NathanHowell/minimeater/hw/tools/README.md

# PCB scripts

The board is laid out by hand through Konnect (live KiCad); see `hw/layout/README.md`. The first-pass autorouter and
its one-off rework scripts were retired (in git history before the re-layout).

- `pcbdump.py <board> <out.json>` (KiCad's python): pads, tracks, vias, zone fills, courtyards to JSON.
- `render.py <dump.json> <out.png> [--refs ... | --bbox ...] [--layers ...] [--rats]` (uv, matplotlib): copper
  coloured and labelled by net, for layout reviews.
- `montage.py <dump.json> <out.png>` (uv, matplotlib + pillow): every block and the board at one scale, coloured by
  netclass (render.py `--by-class`), for placement reviews. Every net leaving a block (GND aside) gets a port arrow
  at its exit (open track end, else the pad nearest the edge) labelled `net > destinations` and coloured by
  destination; the fixed parts' pins get the same, pointing into the board (render.py `--ports`, `--only`).
- `blockcheck.sh <x0,y0,x1,y1> <out.png> "<title>"`: DRC items inside a block's box (`drcbox.py`) plus its F.Cu render.
- `parts.py` (`just hw::parts <out.json>`): each reference's footprint and courtyard box from the schematic and libraries.
- `kdrc.py`: kicad-cli DRC from KiCad's python, returns the violations.
- `fab.py` (`just hw::fab`): gerber zip, JLC BOM and CPL into `hw/fab/`, from a zone-refilled copy;
  plus a one-up assembly panel (`minimeater-panel-*`: 5 mm rails left and right, mouse bites, three 1.152 mm NPTH
  tooling holes and three fiducials on the rails) when KiKit is installed in `hw/.kikit` (see the script's docstring).
- `silk.py` (KiCad's python, KiCad closed): the silk pass. References at JLC minimum size placed beside their part
  where they fit, else hidden; back-silk labels for the test points (net names) and J6/J7 (FAN/SERVO).
- `silk_back.py` (KiCad's python, KiCad closed, after silk.py): the back's artwork, the face seen with the case open.
  Probe numbers P0-P3 between the jack pegs, the flame, wordmark and open-source-hardware mark, rev/date, JLC's order-number marker, a QR code to
  the repository (KiCad 10 barcode, knocked out of a silk square so it reads dark-on-white), KK pin names, USB. Kept in
  the group `silk_back`, which a rerun replaces; it refuses to save if anything lands on a pad, hole, via or other silk.
- `stitch.py` (KiCad's python): edge GND stitching via candidates (JSON), plus a scratch copy with them added for a
  refilled DRC; the vias then go in through Konnect.
- `models.py`: 3D models for the mech assembly (`src/minimeater/mech/board3d.py`).
- `kk_ra_step.py`, `kk_ra.py`: the right-angle KK header STEP model and footprint.
- `connector_edge.py`: trims the connector edge so the jacks reach into the port wall (applied).

DRC: `hw/minimeater.kicad_dru` relaxes `hole_clearance` to 0.19 mm for J1 only (the GCT USB4105-GF-A land pattern
puts its GND pads 0.1944 mm from the locating pegs), and KiCad's 1 mm barcode separation to 0.3 mm (the QR code's
quiet zone is its own silk border).
