NathanHowell/minimeater/docs/cfd.md

# Duct CFD and acoustics

What the air does between the fan and the tube: the pressure the duct costs the fan (`.2.12`, `.2.13`), and whether the
flap can whistle (`.2.17`-`.2.19`). The code is `src/minimeater/mech/cfd/`; the geometry comes from the same build123d
parts as the print (`mech/parts.py`), so a change to the duct or the flap is a change to the case.

## Steady RANS: `just mech::cfd::run <case>`

`just mech::cfd::run <case> [--flap DEG] [--cfm Q] [--rpm N]` builds the air volume, meshes it and solves it in
OpenFOAM v2606 (`opencfd/openfoam-run:2606`, arm64, in Apple's `container`; no build), and writes
`build/cfd/<case>/results.json`. Named cases: `open`, `open-swirl`, `open-vortex`, `flap-30`, `flap-45`, `flap-60`.

- **Geometry** (`geometry.py`): the fan's outlet annulus (5 mm of the frame's Ø58 bore around the Ø26.5 hub), the
  27 mm cone with the tail cone and its six stator vanes (`HubCone`, subtracted solid), the Ø32 bore with the flap and its rod at the case's angle, the 5 mm neck from it to the tube's bore at the socket's
  shoulder, and 12 diameters of the Ø30.83 tube (the results below were run on the Ø31.6 tube assumed before
  the calipers, a 0.2 mm step and no neck). Patches: inlet, outlet, duct, tube, flap. The fan's blades and struts
  are not modelled; the inlet can swirl: solid-body rotation at `--rpm`, or a free vortex at `--vortex` (r·c_θ / Q in 1/m, in the rotor's sense; `open-vortex` is 18, the Euler floor at the operating line). Every case samples U on five planes along the duct at its end; `python -m minimeater.mech.cfd.swirl <case>` reports the swirl angle, r·c_θ and the swirl's dynamic head on each.
- **Mesh**: snappyHexMesh, 2 mm background, 0.5 mm at the duct's walls, 0.25 mm on the flap, 1 mm through the bore and
  the first two tube diameters; 3 boundary layers (2 on the flap). About 0.75 M cells.
- **Solver**: simpleFoam (SIMPLEC), k-omega SST with wall functions; the fan's flow fixed into the annulus at 10 %
  turbulence; the outlet at 0 Pa. Up to 2000 iterations, 8 ranks: about 20 minutes on the Mac.
- **Loss** (`run.py`): static pressure on planes across the tube, one per diameter; a line through the last six (the
  developed flow) extrapolated back to the shoulder. Referenced to the tube's velocity head q:
  - `k_static` = (inlet static - line at the shoulder) / q: what the fan's (static) curve must supply for the duct,
    including the acceleration from the annulus into the tube. It replaces `Intake.k_box + k_entry` less the grille.
  - `k_total` = the total-pressure loss: what is dissipated.
  - The tube's own friction is in neither; the fitted line's slope is checked against Blasius.

### Results, 6 CFM (3.8 m/s in the tube)

Re-run 2026-10-18 on the current geometry (the neck, the Ø30.83 tube, the cone and its six vanes; 2000 iterations, 8 ranks,
17-28 minutes a case). The table before it was the Ø31.6 tube with no neck and no vanes: the open duct was 1.26 / 0.16, so the
neck, cone and vanes cost about 1 k_static and 1 k_total; the flap's own part is about what it was. The last two rows are at
4.2 CFM with the fan's exit profile (not 6 CFM straight).

| case | k_static | k_total | duct Δp static | tube f (Blasius 0.034) | note |
|---|---|---|---|---|---|
| open | 2.23 | 1.15 | 23.1 Pa | 0.037 | steady |
| flap 30° | 4.43 | 3.35 | 43.1 Pa | 0.047 | sheds |
| flap 45° | 11.9 | 10.9 | 107.6 Pa | 0.041 | the wake sheds; the tube has not recovered by the outlet |
| flap 60° | 52.3 | 51.2 | 457 Pa | 0.039 | far past the fan's 21 Pa shut-off, so 6 CFM never happens here (the k still holds) |
| open, the fan's exit profile, 4.2 CFM | 1.51 | 1.87 | 8.6 Pa | 0.043 | the operating point's flow, with `fan-4.2cfm-3000rpm/profile.json` as the inlet |
| flap 30°, the same | 3.84 | 4.20 | 18.6 Pa | 0.047 | |
| open, swirl 2000 rpm | 8.3 | 8.7 | 70.9 Pa | — | solid-body rotation at the rotor's speed: an upper bound, not the fan |

The swirl case is a warning, not a number: if the fan's exit swirl were anything like solid-body rotation the cone
(which spins it up as it narrows) and the bore would cost several times the straight-flow loss. The real exit swirl of
the NF-A6x25 at these flows is the input that is missing (bake-off rig, `.2.11`, or a fan model); stator vanes in the
cone are the remedy if it is large (`.2.13`).

### The tail cone's struts against stator vanes (`.2.25`, 2026-10-16)

Coarse (807k cells, base 2 mm, 8 ranks on the Mac, about 25 minutes a case), 6 CFM, the measured tube and the neck. The
swirl is a free vortex at the inlet, r·c_θ / Q = 18 per metre in the rotor's sense (Euler's floor on the model's
operating line; `HubCone.swirl`). The swirl cases were not re-run on 2026-10-18: the straight-strut rows predate the neck and the tail cone (their no-swirl case was 1.30 against 2.23 now for the open duct at 6 CFM), so read them for the differences between rows.

| tail cone held by | inlet swirl | duct Δp static | k_static | swirl in the bore | r·c_θ in the bore | swirl head, tube |
|---|---|---|---|---|---|---|
| 3 straight struts | none | 14.6 Pa | 1.30 | 1° | 0 | 0 |
| 3 straight struts | free vortex 18 | 25.1 Pa | 2.40 | 42° | -334 cm²/s | 1.7 Pa |
| 6 stator vanes | none | 18.5 Pa | 1.69 | 11° | -62 cm²/s | 0.15 Pa |
| 6 stator vanes | free vortex 18 | 13.5 Pa | 1.17 | 9° | -43 cm²/s | 0.13 Pa |

With the fan's swirl the vanes take out 91 % of the angular momentum and save 11.6 Pa, more than the whole loss of the
plain duct without swirl. Their cost when the air arrives straight (+3.9 Pa over the struts) is the risk if the real
swirl is much less than the floor; the fan's own rotor in a rotating frame (`cfd/fan.py`) checks it.

With the fan's own exit as the inlet (`--profile`, from `cfd/fan.py` below, scaled to 6 CFM: about twice the floor's
swirl, turning 66-79° at the vanes' leading edges), the solidity-1.2 vanes drawn for the free vortex lose 16.9 Pa
(26° and 3.5 Pa of swirl head left in the bore). The vanes redrawn for that inflow (`HubCone.vane_beta`, solidity 1.3)
lose 16.1 Pa, with 24° and 2.8 Pa of swirl head in the bore and 0.26 Pa in the tube. Most of the angle left in the
bore is the hub and the tip turned in opposite senses (mean c_θ about 0), not net swirl.

The inlet redrawn as a designed pair of curves (the contraction's wall tangent to both bores and a tail cone closing at
18°, `cfd/inlet.py`, docs/mech.md) loses 16.07 Pa on the same profile inlet, with 22.7° and 2.6 Pa of swirl head in
the bore: the same as the straight cone. The vanes rebuilt as one fitted surface with a millimetre root fillet
(`vane_fillet`) on it: 16.21 Pa, the same within the coarse mesh's noise (0.22 Pa of swirl head in the tube either way).

Mesh check (2026-10-16): the final design (the designed inlet, the fitted vanes, the profile inlet) on a 1.4 mm
background (1.84 M cells, 46 minutes on 8 ranks) loses 15.98 Pa against 16.21 on the 2 mm one (0.84 M): 1.4 %, so
these coarse comparisons resolve about 1-2 % and differences inside that are ties. The swirl left is the same
(2.7 Pa of swirl head in the bore, 0.2 in the tube).

The model has carried k_box 2.0 + k_entry 0.5 = 2.5 for this path; the open duct is 2.23 at 6 CFM straight and 1.51 at 4.2 CFM on the fan's profile, without the grille. The duct
does not need a change for its loss. The 45° figure is inside the range published for butterfly valves (about 10-18). With the flap partly closed the
tube's friction reads high (0.043-0.050): the wake has not died out by the fitted planes, so those k carry some of the
tube's recovery; a longer tube (`tube_d`) is the fix when the numbers matter to better than ~10 %.

### The fan in a rotating frame (`cfd/fan.py`, 2026-10-16)

Noctua's NF-A6x25 model (`mock.fan_step`): frame and rotor, the rotor's cells turning (MRF), a square plenum ahead and
a pipe of the frame's outlet bore behind, sealed to the outlet face as the duct's flange is. Coarse, 8 ranks, about 21
minutes. At 4.2 CFM and 3000 rpm (about 25 % of free flow, the model's operating point) it gives 12.0 Pa static and
21.0 Pa total; the spec curve reads about 16 Pa static there, fair for a coarse rotor mesh. (A first run without the
seal let about 1 CFM loop round the frame's outside and read 6.4 Pa.)

At this flow the rotor is near stall. Inside r ≈ 17 mm the flow recirculates and the air leaves through r 21-29.
r·c_θ / Q runs from -17 to -56 per metre across the annulus, -39 flux-weighted: about twice Euler's floor of 18 that
the vanes were first drawn for. `profile.json` holds the binned c_x and r·c_θ, and `--profile` hands them to the duct
cases as their inlet (`Case.profile`, scaled to the case's flow).

### The intake grille and the gap to the rotor (`cfd/grille.py`, `.2.26`, 2026-10-16)

This is fan.py's case with a room behind the rear face (slip walls, uniform inflow 25 mm out). Then come the rear wall
with its grille, the cavity's section carried from the wall to the fan, and the fan with its sealed pipe. It is run at
the same flow and speed as the free-air case, so the static rise lost against 12.0 Pa is what the wall and the gap cost
the fan. The gap is added to `rear_gap` (4.5 mm); the S-louvre is the concept insert (round field, S blades, hub cover).

| grille | gap added | fan static rise | intake angle | backflow at the rotor face |
|---|---|---|---|---|
| none (fan.py) | | 12.0 Pa | | |
| current straight louvres | 0 | 2.9 Pa | 66° | 26 % |
| current straight louvres | 5 mm | 5.0 Pa | 68° | 35 % |
| current straight louvres | 10 mm | 6.7 Pa | 62° | 24 % |
| current straight louvres | 20 mm | 7.4 Pa | 60° | 21 % |
| current straight louvres | 30 mm | 8.3 Pa | 60° | 22 % |
| S-louvre concept | 5 mm | 1.1 Pa | 68° | 33 % |
| S-louvre concept | 10 mm | 4.0 Pa | 62° | 23 % |

The wall and the 4.5 mm gap cost the fan about three quarters of its static rise, and the gap is what matters: the
first 10 mm give back 3.8 Pa, the next 20 only 1.6 more. The S-louvre concept is worse than the straight louvres at the same gap; its deep field
and hub cover crowd the rotor's inflow. The mesh is coarse (grille level 2) and steady MRF of a fan near stall is the
weakest part of these models, so take the trend, not the numbers.

The gap is now 14.5 mm (`Layout.rear_gap`, `.2.28`). Run with the shells' own shim blocks and the four Ø4 rest pads
standing in the plenum (`gap` 0 at the new rear_gap), the fan keeps 7.3 Pa static (15.6 total), the intake at 60° with
23 % backflow: the pads, out at r 34 in the frame's corners, cost nothing measurable.

The chevron grille (eight gills, 1485 mm², the seam climbing with them) with the 5.1 mm rear wall and the 12.6 mm
plenum it leaves keeps 6.8 Pa (pitch 6.05 gave 7.0, so the pitch's last 0.07 mm is noise). Shaping the plenum
(`--plenum`, all at that grille):

| plenum | fan static rise | total | intake angle | backflow at the rotor face |
|---|---|---|---|---|
| plain | 6.8 Pa | 15.7 Pa | 61° | 25 % |
| ribs: 12 radial, 1.2 thick, r 25-34, wall to 2 mm off the frame | 11.1 Pa | 19.3 Pa | 52° | 22 % |
| the shells' ribs: the same, to 4 mm off the frame, with the fan's four M3 heads | 10.6 Pa | 18.4 Pa | 52° | 23 % |
| dome: a half-ellipsoid r 12.5 over the hub, 1 mm off it | 5.9 Pa | 14.6 Pa | 60° | 24 % |
| ring: r 29.5 separator at the tips, the ribs outside it | 3.9 Pa | 12.4 Pa | 66° | 29 % |
| bell: a 6 mm quarter round down to the fan's bore | 2.8 Pa | 10.2 Pa | 68° | 37 % |

The ribs take the swirl out of the blade tips' recirculation, so the air coming back in meets the rotor without
pre-swirl, and the fan keeps nearly its free-air 12.0. The ring and the bell narrow what the recirculation has to turn
in and lose more than half; the hub carries almost no flow, so the dome only crowds it. As modelled the ribs sit at
15° + 30° steps, one on each diagonal where the fan's M3 heads are. The shells carry them (`shell.tip_ribs`,
`Shell.tip_ribs`) stopping 1 mm short of the heads' 3 mm, so the hood and the pan close past the heads: 4 mm off the
frame, which with the heads in the plenum costs 0.5 Pa of the 11.1. The grille case now always has them (`--plenum`
adds to them); the plain plenum's 6.8 is kept in `grille-current-gap0-4.2cfm-noribs`.

#### Inside the plenum, the exterior unchanged (`.2.34`, 2026-10-18)

Steady MRF this near stall does not settle: the fan's static rise wanders about ±0.5 Pa over the last few hundred
iterations, so the case now reports its mean over the last sixth (`dp_static_mean_pa`) and differences under about
1 Pa are noise. `just mech::cfd::fields CASE [CASE ...]` cuts slices through finished cases (two
sections across the gills, three planes facing the fan) and draws speed, axial velocity, cross flow and total
pressure side by side; it reads the last time step every case keeps.

The baseline's field: the gills' jets keep rising at 43° across the plenum, so the lower rows carry the flow and the
top two barely breathe (0.1-1.3 m/s); the blades take nearly all their inflow inside r 25, with the tips' backflow
ring outside it (from r ~21 at the bottom); the air entering at r 17-25 carries the ring's swirl in the rotor's
direction (-0.4 to -1.8 m/s). Designed from that, against the baseline's 10.4 Pa mean:

| plenum | static rise (mean) | what it did |
|---|---|---|
| the shells' ribs (baseline) | 10.4 Pa | |
| ribs 2 mm off the frame, notched round the heads (`ribs2n`) | 10.5 | |
| ribs to the walls, 1 mm off over the blades and 0.3 beyond the bore (`d2-ribs`) | 10.6 | |
| the same tilted 15° against the rotor (`d3-ribs`) | 9.9 | no counter-swirl reached the blades |
| ribs from r 17 to the walls (`d1-ribs`) | 8.4 | less pre-swirl at r 17-25, 7 % less rotor torque |
| a turning lip under each gill, outer rows aimed in (`d1-lips`) | 9.7 | every row jets level; more inflow at the tips |
| both (`d1`) | 8.6 | |

The rotor's efficiency stays at 0.20-0.22 in every case, so its pressure follows the work it takes in, and that
falls whenever the inflow moves toward the tips or the ribs reach into the blades' intake band. Evening out the
grille's jets does not help: the rotor sees well-mixed plenum air either way. Nothing inside the plenum beats the
shells' ribs by more than the noise; the shell is left as it is.

### The natural draft with the fan stopped (`.2.35`, 2026-10-18)

Most of a cook runs on the egg's own draft with the fan off, so the stopped path sets the silent range. The grille
case with the rotor a still wall (`--stopped`: no rotating frame) and the duct case (`open`), both laminar
(`--laminar`: Re about 200 in the gills and 1300 in the tube at 1 CFM), at 1.0 and 0.5 CFM. The duct cases converge
by about 400 iterations (their 500-iteration `pt_in_spread_pa` then includes the start and reads high); the grille
cases run their 1500 for about 30 minutes, as with the fan turning.

| stretch (total pressure lost) | 1.0 CFM | 0.5 CFM |
|---|---|---|
| room to the gills' exit | 0.105 Pa | 0.038 Pa |
| across the plenum and ribs | 0.03 | 0.008 |
| the stopped rotor and frame | 0.093 | 0.030 |
| the duct: cone, stator vanes, open flap, 12 diameters of tube | 0.67 (1.04 static) | 0.23 (0.33 static) |

The planes' area weights recover 0.8-1.0 of the flow, so the split is to about 10 %. Halving the flow cuts every
stretch by about 3 (Δp ~ Q^1.65): mostly the sharp-edged, quadratic kind of loss, with a viscous part that grows as
the flow falls. The duct, about half of it the tube's still-developing laminar flow, is most of the loss; the
stopped rotor is about a tenth of it.

The rotor's part referenced to the velocity through the fan's open area is k = 3.2 at 1 CFM and 4.2 at 0.5, against
the 1.5 the airflow model estimated (`Fan.stopped_k`, now 3.2 for the NF-A6x25). That moves the model's natural-draft
flows by 1-3 % (docs/modeling). A passive bypass round the stopped fan could win back at most that much, so it is not
worth a moving part.

### Pathlines through the whole airway (`cfd/pathlines.py`, `just mech::cfd::pathlines`, `.cp2.2`, 2026-10-17)

The animation (`docs/mech.md`) follows one air molecule from the room to the tube, so it needs lines through the grille, the fan, the stator cone,
the flap and the tube, with the speed at each vertex. The grille case and the duct case are two meshes, joined at the fan's exit:
`just mech::cfd::pathlines run --flap 0 30` runs the grille case once (4.2 CFM, the fan's operating point, at its rated 3000 rpm), writes its fan-exit
profile (`fan.profile`, the same one the duct cases take), runs a duct case from that profile at each flap angle and traces through each pair.
The result is `build/pathlines/pathlines-flapN.npz` (and a `.vtp` for ParaView): per line the points in mm in the mech frame, the particle's own
time, its absolute speed and the stage (room, rotor, duct) at each vertex.

- **Seeds.** A square lattice (2 mm) across the room's inflow face, 44 mm either side of the axis, so each seed carries the same flux and the
  density of lines is the density of the flow. 648 of about 2000 seeds get through the rotor and the stator to the duct's outlet.
- **The rotor.** The stored velocity is absolute (the MRF solver's `U`: the mean tangential speed behind the rotor, -3 to -6 m/s against
  a blade tip speed of 9 m/s, is a flow that the blades have turned, not their own motion), so a streamline of it dies inside the rotor zone, where the
  blades are moving through the cells. In the zone the line is traced through the relative velocity (U minus omega x r, the field the mesh
  sees) and then turned about x by omega times its time there, which is where the particle is in the room's frame. A test builds a field with
  a known answer (the particle turns with the rotor at constant radius while in the zone, then goes straight) and the tracer
  reproduces it. Hand-over at the zone's wall steps the seed a few cells inward, because the tracer stops a step short of an interface.
- **What it leaves out.** A steady MRF has no blades in the room's frame: the lines show the mean swirl, not blade passing. The rotor stands
  at its meshed pose at t = 0 of each line, and the film turns it by omega times that time, so the blades and the molecule are in step but
  the phase against the blade-passing is arbitrary. The other seeds, about two thirds, stop on the rear wall's plate between the gills
  (stagnation) or are trapped in the tip-gap recirculation near r = 28 mm (5 m/s, round and round until the step limit); they are dropped, so the
  lines are for looking at, not for a mass balance. Every flap angle uses the same 4.2 CFM and the same fan-exit profile: the flap's higher loss (the 30 degree duct case was 16.9 Pa static against 6.9 open on the earlier geometry, 18.6 against 8.6 on the current one, and
  its 2000 iterations had not fully converged) does not feed back to the fan.
- **Results.** Seed to the end of the duct case 148-243 ms (median 190), of which the median 6.3 ms is in the rotor zone: the speed on a line goes
  from under 1 m/s in the plenum to 9 m/s in the rotor and settles near 3 m/s in the bore. The swirl, as the angle a line turns about the
  axis per 10 mm of travel (median, lines further than 8 mm from the axis): -26 degrees in the plenum behind the rotor's inlet, -33 degrees
  in the 27 mm after it, -9 after the stator cone's struts, and -6 to -7 degrees in the tube: the stator removes about three
  quarters of the swirl, and the rest is what the `.2.25` study found (the struts straighten the flow they can reach). With the flap at 30 degrees the lines squeeze past the blade faster (6-7 m/s) and a wake of loops follows it for about 30 mm
  (`pathlines-flap30.npz`).

## Acoustics: `just mech::cfd::acoustics`

`acoustics.py`: below the bore's first cross mode (6.3 kHz) only plane waves travel, so the path is a chain of transfer
matrices: the open end behind the fan, the fan's annulus, the cone, the bore, the flap as a lumped flow resistance and
inertance, the bore, 100 mm of tube, the open end in the firebox, with Kirchhoff wall losses. A fluctuating force on the
flap is a pressure jump across it; the peaks of 1 / |Z_loop| are the modes it can drive, their Q what a feedback loop
must overcome. The flap's loss law (`open_area_fraction`, `flap_k`) is corrected to the CFD at 30°, 45° and 60°.

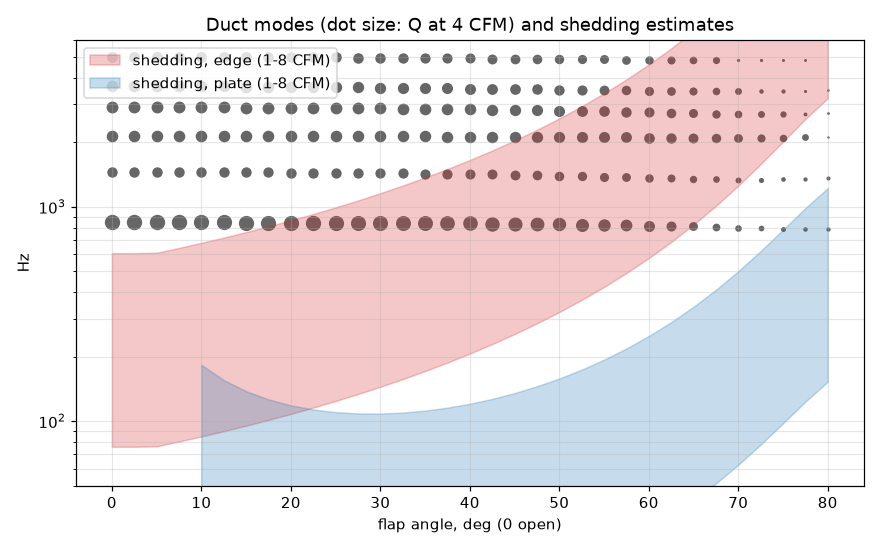
[picture p16: docs/cfd/acoustics.png]
modes and shedding


- Modes at 846, 1455, 2140, 2916, 3656, 5018 Hz with the flap open (Q 25, 12, 14, 15, 14, 13). The first is the
  path's half wave. A closing flap damps them: by 65° the first mode's Q is under 8.
- The 2 mm edge's shedding (St 0.2 on the gap speed) sweeps through the whole ladder as the flap turns and the flow
  changes; the inclined plate's wake (St 0.15 on D sin θ) mostly stays below the first mode. Frequency coincidence alone
  cannot rule a whistle out: there is always a mode near the edge's band somewhere across all angles and flows. The most
  exposed is the first mode (Q ~25) at 15-40° and 4-8 CFM, and at 55-65° at 1-2 CFM: points the firmware does not
  visit (next section).
- Whether the shedding actually feeds a mode is the LES (`.2.18`) and the forced-impedance check below (`.2.19`, `.2.20`):
  it does not, at any point the firmware visits, with or without the fan's swirl.

## Where the firmware runs it: `just mech::cfd::operating`

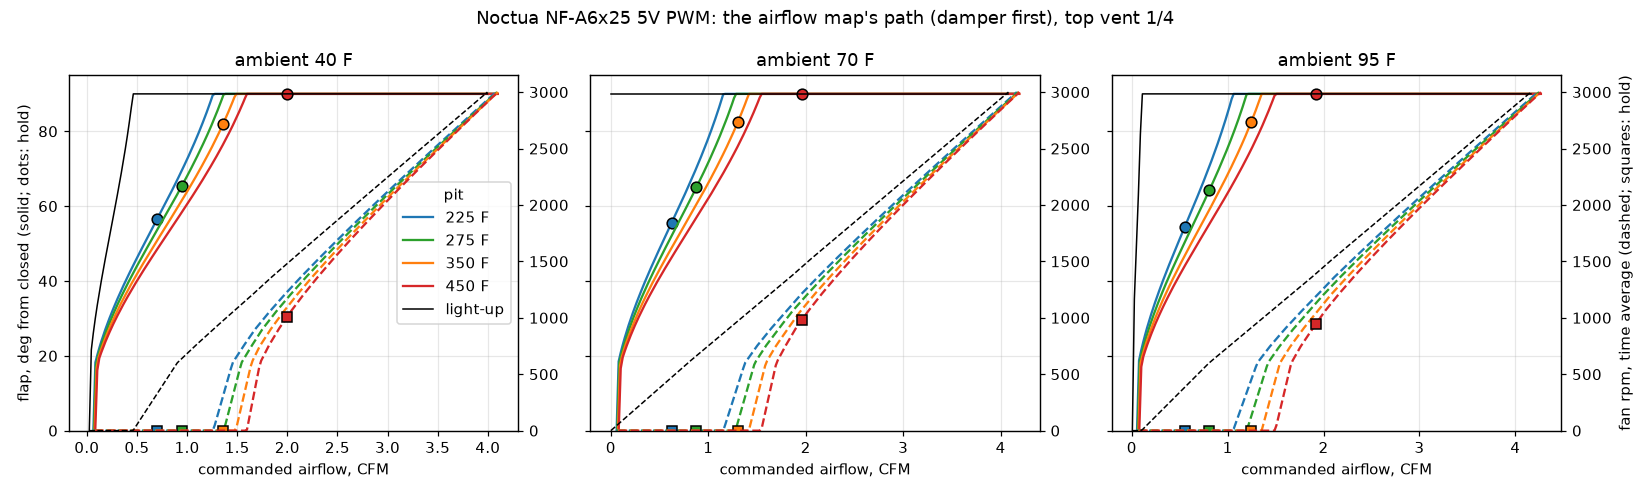
[picture p17: docs/cfd/operating.png]
operating path


`operating.py` walks the firmware's airflow map (`control.AirflowMap`, ported to `minimeater-core::model::airflow`) and
marks the hold point `FeedForward` gives for each pit temperature and ambient (NF-A6x25, top vent 1/4). The map is
damper first: the flap opens with the fan stopped, and the fan only runs once the flap is fully open (below 600 rpm it
cycles between off and 600). So the fan never blows through a partly closed flap, and light-up (the black line: a cold
pit with no draft) is the fan alone with the flap open, up to about 4.1 CFM.

| pit F | ambient F | hold CFM | flap from closed | fan | flap sees (from open, CFM) | shedding near a mode |
|---|---|---|---|---|---|---|
| 225 | 40 | 0.70 | 57 | off | 33 deg 0.70 | none |
| 275 | 40 | 0.95 | 65 | off | 25 deg 0.95 | none |
| 350 | 40 | 1.36 | 82 | off | 8 deg 1.36 | none |
| 450 | 40 | 2.00 | 90 | 1006 rpm | 0 deg 2.00 | none |
| 225 | 70 | 0.62 | 56 | off | 34 deg 0.62 | none |
| 275 | 70 | 0.88 | 65 | off | 25 deg 0.88 | none |
| 350 | 70 | 1.30 | 82 | off | 8 deg 1.30 | none |
| 450 | 70 | 1.96 | 90 | 984 rpm | 0 deg 1.96 | none |
| 225 | 95 | 0.55 | 54 | off | 36 deg 0.55 | none |
| 275 | 95 | 0.81 | 64 | off | 26 deg 0.81 | none |
| 350 | 95 | 1.25 | 83 | off | 7 deg 1.25 | none |
| 450 | 95 | 1.92 | 90 | 948 rpm | 0 deg 1.92 | none |

- Low-and-slow holds on natural draft alone with the flap 25-36° from open at 0.5-1 CFM: gap speeds of 1-2 m/s.
- With the flap open the edge's shedding is about 76 Hz per CFM (300 Hz at the fan's 4.1 CFM), under the first mode
  (846 Hz); reaching it would take about 11 CFM, past what the fan can push through this path.
- Along every path in the chart, light-up included, no shedding estimate comes within 15 % of a mode. The partly
  closed, high-flow points that crossed the modes in the acoustics chart do not occur under this map.
- That rests on the damper-first map: blending the flap and the fan (the fan running through a partly closed flap)
  would put the operating points back where the chart above shows crossings. Keep it, or re-run this check.
- Not covered: the fan's own tones. Its blade-passing frequency (rpm / 60 × the blade count) and harmonics can drive the
  duct's modes directly, flap or no flap; the 846 Hz mode is the one to watch. That is the fan's noise, not the flap's,
  and belongs with the bake-off (`.2.11`).

## LES of the flap: `just mech::cfd::les` (`.2.18`)

`les.py` runs the same air volume and mesher as the steady case under incompressible LES (pimpleFoam, WALE, Spalding wall
functions, backward in time, LUST for the convection) and `les_post.py` turns the time series into spectra. It runs in the
same OpenFOAM container, under whichever runtime the machine has (`runtime.py`: Apple's `container`, podman, docker; the Linux
box uses podman, rootless).

    just mech::cfd::les --flap 33 --cfm 0.7 --res coarse      # one case: build/les/round-33deg-0.7cfm-coarse
    just mech::cfd::les --sweep --res coarse                  # the operating points below, one after another
    just mech::cfd::les --flap 33 --cfm 0.7 --dry             # write the case, print the time step and step count
    just mech::cfd::les --flap 33 --cfm 0.7 --mesh-only       # mesh it, report the cell count
    just mech::cfd::les --flap 33 --cfm 0.7 --resume          # carry on from the last checkpoint after a stop (same arguments)
    just mech::cfd::les-post build/les/*                      # spectra, peaks, les.png, les.json, spectra.npz
    just mech::cfd::les-post --compare build/les/A-coarse build/les/A-medium    # the shedding peak must not move (5 % or 2 bins)

- **Sizing from the flow** (`make`): the step is adjustable to Courant 0.8 (at most 50 us, the forces and probes are resampled
  to 20 kHz); the spin-up is three flow-throughs of 150 mm at half the fastest speed, then at least 0.08 s or 40 shedding
  periods to average over. Both come out of `u_ref`, the bulk speed over the share of the bore the tilted disc leaves open (x2).
  The sweep's cases need 17-32 k steps each: about 0.7-0.96 s of physical time for the 0.5-1.4 CFM holds, 0.13-0.17 s for 6 CFM.
- **Resolution** (`--res`): the background cell is 2.5 / 2.0 / 1.6 mm for coarse / medium / fine, the flap's surface cells
  base/16 (0.16 / 0.125 / 0.1 mm), a 38 mm cylinder round the flap at base/4, 6 diameters of tube. The 30 deg, 6 CFM case:
  0.84 M cells coarse (6 min to mesh), 1.35 M medium (11 min). `smoke` (0.17 M) is for checking the pipeline.
- **Inlet**: the annulus at the fan's flow with 5 % random velocity fluctuations (`turbulentInlet`, `--intensity`; 0 is a
  steady inlet); no blades. Swirl (`.2.20`): `--rpm` is solid-body rotation in the rotor's sense (its flow rate can be forced),
  `--profile` the fan's measured exit from `cfd/fan.py` (steady). The noise is white and new every step, and in an incompressible case it is felt
  at once everywhere as a pressure fluctuation: it swamps the flap's axial force above about 1 kHz, so the broadband level
  (below) takes `--intensity 0`.
- **Output** every step: force and moment on the flap and rod (about the shaft: Mz is the servo's torque ripple), p and U at
  probes (the bore wall at +-y and +-z, five stations round the flap; the axis; two points off each edge's shear layer),
  and, every 50 us, the integral of the Lamb vector omega x u over 2 mm slabs from 10 mm upstream to 40 mm downstream of
  the shaft: Howe's source for `.2.19`, to be projected on a duct mode's particle velocity. Fields: mean and rms over the
  window, vorticity, Q.
- **Flap variants** (`--variant`, `variants.py`): `round` (the design), `square` edge, `serrated` (24 V notches, 1 mm), `rib-square`,
  `rib-long`. They are `Damper` parameter sets handed to `parts.flap(dm)`; the design is untouched. A serrated edge leaks when
  shut (about 0.4 cm^2 against the 0.3 target, 0.15 for the round edge: `variants.leak_cm2`; the notches near the rib are skipped, so fewer than 24 count), so it only earns its place if the whistle risk needs it.

### What the sweep is (`SWEEP`)

The damper-first map never runs the fan through a partly closed flap (above), so the cases are the ones it visits: flap
33 deg at 0.7 CFM, 25 deg at 0.95, 8 deg at 1.36 (the natural-draft holds), the open flap at 2.0 and 4.1 CFM (fan, light-up),
and the two points off the map where the acoustics chart crosses the modes (30 deg and 45 deg at 6 CFM, the steady CFD's anchor)
in case the map ever blends fan and flap. Most are low-Reynolds flows (the bore's Re is 900 at 0.7 CFM, 5000 at 4.1):
laminar or transitional, where WALE adds no viscosity and the LES is closer to a DNS of weak shedding. The wall-pressure
and force levels there decide whether the 6 CFM points even matter.

### Cost (measured on the smoke case, 12 cores shared)

The pipeline ran end to end on the 168 k-cell smoke mesh: 0.26 s a step on 8 ranks, about 1.5 us per cell per step. That puts
a medium case (1.35 M cells, 17-20 k steps) near 11 h on this box, coarse near 6 h, and a fine one a day. The coarse sweep is
about 1.5 days, the medium one 3-4. Not measured at medium yet: time one case's first steps before committing to the sweep.

## The whistle verdict: `whistle.py` (`.2.19`, 2026-10-19)

    just mech::cfd::les --flap 33 --cfm 0.7 --res smoke --no-howe --force-hz 846 --force-amp 0.05   # a forced run
    just mech::cfd::les --flap 0 --cfm 4.1 --res smoke --no-howe --intensity 0                      # an unforced, steady-inlet run
    just mech::cfd::whistle build/les/<case>...                     # one JSON line per case

**Can it whistle?** The flap is about 1/20 of the first mode's wavelength, so it is compact: a duct mode looks to it like an
oscillating flow. A forced run oscillates the inlet by 5 % at a mode's frequency, and the part of the flap's axial force
(as a pressure jump over the bore) in phase with the oscillating flow is the flap's acoustic resistance, Re Z_flap (Testud
and Aurégan's whistling potentiality for orifices). If it is negative the flow feeds the mode, and the mode whistles if
that beats the rest of the loop's resistance (walls and the two open ends: `acoustics.loop` less the flap's own model).
Smoke mesh, the first two modes at every point the damper-first map visits (Pa s/m^3; build/les-screen.jsonl):

| flap from open | CFM | Re Z_flap, mode 1 | Re Z_flap, mode 2 | rest of the loop, mode 1 / 2 |
|---|---|---|---|---|
| 33 deg | 0.70 | +3,180 (846 Hz) | +6,270 (1431 Hz) | 158,300 / 282,400 |
| 25 deg | 0.95 | +2,020 (845 Hz) | +4,060 (1441 Hz) | 158,300 / 275,600 |
| 8 deg | 1.36 | +1,040 (849 Hz) | +1,910 (1454 Hz) | 158,400 / 268,000 |
| open | 2.0 | +950 (850 Hz) | +1,800 (1456 Hz) | 158,400 / 267,000 |
| open | 4.1 | +950 (850 Hz) | +1,140 (1456 Hz) | 158,400 / 267,000 |

- The flap's resistance is positive everywhere: it absorbs the modes. It does not just fail to beat the loop's losses; it
  never feeds them at all. The flow-driven margin is set by the open flap at 4.1 CFM (light-up), the least resistive.
- The coarse mesh (0.84 M cells) at that point: +1,090 at 850 Hz and +1,450 at 1456 Hz (build/les-coarse.jsonl), 15-27 %
  above the smoke mesh. The smoke screen errs on the side of a whistle, and the sign does not move with resolution.
- The reactive part comes out at 17-45 % of the lumped model's inertance (`flap_z`): the model overstates the flap's mass, which
  shifts the modes slightly and decides nothing.
- Not done: the compressible cross-check (rhoPimpleFoam). With the resistance this far from zero it would not change the
  answer.

**How loud is the shedding?** Unforced, the axial force's PSD is the pressure jump's, carried through the duct's chain to
the two open ends: dB(A) at 1 m from the grille end (a point source into the whole sphere) against the fan's 19.3 dB(A),
and the sound power into the firebox (build/les-broadband.jsonl, smoke mesh):

| flap from open | CFM | inlet | room, dB(A) at 1 m | peak | firebox, dB re 1 pW |
|---|---|---|---|---|---|
| open | 4.1 | steady | -16.1 | 1444 Hz (mode 2) | -13.3 |
| 33 deg | 0.7 | steady | -65.6 | 1421 Hz (mode 2) | -35.2 |
| open | 4.1 | 5 % `turbulentInlet` | 24.9 | 2960 Hz | 35.1 |
| 33 deg | 0.7 | 5 % `turbulentInlet` | 1.3 | 2800 Hz | 11.2 |

- With a steady inlet the flap radiates 35 dB under the fan at light-up and nothing audible at the holds. The edge's
  shedding is at 72-110 Hz (the edge probes' u_y, the cross force), far under the first mode, as `operating.py` predicted.
- The `turbulentInlet` rows are the inlet's noise, not the flap: their force spectrum climbs to the 10 kHz Nyquist, and
  every pressure probe, upstream and downstream alike, shows the same spectrum with the same peak (5.1 kHz). That is the
  incompressible pressure answering the inlet's per-step random velocity across the whole domain at once.
- What it leaves out: the fan's swirl and blade wakes as real inflow turbulence (the duct cases take a fixed profile) and the
  fan's own tones driving the modes directly (`.2.11`).

**With the fan's swirl (`.2.20`).** The fan only runs with the flap open, and its swirl puts the edge-on disc at an angle
of attack: the one way the light-up point could start shedding. The stator vanes take most of it out, but not all (about
24° left in the bore on the fan's measured exit, above). Open flap, 4.1 CFM, smoke mesh (build/les-swirl.jsonl):

| inlet | Re Z_flap, 850 Hz | Re Z_flap, 1456 Hz | room, dB(A) at 1 m | peak | firebox, dB re 1 pW |
|---|---|---|---|---|---|
| axial | +950 | +1,140 | -16.1 | 1444 Hz | -13.3 |
| solid body, 750 rpm | +970 | +1,230 | | | |
| solid body, 1500 rpm | +970 | +1,320 | | | |
| solid body, 3000 rpm | +950 | +1,080 | -9.0 | 181 Hz | 16.4 |
| the fan's measured exit (`--profile`) | | | -36.7 | 144 Hz | -12.5 |

- Swirl leaves the flap's resistance where it was (within 15 %, all positive, all under 1 % of the loop's): still no
  whistle. Solid body at the rotor's full speed is far more swirl than the vanes let through, so this brackets it.
- The level goes up with heavy swirl (-9 dB(A), 28 dB under the fan) but the energy is in a 150-180 Hz wake under the
  first mode, where the A-weighting and the duct both take it down. On the fan's measured exit it is -37 dB(A).

**Verdict:** the round edge stays; no machined runner-up flap in the order, and the square, serrated and ribbed variants
are not needed. Checked on the first build by ear (`b4z`).

## Not yet in it

- The duct and the fan in one case (the duct cases take the fan's exit as a fixed inlet profile); the LES has no blade wakes.
- The flap's torque on the servo (the flap patch's force and moment are on the mesh).
