NathanHowell/minimeater/docs/jlc3dp.md

# JLC3DP: materials and the threaded-insert service

Researched 2026-10-12 from JLC3DP's own help pages (links below); nothing here has been ordered. Numbers are the vendor's.

## What we need from the plastic

- The duct's socket slides onto the egg's intake tube and the O-ring seals there. That tube is hot (the `.2.5` thermal check has not been done), so heat deflection matters more than anything else for `duct`. The shells and the flap are cooler; the shells are outdoors in sun and weather.
- The parts were designed for FDM: 2.4 mm walls, 44-degree overhangs and teardrop holes so they print without supports. They print as well on MJF (no supports needed there at all).

## Materials

| Material | Process | HDT (vendor) | Limits | Notes |
|---|---|---|---|---|
| [ASA](https://jlc3dp.com/help/article/ASA-Plastic) | FDM | 97.8 °C | 250 mm cube, ±0.3 mm or 0.4 %, 1.6 mm wall (1.2 min), black or white | UV-stable, what the design assumed; marginal for the socket |
| [PA12-HP](https://jlc3dp.com/help/article/PA12-HP-Nylon) | MJF | 175 °C (ASTM D648, 0.45 MPa) | 370 × 276 × 360 mm, ±0.3 mm within 100 mm and ±0.4 % above, 1 mm wall, natural grey | no supports; load rating at 1.82 MPa not given |
| [PA11-HP](https://jlc3dp.com/help/article/pa11-hp-nylon) | MJF | 185 °C at 0.45 MPa, 54 °C at 1.82 MPa | | the two-load figure shows how much the number depends on stress |
| [JLC Temp Resin](https://jlc3dp.com/help/article/jlc-temp-resin) | SLA | 101 °C, Tg 130 °C | not for outdoor or UV; yellows with heat | brittle; inserts must be pressed or glued, not heat-set |
| [PA12S-HP](https://jlc3dp.com/help/article/pa12s-hp-nylon) | MJF | 175 °C (load not stated) | 370 × 276 × 360 mm, ±0.3 mm / 0.4 %, wall > 1 mm, black or grey | PA12-HP in black |
| PAC-HP | MJF | 80 °C (2023, no load stated) | | full colour; no |
| [1172 Pro](https://jlc3dp.com/help/article/Precimid-1172-Pro) | SLS | 179 °C at 0.45 MPa (ASTM D648) | 250 × 250 × 590 mm, wall ≥ 1 mm, white | the hottest nylon listed |
| [3301PA](https://jlc3dp.com/help/article/3301pa-nylon) | SLS | 147 °C at 0.45 MPa, 55 °C at 1.8 MPa | 350 × 350 × 400 mm, white | |
| [3401GB](https://jlc3dp.com/help/article/3401gb-nylon) | SLS | 150 °C at 0.45 MPa, 60 °C at 1.8 MPa | 340 × 340 × 400 mm, grey-white | glass-bead filled |
| [PEEK](https://jlc3dp.com/help/article/peek-plastic) | FDM | 144 °C at 1.8 MPa (ISO 75-f) | 580 × 480 × 480 mm, wall > 1.6 mm, ±0.3 mm, brown only, from $3 | the best heat figure at a real load; the dearest |
| [PEKK](https://jlc3dp.com/help/article/pekk-plastic) | FDM | 139 °C at 0.45 MPa | as PEEK | |
| [PPA-CF](https://jlc3dp.com/help/article/ppa-cf-plastic) | FDM | 84 °C at 0.45 MPa | as PEEK, black | no better than ASA |
| [PA12-CF](https://jlc3dp.com/help/article/PA12-CF-Plastic) | FDM | 105 °C at 1.8 MPa | 580 × 480 × 480 mm, wall 1.6 (1.2 min), black | |
| [9000HE](https://jlc3dp.com/help/article/9000he-resin) | SLA | 60 °C (ASTM D648, 66 psi) | | no |

Their pages give the load for each figure inconsistently: 0.45 MPa numbers (PA12-HP 175, 1172 Pro 179) are not comparable with 1.8 MPa ones (PEEK 144, PA12-CF 105). The duct carries almost no load, so the 0.45 MPa figures are the relevant ones for it, but two of the pages show how far a nylon falls at 1.8 MPa (3301PA: 147 to 55 °C).

Decided 2026-10-14 (`minimeat-dx8`): **all three printed parts in MJF PA12S-HP, black.**

- **`duct`:** the hot part gets a 175 °C material. Step up to FDM PEEK only if the tube temperature check (`.2.5`) finds the socket hotter than about 140 °C; PEEK costs about three times as much and is brown only.
- **`hood` and `pan`:** the same material instead of ASA. One material and one process; the few 1.0-1.2 mm edges JLC's check flagged (the eave, the seam skirt by the vents, the grille's rim) pass MJF's 1.0 mm minimum and would not pass ASA's 1.2; black for UV, grey nylon's weak point (general knowledge, not from JLC's pages). Nylon takes up some water; the fits and screw bosses allow for it.
- The parts keep their FDM rules (44° overhangs, teardrops, 2.4-2.8 mm walls): harmless on MJF, and they can still be printed on FDM, except the duct: its stator vanes' cambered undersides (six patches near the leading edges, about 51 mm² each) would need supports inside the contraction. The duct is MJF only.
- Tolerance is ±0.3 mm either way. The O-ring groove (1.9 mm deep, squeeze 18 % on paper, the test wants 10-30 %) would swing about ±12 % at that tolerance; widen the margin or order the duct with the groove machined if the first seals leak.

## The threaded-insert service

Sources: [service page](https://jlc3dp.com/help/article/threaded-insert-service), [design guide](https://jlc3dp.com/blog/threaded-inserts-3d-printing).

- Eight brass types only, no custom sizes: M3 (types 1-5, 3-6.4 mm long), M4 (6: `M4*5*4`, 7: `M4*5*8`) and M5 (8: `M5*6*5`). Hole diameters and depths are fixed per type (M4: Ø4.6, 6 or 10 mm deep; M3: Ø3.6-4.0; M5: Ø5.9).
- Rules: 3.0 mm minimum wall around the hole, a flat mounting surface of at least 14 × 14 mm. Orders must come with a 2D drawing (PNG or PDF) marking each insert's type and position. 500 or more inserts add lead time.
- Technologies: the guide rates MJF and SLS nylon "excellent" (heat-set), SLA resin unsuitable for heat (press or glue), FDM PLA workable. **ASA is not mentioned**; the service page does not say which processes it covers, and gives no price, minimum order or standard lead time. These are questions for their support chat.
- No M2 or M2.5. Our small screws (M2 servo, M2.5 board and shell, M2 shells) cannot use the service; they go into the plastic directly (thread-forming screws take well in nylon), or we fit our own inserts.

### What it does to our design

Decided 2026-10-14: **the service is not used.** The one M4 insert went with the thumbscrew: the socket's lobed extension grips the tube instead (`minimeat-e5g`). What follows is the reasoning as it stood.

The only insert is the M4 for the thumbscrew in the duct's boss, and it does not fit the service's rules: the boss is a 9.4 mm block with a Ø5.6 hole (a typical heat-set size), so the wall is 1.9 mm, not 3.0, the hole is 1.0 mm wider than their Ø4.6, and the flat is not 14 × 14. Using the service would mean a bigger block (at least 10.6 mm across the hole, and 14 × 14 flat) and the Ø4.6 hole in the CAD, and the flat does not fit: the boss stands between the hood's front face (x -11) and the socket's mouth (x 0), so it can be at most about 10.5 mm along x unless the socket or the nose moves. So the boss stays as it is (Ø5.6 × 4 mm pocket) and takes a short M4 × 4 brass heat-set insert, pressed in with a soldering iron with the small ones (heat-set holds well in PA12).

### Should the M2 and M2.5 screws become M4 to use the service?

No. The service's M4 rules (a Ø4.6 hole, a 3.0 mm wall around it so a boss of at least 10.6 mm, a 14 × 14 mm flat) do not fit any of those places, and three of them cannot change at all:

- **Servo tabs** (2 × M2): the HS-5065MG's holes are Ø2.0.
- **Board** (M2.5 into three Ø5.5 standoffs): the PCB holes are Ø2.7; an M4 boss would be 10.6 mm across and need a 14 × 14 flat on a 46 × 52 mm board's worth of floor.
- **Shell columns** (2 × M2.5 × 20, 2 × M2 × 16, 6 mm bosses in 2.4 mm walls): the same problem. The hood and pan are also the ASA parts, where the service is not stated.

The M3 types (hole Ø3.6, a 9.6 mm boss, the same flat) are no better. Use the service for the one M4. For the small screws: thread-forming screws straight into the MJF nylon, or heat-set M2/M2.5 inserts we press in ourselves (about 12 per unit; cheap, a soldering iron on nylon) if the case is opened often, which it is: the button is pressed with it open.

### The flap is machined, not printed

The disc's edge and its D-bore need ±0.05 mm; the vendors print to ±0.3 mm. The flap is a CNC part in `minimeater-cnc.zip` with the crank and the coupler, and the printed duct's bore at the flap station is reamed to size after printing (Ø32 H7, +0.025/0, about 40 mm: a standard 32 mm machine reamer in a drill press or a lathe, fed from the fan's end through the cone and stopped before the neck at x = -25, which is narrower; the bore was Ø31.6, which has no stock reamer). Without the ream the gap swings from jammed to a 0.36 cm² leak (`tests/test_mech.py::test_flap_fit_needs_the_bore_reamed`).

## JLC3DP's thin-wall heatmap (checked 2026-10-12)

The upload page colours walls under 1.2 mm yellow and under 0.5 mm red. A first upload of `duct`, `hood` and `pan` lit up in several places. Each one was checked by casting a ray inward from 40,000 sample points on the surface of each part (the distance to the opposite face is the wall there) and clustering the thin ones; edge samples are noisy, so what follows is what the clusters and the geometry agree on.

Fixed:

- **The 0.2 mm web between the USB-C opening and the first jack's** (the one that was too thin): the two openings are now one cut (`shell.port_openings`). I made it by widening the USB-C opening to 13.2 mm; the web was my mistake.
- **Louvre blades, 0.81 mm** (the 3.0 mm slots cut at 44° leave 5.3 × cos 44° - 3.0): slots 3.2 at a 6.2 mm vertical pitch, blades 1.26 mm, open area 1520 mm² (it was 1583; the test wants 1500). The louvre field is 4 mm taller so the last slot leaves no sliver.
- **The seam, 0.8-1.0 mm**: the hood's outer skirt is the wall less the pan's tongue and 0.2 clearance. The shell wall is now 2.8 mm (seven perimeters) with a 1.3 mm tongue and rib, so the skirt is 1.3 mm. The envelope grows to 75.2 × 73.9.
- **The rod's blind pocket** left a 0.6 mm skin under the duct; now 1.2 mm (the rod is 0.6 mm shorter, 42.4 mm).
- **The shelf's rear edge**, a knife edge: a 1.2 mm vertical land now stops the lean.
- **The rear screw columns' sleeve, 0.08 mm** (second upload): the pan's M2 head channel (radius 2.15) was nearly tangent to the cavity wall at y 29.9, so a sheet of that thickness stood between them over 20 mm of height. The pair moved out to |y| 33.3 (`rear_screw_y`): 1.2 mm to the cavity, 1.3 mm to the hull, and the fan's screw heads still clear. That 1.2 was measured to y 29.9; the fan shim block's face is at 30.4 (the fan's 0.4 mm play), so the sleeve was really 0.75 mm over about 20 × 5 mm in the plenum, JLC's "B 0.75" in the third review (2026-10-22). The rear column is now Ø7 (`shell.REAR_BOSS_D`) and bulges 0.45 mm into the plenum past the block, a 1.35 mm sleeve; the fan's M3 heads are 2 mm away (`minimeat-e97`).
- **The front shell screw columns**: the head channel (Ø5.8) nearly equalled the column (Ø6), a 0.1 mm sleeve. The column is 6.7 mm with a Ø4.6 channel, a 1.05 mm sleeve. 6.7 is the most that works: bigger columns make the pan fail to tessellate in OpenCascade.

Left, and why:

- **Knife edges** where a 44° face or a fillet meets a surface (the teardrop tips of the servo bosses, the bay's 45° end wall and floor edge, louvre blade tips at the faces): they come with the supportless geometry. The flagged volume is small and a slicer or MJF handles them. Roughly 100 duct samples and the bay's end-wall clusters in the pan are of this kind.
- **The hood roof's rear edge above the grille**: the louvre field's cutter runs 4 mm into the cavity and leaves the roof's rear underside as a 44° wedge that comes to a point (red, 0.0-0.5 mm, 20 mm wide). Ending the cutter at the wall instead leaves a square 2.8 mm edge, which prints as an overhang over the 60 mm² per-patch limit in `test_prints_without_support`, so it stays.
- **Blade tips and the grille's rim**: each louvre blade is a parallelogram with 46° corners, so its ends are flagged yellow along every edge, and the 1.2 mm rear lip sits exactly on the threshold. Both come with the 44° louvres.
- **A 3 mm² patch where the rear screw channel meets the fan shim block's bottom face** (z -26 to -30, 0.1-0.3 mm): small, and the block is a locating aid, not a structural part.
- **The eave and its drip lip** at about 1.0 mm.
- **Around the ambient vents** (x -87 to -60) the seam skirt is 1.1 mm.

Third review (2026-10-22, JLC marked A 0.46, B 0.75, C 0.10). The first two rounds were checked by hand from a coarse ray sample; this one has a tool, `just mech::thinwall` (`mech/thinwall.py`), run on the exported STLs after `mech-export`. It samples each part's surface every 0.25 mm (about 700,000 points a part, a few seconds), casts a ray inward along the normal (the wall there, as JLC's heatmap measures it), and groups the samples under 1.0 mm. A sample within t / tan a of a sharp convex CAD edge of interior angle a under 90° is a knife edge (a wedge reads d tan a at d from its edge); the rest are listed as unexplained, by area. Run it before every upload: everything it lists should be fixed or below.

Fixed (`minimeat-e97`, `minimeat-xk8`):

- **B 0.75 (pan)**: the rear screw columns, above.
- **C 0.10 (hood)**: the front pilots started 0.1 mm above the seam, and the front zone reaches the seam there, so a 0.1 mm skin closed each pilot's mouth. The pilots now start under the seam.
- **The screw columns' teardrop tips** (pan, 0.5-0.6 mm over a few mm², four places): the head channel is a teardrop pointed up, the column was round on that side. The columns are now teardrops both ways (`shell.boss_column`), so the sleeve follows the tip.
- **The drip lip**, 0.95 mm once the flank's round clipped it, and a 0.35 mm sliver at its front end where the plan closes in: 1.4 mm wide before the clip (1.2 after) and it ends 1.5 mm short of the bay's front end.
- **The servo pilots**: the outer pairs stood 0.45 mm (rear) and 0.85 mm (front) from the body's cutout. Only the middle pilot of each end is left (two M2 screws; `geom.PILOT_HOLES`), and the floors went from 1.0 to 1.2 mm.

Left, all accepted:

- **A 0.46 (duct)**: the six stator vanes' leading edges, 3-8 mm off the flange, about 80 mm² a vane under 1 mm (0.13 at the nose, 0.7 median). A NACA nose on a 1.5-2.2 mm vane has a radius of about 0.2 mm, so the first 2 mm of chord is under 1 mm thick. It is the edge of an airfoil, not a wall. It will print a little blunt, which costs a stator vane nothing; blunting it in the CAD would mean redoing the vane CFD. The trailing edges' roots at the wall read 0.89-0.98 over 1-3 mm² each (the 1.2 mm round, crossed obliquely).
- Specks under 1 mm² on the socket's mouth face, and the sub-1 mm samples on the hood's seam rib (it is 1.3 mm along its whole length in section; the samples are on its edges).
- Knife edges, as before: the 44° wedges of the rear V seam and the louvre blades' ends, the bay floor's run-out, the front cone's edges. About 600 mm² on the hood, 1400 on the pan, 40 on the duct.

None of the rest are walls.
