NathanHowell/minimeater/docs/provisioning.md

# Provisioning the device key (ATECC608B)

ADR 0005 puts the device's private key in an ATECC608B. This is how a blank chip becomes that identity, from the serial REPL
(`docs/icd.md`). The flow is `minimeater-app::drivers::identity`; the commands are `identity`, `identity provision lock`,
`identity csr` and `identity cert`.

**The locks are one way.** A chip locked with a wrong configuration cannot be fixed. Do everything below on a spare chip first
(a socketed or dead-bugged SOIC-8 on a scratch board, or a board you can spare), check the values against the datasheet, and only
then do the real boards.

## What gets set

Everything the chip came with is kept, except four fields:

| | slot 0, the key | slot 8, the certificate (416 bytes) |
|-|-|-|
| `SlotConfig` (bytes 20.. and 36..) | `0x2081`: external signing allowed, secret (never read), `GenKey` allowed | `0x0000`: clear read, clear write |
| `KeyConfig` (bytes 96.. and 112..) | `0x0033`: private key, public key derivable, P-256 | `0x001C`: plain data |

The order is the chip's: write the changed words, read the whole zone back and compare, lock the configuration with the CRC of that
image, make the key in slot 0 (`GenKey`), lock the data zone. The data lock is made without a CRC (`mode 0x81`) because the zone
holds a private key the host cannot read. The certificate slot stays writable after the lock, because the certificate arrives
after the key exists.

## Procedure

1. `identity`: reports the chip's serial, whether the configuration and data zones are locked, how many configuration words differ
   and the CRC the lock would carry. Changes nothing. Run it as often as you like.
2. Check the report against the datasheet (see "Check before the first lock" below). The CRC is printed so it can be compared with
   one computed independently from the image.
3. `identity provision lock`: does the rest, one step per line. If power fails part-way, run it again: a step already done is
   skipped, a configuration written but not locked is not rewritten, and a key that exists is never replaced.
   - The command refuses a chip locked with another configuration, a chip that is not an ATECC608, and a configuration that does
     not read back equal to what was written (nothing is locked in that case).
4. `identity csr` prints a PEM certificate request signed by the chip, subject `CN=<device id>` (`mm-` and the MAC). Sign it with
   the private CA, for example:

   ```sh
   openssl x509 -req -in mm-a1b2c3.csr -CA ca.pem -CAkey ca.key -CAcreateserial -days 3650 -out mm-a1b2c3.pem
   ```

   `openssl req -in mm-a1b2c3.csr -verify -noout` checks the request's signature.
5. Put the certificate in slot 8. The slot holds 416 bytes: a two-byte length and the DER certificate, so **at most 414 bytes**. A
   P-256 certificate with a short subject, the CA's short name and the usual two or three extensions is about 350 to 400, so keep
   the CA's subject and any extensions short (`openssl x509 -in mm-a1b2c3.pem -outform DER | wc -c` says). A REPL line is 160
   characters, so the certificate goes in as base64 words of 64 characters (48 bytes), then a save:

   ```sh
   { echo identity cert start
     openssl x509 -in mm-a1b2c3.pem -outform DER | base64 -w 64 | sed 's/^/identity cert add /'   # macOS: base64 -b 64
     echo identity cert save; } > mm-a1b2c3.cert.txt
   ```

   Paste the file into the terminal, or send it with `cat mm-a1b2c3.cert.txt > /dev/ttyACM0`. `save` checks that the bytes are a
   DER `SEQUENCE` of the length they claim and that they carry *this chip's* public key (a certificate for another board is refused
   with the slot untouched, so is the PEM text), writes the slot, reads it back and compares. `identity cert start` throws away
   what was received; `identity cert` prints the stored certificate as PEM, which `openssl verify -CAfile ca.pem` accepts if the
   chain is good. The host tests run this against OpenSSL: a CA signs the chip's request, the certificate goes in and comes back,
   and `openssl verify` says OK.

   The slot is clear read and write, and a check on the board is not a check of the CA's signature: the broker (or `openssl
   verify`) does that. Anyone with the cable can replace the certificate, but not the key.

## Check before the first lock

The configuration values were written from the datasheet (Microchip DS40002239, the configuration zone and `SlotConfig` /
`KeyConfig` tables) and cryptoauthlib's defaults, not from a chip. On the spare chip, before `provision lock`, check against the
datasheet:

- the bit meanings in `0x2081` and `0x0033` (ReadKey bit 0 = external signatures, IsSecret, WriteConfig bit 13 = `GenKey`, KeyType
  P-256, Private, PubInfo) and `0x001C` for a data slot;
- that `GenKey` is allowed in slot 0 after the data zone is locked (so a spare can be re-keyed) or not, as wanted;
- that a 32-byte clear write to slot 8 is accepted after the data lock, and that the block address (block in bits 11:8, slot in
  bits 6:3) reaches all 13 blocks (`identity cert save`, then `identity cert` showing it back, is the proof);
- that the lock command modes (`0x00` with CRC, `0x81` data without) are the ones the datasheet gives;
- that the I2C wake pulse (a write to address 0 at 100 kHz) really wakes the chip on the ESP32-C6's I2C (`identity` getting an
  answer is the proof; if it never does, the pulse is too short).

The host tests run the whole flow against a model of the chip that follows these rules, and the request it prints is parsed by
RustCrypto's `x509-cert` and verified by OpenSSL; neither says the chip agrees.

## The broker's CA

MQTT uses TLS exactly when a pinned CA is stored. After the certificate is in slot 8 (step 5), send the CA certificate the same way:

```sh
{ echo mqtt ca start
  openssl x509 -in ca.pem -outform DER | base64 -w 64 | sed 's/^/mqtt ca add /'   # macOS: base64 -b 64
  echo mqtt ca save; } > ca.txt
```

The CA certificate may be at most 480 bytes. Set the broker's TLS port with `mqtt set <host> 8883 ...`. `mqtt ca clear` goes back to plaintext
and `config` shows which. The broker's certificate must be signed directly by this CA and name the host the device connects to
(a DNS name in `subjectAltName`, or the common name); the device checks both. TLS is TLS 1.3 only (`docs/adr/0006-tls-stack.md`).

## The private CA and the broker

For five boards a few `openssl` lines are the CA. Once:

```sh
openssl ecparam -name prime256v1 -genkey -noout -out ca.key
openssl req -x509 -new -key ca.key -subj "/CN=minimeater ca" -days 3650 -out ca.pem
```

Keep the names short: the CA certificate has to fit the 480 bytes `mqtt ca` takes, and each device certificate the 414 bytes of slot 8.
Each board: sign the request `identity csr` printed (step 4 above), load the certificate (step 5) and the CA (previous section).

The broker needs its own certificate from the same CA, with the name the device connects to as a DNS `subjectAltName` (an IP address
does not match; use a name), and a listener that asks for the device's:

```
listener 8883
cafile ca.pem
certfile broker.pem
keyfile broker.key
require_certificate true
use_identity_as_username true
tls_version tlsv1.3
acl_file acl
```

With `use_identity_as_username` the certificate's common name (`mm-` and the MAC) is the user name, so an ACL can confine a device to its
own topics: `pattern readwrite minimeater/%u/#`. `just fw::interop::mosquitto-tls` runs exactly this against the firmware's session.

## Replacing a device's key

`identity rekey` says what it would do; `identity rekey replace` does it: the certificate in slot 8 is erased (first, so the device never
presents a certificate for a key it no longer holds), then the chip makes a new key pair in slot 0. The old key is gone for good. Then
do steps 4 and 5 again (`identity csr`, sign, `identity cert`). Use it when a device changes hands or its key may have been exposed; the
CA should also stop trusting the old certificate (a short certificate life, or a revocation list on the broker). It only works on a chip
provisioned here, and refuses any other without touching it. The key slot allows this after the lock by design (`SlotConfig` 0x2081),
so firmware on the board can re-key it, as it could equally sign with the key: the word is a guard against typing, not against code.
While there is no certificate, TLS to the broker fails and retries, and plaintext MQTT (no pinned CA) is unaffected.
