NathanHowell/minimeater/docs/sim/dissipation.md

# Power tree dissipation

Generated by `just model::sim` (`src/minimeater/sim/dissipation.py`). Closed form: what each part on the 5 V path burns at ADR 0004's operating points, and the junction temperature that gives with the board at its 85 C ceiling (ICD). Datasheet figures are `[spec]`; `[fig]` is read off a datasheet graph (about 1 point); `[est]` is ours. The first board's PTC (F1) is gone: U12 replaced it (minimeat-8s2). Topology, from the board: J1 - D1 - U12 - VBUS_F; VBUS_F feeds U4 (3V3: MCU, ADS122C04 DVDD, TMP117, ATECC608B), U5 through FB1 (3V3A: ADS122C04 AVDD and the probe bias) and the two load switches U6 (servo) and U7 (fan).

## Operating points

| | cook | worst normal | 1.5 A budget |
|---|---|---|---|
| 3V3 rail load (ADR 0004) | 82 mA | 352 mA | 352 mA |
| U5 load (ADS122C04 AVDD + ref, four probe biases) | 0.85 mA | 0.85 mA | 0.85 mA |
| Fan, 5 V | 30 mA | 190 mA | 190 mA |
| Servo, 5 V | 0 mA | 220 mA | 600 mA |
| U4 efficiency (curve less 2 points) | 92.9% | 93.0% | 93.0% |
| Input current at VBUS_RAW | 90 mA | 663 mA | 1043 mA |
| Power from the USB source (5.0 V) | 0.45 W | 3.32 W | 5.22 W |

U4's efficiency is Figure 9 of SLVSDG1C (3.3 V out, 5 V in) `[fig]`: 94 % at 10 mA, 95 % from 100 mA to 1 A, 92 % at 2 A. Two points come off for what the curve does not carry: its inductor, its layout and 25 C against our L1 (78 mohm max `[est]`, distributor listings) and 85 C. The datasheet gives no switching or gate-drive loss, so the curve is the only source for that part of U4's loss. The 1.5 A budget case draws about 1.04 A at the input, inside the 1.5 A the source must advertise (ADR 0004, amendment).

## Power in each part

| Part | cook (mW) | worst normal (mW) | 1.5 A budget (mW) | Basis |
|---|---|---|---|---|
| D1 SMF5V0A TVS | 2.0 | 2.0 | 2.0 | leakage 0.4 mA max at 5 V `[est]` |
| U12 TPS259531 eFuse | 1.6 | 21.9 | 52.3 | I^2 x 47 mohm (85 C max) + 250 uA IQ `[spec]` |
| U4 TLV62569 buck (with L1) | 20.8 | 87.9 | 87.9 | efficiency curve `[fig]`; conduction share below |
| U5 TLV75533P LDO | 1.6 | 1.6 | 1.6 | (5 V - 3.32 V) x load + 33 uA ground current `[spec]` |
| U6 TPS2553, servo | 0.0 | 7.2 | 49.3 | I^2 x 135 mohm (max over temperature) + 140 uA `[spec]` |
| U7 TPS2553, fan | 0.8 | 5.6 | 5.6 | same |
| **Board total** | **27** | **126** | **199** | |
| as a share of the USB power | 5.9% | 3.8% | 3.8% | |

U4's loss splits into the part the datasheet's resistances give (both FETs over a cycle at 105 C, L1's DCR, 35 uA IQ) and the rest: cook 1 of 21 mW, worst normal 24 of 88 mW, 1.5 A budget 24 of 88 mW. The rest is switching and gate drive, taken from the curve.

A linear regulator in U4's place would burn (5 V - 3.32 V) x 0.352 A = 0.59 W at the TX burst (ADR 0004's 0.6 W), a 137 C rise in a SOT-23: the buck stays.

## Junction temperatures

Board at 85 C, junction-to-ambient from the datasheets (JEDEC, so high: the board's planes do better), each part at its worst row above. Limit 125 C for U4, U5, U6, U7 and U12; D1 is held to the same figure for simplicity (a TVS is rated higher).

| Part | Worst power | Theta JA | Rise | Tj | Margin to 125 C |
|---|---|---|---|---|---|
| D1 SMF5V0A TVS | 2.0 mW | 200 C/W | 0.4 C | 85 C | 40 C |
| U12 TPS259531 eFuse | 52.3 mW | 66 C/W | 3.4 C | 88 C | 37 C |
| U4 TLV62569 buck (with L1) | 87.9 mW | 188 C/W | 16.5 C | 102 C | 23 C |
| U5 TLV75533P LDO | 1.6 mW | 231 C/W | 0.4 C | 85 C | 40 C |
| U6 TPS2553, servo | 49.3 mW | 183 C/W | 9.0 C | 94 C | 31 C |
| U7 TPS2553, fan | 5.6 mW | 183 C/W | 1.0 C | 86 C | 39 C |

U4 is the hot part, with 23 C of margin on a theta that is the datasheet's worst; everything else stays within 10 C of the board. The whole board puts out under 0.2 W, which warms a 46 x 54 mm board by a few kelvin at most `[est]`: the case's thermal problem is the duct and the servo (ADR 0004), not self-heating.

## Fault cases

| Case | Current | Drop across the part | Power | Steady-state Tj (never reached) | Ends by |
|---|---|---|---|---|---|
| U6, servo stalled at 1.2 A (hard) | 0.60 A | 2.5 V | 1.5 W | 359 C | U6's thermal shutdown (135 C in current limit, `[spec]`) cycles it; FAULT asserts after 5-10 ms and the firmware latches `load` after three one-second samples |
| U6, servo stalled at 0.96 A (light) | 0.60 A | 1.9 V | 1.1 W | 290 C | as above |
| U6, VSERVO shorted to ground | 0.60 A | 5.0 V | 3.0 W | 633 C | as above |
| U7, VFAN shorted to ground | 0.52 A | 5.0 V | 2.6 W | 559 C | same, U7 |
| U12, VBUS_F shorted to ground | 2.04 A | 5.0 V | 10.2 W | 754 C | 157 C shutdown in a few ms at 85 C (Figure 26 `[fig]`), then auto-retry every 93 ms (the auto-retry variant `[spec]`); the source's own limit also applies |

In current limit a TPS2553 is a constant-current source (no foldback), so a stalled servo (4-5 ohm across a 0.6 A limit) leaves 1.1-1.5 W in a SOT-23 whose theta would take it to 300 C: the thermal shutdown ends it, by design (ADR 0004). What the datasheet does not give is how many seconds that takes to reach 135 C on this board, nor how warm the board gets in the three seconds before the firmware latches the fault; that goes into the bring-up list (`.3.9`).

## Switch-on and surge

- **U12 soft start:** it carries C dV/dt = 505 mA into 120 uF of VBUS_F at 4.2 V/ms for 1.2 ms while its drop falls from 5 V to nothing: 1.5 mJ, 1.3 W average for that millisecond, then 0.05 W. The datasheet's thermal-shutdown time at 85 C is over a second at 1.3 W (Figure 26 `[fig]`), against a pulse of 1.2 ms.
- **D1 in a hot plug** (the 18 corners of `power.md`, 0.25-2 uH and 0.05-0.2 ohm of cable, nominal and derated caps): at most 0.8 A and 3 uJ against the SMF5.0A's 200 W / 21.7 A pulse rating `[est]`, so D1 sees nothing like its rating at plug-in.

## Other limits met

- **L1:** peak current at the TX burst is 0.35 A + half the ripple, 0.17 A at nominal L, so 0.52 A against Isat 1.8 A `[est]`. U4's high-side limit (3 A) is above that Isat, so a hard short on 3V3 drives L1 into saturation until the limit or U12 (2.04 A in) steps in; nothing the board does in normal running comes near it.
- **Power banks:** the cook case draws 90 mA at VBUS_RAW, 0.45 W. ADR 0004 put it at about 120 mA and worried about banks that cut off under 50-100 mA; that is at the top of the band where banks may cut off, so the question stands. The keep-alive footprint ADR 0004 allows for stays open for bring-up (`.3.9`), when a real bank can be tried.
