NathanHowell/minimeater/docs/sim/power.md

# 5 V input in ngspice

Generated by `just model::sim` (`src/minimeater/sim/power.py`). USB source 5.25 V behind the cable's L and R, D1 SMF5V0A (6.8 V breakdown, 0.11 ohm) and C41 100 nF on VBUS_RAW, then U12 TPS259531 eFuse (behavioural: 34 mohm, 2.04 A limit from R35 1k, 4.2 V/ms soft start from C42 10 nF, 5.7 V output clamp, 0.4 ms turn-on delay [est]) into VBUS_F: C1 100 uF, C2 and C4 10 uF, 3 x 100 nF with 3 mohm ESR. `derated` is the MLCC DC-bias loss at 5 V [est]: 45 / 55 / 55 / 90 %. Absolute maximum at VBUS_F: 6 V on the TLV62569 (SLVSDG1C) and the TLV75533P (VIN), 7 V on the TPS2553 (IN, OUT); 20 V at the eFuse's input (SLVSE57C). The first board's PTC (F1) is the `ptc` column, for comparison.

## Hot plug

| Caps | Cable L | Cable R | Peak at VBUS_F | (PTC) | Peak at the eFuse input | Source current peak | (PTC) | Charge in the first 100 us | (PTC) |
|---|---|---|---|---|---|---|---|---|---|
| nominal | 0.25 uH | 0.05 ohm | 5.25 V | 5.25 V | 5.33 V | 1.0 A | 39 A | 0.5 uC | 631 uC |
| nominal | 0.25 uH | 0.1 ohm | 5.25 V | 5.25 V | 5.40 V | 1.0 A | 29 A | 0.5 uC | 629 uC |
| nominal | 0.25 uH | 0.2 ohm | 5.25 V | 5.25 V | 5.50 V | 1.0 A | 19 A | 0.5 uC | 609 uC |
| nominal | 1 uH | 0.05 ohm | 5.27 V | 5.88 V | 7.06 V | 1.0 A | 30 A | 0.7 uC | 627 uC |
| nominal | 1 uH | 0.1 ohm | 5.25 V | 5.30 V | 7.06 V | 1.0 A | 24 A | 0.7 uC | 631 uC |
| nominal | 1 uH | 0.2 ohm | 5.25 V | 5.25 V | 7.05 V | 1.0 A | 17 A | 0.7 uC | 615 uC |
| nominal | 2 uH | 0.05 ohm | 5.28 V | 6.61 V | 7.06 V | 0.9 A | 25 A | 0.9 uC | 593 uC |
| nominal | 2 uH | 0.1 ohm | 5.27 V | 5.78 V | 7.06 V | 0.9 A | 20 A | 0.9 uC | 633 uC |
| nominal | 2 uH | 0.2 ohm | 5.25 V | 5.25 V | 7.05 V | 0.9 A | 15 A | 0.9 uC | 625 uC |
| derated | 0.25 uH | 0.05 ohm | 5.25 V | 5.38 V | 5.52 V | 0.9 A | 34 A | 0.5 uC | 294 uC |
| derated | 0.25 uH | 0.1 ohm | 5.25 V | 5.25 V | 5.53 V | 0.9 A | 26 A | 0.5 uC | 294 uC |
| derated | 0.25 uH | 0.2 ohm | 5.25 V | 5.25 V | 5.56 V | 0.9 A | 18 A | 0.5 uC | 294 uC |
| derated | 1 uH | 0.05 ohm | 5.27 V | 6.68 V | 7.04 V | 0.9 A | 24 A | 0.6 uC | 293 uC |
| derated | 1 uH | 0.1 ohm | 5.26 V | 5.85 V | 7.04 V | 0.9 A | 20 A | 0.6 uC | 295 uC |
| derated | 1 uH | 0.2 ohm | 5.25 V | 5.25 V | 7.03 V | 0.9 A | 15 A | 0.6 uC | 294 uC |
| derated | 2 uH | 0.05 ohm | 5.28 V | 7.18 V | 7.05 V | 0.9 A | 19 A | 0.8 uC | 331 uC |
| derated | 2 uH | 0.1 ohm | 5.27 V | 6.57 V | 7.05 V | 0.9 A | 17 A | 0.8 uC | 297 uC |
| derated | 2 uH | 0.2 ohm | 5.26 V | 5.56 V | 7.05 V | 0.8 A | 13 A | 0.8 uC | 294 uC |

With the PTC, the board's 100 uF sat straight on the cable: a long, thick cable rang VBUS_F to 6.6-7.2 V, over the 6 V parts, and every plug-in drew 15-40 A and 0.3-0.6 mC in tens of microseconds, against USB's 50 uC inrush guideline (minimeat-kqt, minimeat-brt). The eFuse fixes both. At attach the cable sees only the 100 nF input caps (a couple of uC); it rings the input to about 7 V, where D1 clamps it, far under the eFuse's 20 V. VBUS_F then rises at the soft-start rate, about half an amp into the board's capacitance for a millisecond, and never above 5.3 V. More input capacitance (1-2 uF) only puts more energy into the TVS, so the input keeps just the datasheet's 0.1 uF (C41, at the IN pins).

UVLO: R33 100k over R34 43.2k puts EN at 3.98 V rising, 3.65 V falling (1.2/1.1 V thresholds), and keeps the EN pin under its 7 V rating while the input rings. FLT is not used: when the eFuse trips, the board is off.

## Load-switch turn-on (worst case: no slew limit)

Switch into the output capacitance at its current limit; 5 V rail behind 0.5 ohm with 130 uF and 0.3 A of other load.

| Output | C out | Limit | Rail minimum | Time in limit | Source peak |
|---|---|---|---|---|---|
| servo (U6, R5 43.2k) | 110 uF | 0.60 A | 4.55 V | 0.82 ms | 0.90 A |
| servo, derated | 52 uF | 0.60 A | 4.55 V | 0.39 ms | 0.90 A |
| fan (U7, R6 49.9k) | 10 uF | 0.52 A | 4.66 V | 0.09 ms | 0.69 A |

The rail stays above 4.5 V. The source current is 0.9 A for about a millisecond, over a Default-class (500 mA) port's limit: firmware should enable the servo only on a 1.5 A or 3 A source, or while the fan and radio are quiet (ICD: loads are limited by source class).

## 3V3 buck (TLV62569, checked against the datasheet, not simulated)

- L1 2.2 uH with 3 x 10 uF at the output is the datasheet's standard LC (Table 4, 10 uF at 2.2 uH, also proven at 22 and 2 x 22 uF); with the DC-bias loss at 3.3 V (about 55 %) and the -50 % tolerance the effective output capacitance is still above the 10 uF row.
- R3 453k / R4 100k with C7 6.8 pF: 3.32 V, and the 6.8 pF feed-forward is the datasheet's value for R2 = 100k (R2 maximum 200k).
- Switching 1.5 MHz, high-side current limit 3 A, soft start 800 us, UVLO 2.3-2.45 V falling: the servo turn-on above leaves the rail at 4.5 V, far from UVLO.
- There is no vendor model of the buck for ngspice: `rails.md` runs the 5 V and 3V3 transients with a behavioural one (constant-power input, the datasheet's own load-step capture at the output); measure the 3V3 ripple and a Wi-Fi burst at bring-up.
