NathanHowell/minimeater/docs/sim/probe-budget.md

# Probe channel error budget

Generated by `just model::sim` (`src/minimeater/sim/budget.py`). One channel as on the schematic (47k bias at the tip, 1k to the ADC pin, 100 nF), every board-side error source at its datasheet limit, the board at 85 C. The DC solution is closed form, checked against ngspice to 1e-8 in the ratio. The probe's own tolerance, lead resistance and a damp probe's leakage are not the board's and are left out (ADR 0002, `docs/modeling/probes.md`).

## Sources and limits

| Source | Limit | From |
|---|---|---|
| Bias R23 tolerance | +-0.10% | TNPW0603 0.1 % |
| Bias R23 drift | +-0.15% | 25 ppm/K, 25 to 85 C |
| ESD leakage at the tip | 0 to 10 nA, to GND | TPD4E05U06 max over temperature (typ 10 pA, ~0.25 nA at 125 C in its Fig 5-5) |
| ADC absolute input current | +-5.6 nA | ADS122C04, PGA bypassed: +-5 nA typ, 10 pA/C (no max is published) |
| R19 tolerance | +-1% | only with the input current |
| ADC gain error | +-0.062% | 0.05 % max (gain 1-32) + 2 ppm/C max |
| ADC offset, after subtraction | +-10 uV | the firmware subtracts the shorted-input reading every pass [est] |
| ADC INL | +-99 uV | 15 ppm of the +-VREF range, max |
| Noise | +-5.8 uV | 3 sigma, interquartile mean of 8 conversions |
| Self-heating | reads high | the probe's dissipation over 1.5 mW/K (still air; far less in meat) |

REFP is the same node as the bias resistors' top, so the rail's value, FB2/R18 and the reference input current (+-10 nA) cancel.

## Error against temperature (F)

`worst` is every corner of the ranges above plus self-heating; `MC 99.7 %` is the 99.7th percentile of 4000 Monte Carlo draws (resistors, gain, offset and input current normal with the limit at 3 sigma; ESD leakage and INL uniform).

| Probe | | 32 F | 130 F | 150 F | 165 F | 205 F | 225 F | 250 F | 300 F | 400 F | 500 F | 600 F |
|---|---|---|---|---|---|---|---|---|---|---|---|---|
| ThermoWorks Pro-Series | worst | 0.36 | 0.26 | 0.25 | 0.25 | 0.25 | 0.26 | 0.28 | 0.34 | 0.65 | 1.46 | 3.34 |
| | MC 99.7 % | 0.22 | 0.16 | 0.15 | 0.15 | 0.14 | 0.14 | 0.15 | 0.18 | 0.38 | 0.99 | 2.51 |
| Maverick ET-732 | worst | 2.25 | 0.39 | 0.34 | 0.32 | 0.30 | 0.30 | 0.30 | 0.29 | 0.36 | 0.54 | 0.96 |
| | MC 99.7 % | 1.62 | 0.24 | 0.21 | 0.20 | 0.19 | 0.18 | 0.18 | 0.17 | 0.19 | 0.29 | 0.59 |
| Generic 100k B3950 | worst | 0.36 | 0.26 | 0.26 | 0.26 | 0.27 | 0.28 | 0.30 | 0.36 | 0.62 | 1.21 | 2.44 |
| | MC 99.7 % | 0.22 | 0.16 | 0.16 | 0.15 | 0.15 | 0.15 | 0.16 | 0.19 | 0.35 | 0.79 | 1.72 |

## Acceptance

- Pit, 150-300 F, every family: worst 0.36 F (limit 1 F).
- Food, 130-205 F, every family: worst 0.39 F (limit 0.5 F).

## Each source alone (F, at its worse end)

| Probe | T | bias_tol | bias_tc | esd_leak | adc_in | series_tol | gain | offset | inl | noise | self_heating |
|---|---|---|---|---|---|---|---|---|---|---|---|
| ThermoWorks Pro-Series | 32 F | 0.035 | 0.053 | 0.039 | 0.022 | 0.000 | 0.169 | 0.001 | 0.009 | 0.001 | 0.031 |
| ThermoWorks Pro-Series | 165 F | 0.052 | 0.079 | 0.010 | 0.006 | 0.000 | 0.042 | 0.001 | 0.009 | 0.001 | 0.050 |
| ThermoWorks Pro-Series | 225 F | 0.062 | 0.092 | 0.010 | 0.007 | 0.000 | 0.042 | 0.002 | 0.021 | 0.001 | 0.024 |
| ThermoWorks Pro-Series | 500 F | 0.114 | 0.172 | 0.016 | 0.059 | 0.000 | 0.071 | 0.088 | 0.877 | 0.052 | 0.001 |
| Maverick ET-732 | 32 F | 0.032 | 0.048 | 0.361 | 0.208 | 0.000 | 1.614 | 0.008 | 0.077 | 0.005 | 0.003 |
| Maverick ET-732 | 165 F | 0.047 | 0.071 | 0.024 | 0.014 | 0.000 | 0.105 | 0.001 | 0.007 | 0.000 | 0.056 |
| Maverick ET-732 | 225 F | 0.056 | 0.083 | 0.014 | 0.008 | 0.000 | 0.062 | 0.001 | 0.007 | 0.000 | 0.069 |
| Maverick ET-732 | 500 F | 0.103 | 0.154 | 0.015 | 0.017 | 0.000 | 0.065 | 0.016 | 0.155 | 0.009 | 0.006 |
| Generic 100k B3950 | 32 F | 0.034 | 0.051 | 0.039 | 0.023 | 0.000 | 0.172 | 0.001 | 0.009 | 0.001 | 0.030 |
| Generic 100k B3950 | 165 F | 0.055 | 0.082 | 0.010 | 0.006 | 0.000 | 0.045 | 0.001 | 0.009 | 0.001 | 0.052 |
| Generic 100k B3950 | 225 F | 0.066 | 0.099 | 0.011 | 0.007 | 0.000 | 0.046 | 0.002 | 0.020 | 0.001 | 0.027 |
| Generic 100k B3950 | 500 F | 0.130 | 0.194 | 0.019 | 0.046 | 0.000 | 0.081 | 0.064 | 0.637 | 0.038 | 0.002 |

## Sampling kickback (transient)

The ADC's input as a switched capacitor at the 256 kHz modulator rate, emptied to AVSS every cycle (the worst case), on the generic 100k probe at 225 F; the reading is the mean of v(ain) over a 50 ms conversion. The datasheet gives no sampling capacitance; the first row is the capacitance whose average current is the spec's 5 nA at full scale, the second ten times that.

| C sample | Average current | Per-cycle dip | Reading error | DC current of the same average |
|---|---|---|---|---|
| 5.9 fF | 0.54 nA | 21.1 nV | +0.0007 F | +0.0007 F |
| 59.2 fF | 5.41 nA | 211.4 nV | +0.0067 F | +0.0068 F |

The 100 nF node takes each kick without a visible step (the per-cycle charge is fC against 100 nF), and the reading moves exactly as a DC current of the same average would: the kickback is the datasheet's input current, already in the budget. Each jack has its own 100 nF, so the mux switching between jacks needs no settling either; plug-in settling is in `probe-frontend.md`.

## Reading it

- In the pit and food ranges the bias resistor dominates (tolerance and drift), then the ADC's gain error. None of it is worth a part change: a 0.05 % or 10 ppm/K resistor would take a tenth of a degree off a budget that already passes with margin.
- Above 400 F the 100k probes are a few hundred ohms and the ratio is small, so the ADC's INL takes over: up to about 3 F at 600 F worst case. That is outside the control range (ADR 0002).
- The 1M Maverick at 32 F is 2 F worst case, mostly gain error at a ratio near 1; it is a food-probe ice-bath check, where the power-up ambient self-check and the per-probe offset trim (ADR 0002) apply.
- The input-current terms (ESD and ADC) together are under 0.05 F in the bands; ADR 0002's 30 nA budget was conservative. The TPD4E05U06's 10 nA is its max over temperature, so the 'verify at 60 C' item is closed.
