NathanHowell/minimeater/docs/sim/probe-frontend.md

# Probe front-end in ngspice

Generated by `just model::sim` (`src/minimeater/sim/frontend.py`). One channel as on the schematic: jack tip, R19 1k, the ADC node (C29 100 nF, 30 nA leakage), 47k bias to VREF_PROBE (3V3A through FB2, R18, C27, C28). The firmware converts the ratio assuming a bare 47k bias, as in `minimeater.model.probes`.

## Reading error, settled (degF, reading minus truth, 30 nA input current)

`as_drawn` is the schematic before the fix (bias on the ADC side of the 1k, so the 1k adds to the probe); `bias_at_tip` is ADR 0002's order and the schematic now.

| Probe | Topology | 32 F | 150 F | 225 F | 325 F | 500 F |
|---|---|---|---|---|---|---|
| ThermoWorks Pro-Series | as_drawn | +0.01 | -2.52 | -11.11 | -45.71 | -175.40 |
| ThermoWorks Pro-Series | bias_at_tip | +0.12 | +0.03 | +0.04 | +0.06 | +0.31 |
| Maverick ET-732 | as_drawn | +1.06 | -0.18 | -1.42 | -8.66 | -67.72 |
| Maverick ET-732 | bias_at_tip | +1.10 | +0.09 | +0.04 | +0.04 | +0.09 |
| Generic 100k B3950 | as_drawn | +0.02 | -2.45 | -10.45 | -41.45 | -160.63 |
| Generic 100k B3950 | bias_at_tip | +0.12 | +0.03 | +0.04 | +0.06 | +0.25 |

## Settling after a probe is plugged in (bias_at_tip)

Time for the reading to stay within 0.01 F of its final value, node starting at VREF (empty jack). The RC is the 47k bias against 100 nF.

| Probe | 32 F | 225 F | 500 F |
|---|---|---|---|
| ThermoWorks Pro-Series | 34 ms | 6 ms | 2 ms |
| Maverick ET-732 | 37 ms | 20 ms | 3 ms |
| Generic 100k B3950 | 34 ms | 7 ms | 2 ms |

One 20 SPS conversion is 50 ms, so the first reading after a plug-in can still be settling. Firmware should drop the first conversion after a probe appears (to check against `drivers::ads122c04`).

## Ripple on 3V3A

Gain from 3V3A to REFP (the filtered VREF_PROBE) and to the ADC pin, 100 k probe (about 25 C), FB2 modelled as 0.2 ohm + 0.8 uH || 700 ohm [est].

| Frequency | to REFP | to ADC pin |
|---|---|---|
| 60 Hz | -0.0 dB | -10.6 dB |
| 1,000 Hz | -1.5 dB | -31.2 dB |
| 10,000 Hz | -16.3 dB | -66.0 dB |
| 100,000 Hz | -36.2 dB | -105.9 dB |
| 256,000 Hz | -44.4 dB | -122.3 dB |
| 1,500,000 Hz | -61.7 dB | -154.8 dB |

A 20 mVpp 1.5 MHz buck ripple (assumed) is 17 uV at REFP. The ADS122C04's average input current of 5 nA (datasheet) at its 256 kHz modulator rate is a charge of 20 fC per cycle, 0.2 uV on the 100 nF node.
