NathanHowell/minimeater/docs/adr/0001-mcu.md

# ADR 0001: MCU selection

- Status: accepted (2026-10-11)
- Bead: `minimeat-seq.1.3`
- Constraint: the PCB is assembled by JLCPCB, so every part must be in JLC stock. Volume is about 5 boards.

## Context

The controller needs:
- WiFi for MQTT + Home Assistant discovery and OTLP metrics.
- A single USB-C port that does power, flashing, logs and debug, with no separate programming connector.
- Rust embassy firmware.
- About 20 GPIOs: the probe ADC on SPI, the ambient sensor on I2C, fan PWM and tach, servo PWM and enable, USB-C CC sensing, an LED and a button.
- Matter as a stretch goal.

The control law is a small MPC: about 6 decision variables every 10 s. That is negligible compute for any candidate.

## Decision

**Espressif ESP32-C6-WROOM-1-N8** (JLC C5366877, about 2.5k in stock, $4.22). Specs: 8 MB flash, PCB antenna, RISC-V at 160 MHz, 512 KB SRAM, WiFi 6 (2.4 GHz), BLE 5 and 802.15.4.

| | ESP32-C6-WROOM-1-N8 | ESP32-S3-WROOM-1 | ESP32-C3 | STM32 + WiFi module |
|---|---|---|---|---|
| Native USB Serial/JTAG (flash + log + debug over the one USB-C) | yes | yes (plus USB-OTG) | yes | needs DFU/SWD, or the radio module has a separate path |
| Rust toolchain | stable `riscv32imac`, first-class esp-hal/embassy | Xtensa: needs the `espup` fork toolchain | stable RISC-V | excellent embassy support, but the WiFi stack is the problem |
| Thread / 802.15.4 (Matter-over-Thread option) | yes | no | no | no |
| RAM / flash headroom | 512 KB / 8 MB | 512 KB + PSRAM / up to 16 MB | 400 KB / 4 MB | varies |
| JLC stock | 2.5k (N8) | 34k | not checked | not checked |

- **Native USB:** the USB-Serial-JTAG block on GPIO12/13 lets `espflash` and `probe-rs` flash and auto-reset into download mode over the box's only port. This was the hard requirement.
- **Toolchain:** the C6 is RISC-V, so the project builds on stable Rust with no Xtensa fork. That simplifies CI and the host/target split in the simulation environment (`.4.16`).
- **Matter:** 802.15.4 keeps Matter-over-Thread available. Matter over WiFi works on either part.
- **Why N8 and not N4:** OTA needs two app slots. rs-matter adds hundreds of KB, so 8 MB is what leaves room for two Matter-capable images. The N4 also has less stock at JLC (370).
- **The ESP32-S3 was rejected.** It wins only on PSRAM, GPIO count and ADC channels, none of which we need now that the probes use an external ADC (ADR 0002). Its cost is the Xtensa toolchain.
- **Antenna:** use the PCB-antenna variant, placed at a board edge with the keep-out clear of copper. The box is plastic, but the egg's steel bands and the stainless intake tube are close. Place the antenna away from the tube, on the side facing away from the egg. The WROOM-1U external-antenna variant is not stocked at JLC, so there is no fallback there.

## Pin budget (WROOM-1 exposes about 21 usable GPIO)

Amended 2026-10-11: the probe ADC moved to I2C (ADR 0002, amended), so the SPI bus, its chip selects and the thermocouple chip are gone. Amended 2026-10-18 (minimeat-098): the ADC's DRDY pin is not wired (the driver polls the DRDY bit over I2C) and its GPIO, with three spares, goes to the four jacks' rings. Why each pin exists:

| Function | Pins | Why it is needed |
|---|---|---|
| USB D-/D+ | GPIO12, GPIO13 | fixed. Flashing, logs and debug over the one USB-C port, with no separate programming connector |
| I2C SDA/SCL | 2 | one bus for the ADS122C04 probe ADC and the TMP117 ambient sensor |
| Probe rings 1-4 | GPIO7, 6, 5, 4 | each jack's ring is one open-drain line for a smart probe (ADR 0002, amendment 2026-10-18): 4.7k pull-up to 3V3, 1k series, ESD on the tips' TPD4E05U06 arrays (two jacks per array). A plain probe's plug grounds the ring: at boot that is harmless (GPIO4/5 only choose SDIO clock edges, GPIO6/7 are not straps). The firmware does not drive them yet (`minimeat-0k5`). They replaced the ADC's DRDY (polled over I2C instead: the ADC's conversion ends about every 50 ms, read every 5 ms) |
| Fan PWM (LEDC 25 kHz) | 1 | fan speed, the controller's output |
| Fan tach | 1 | detects a stalled or blocked fan (airflow lost with the fire still going), and measures the fan curve in the bake-off; needs pull-up and clamp because the fan runs at 5 V |
| Fan power enable | 1 | fully stops the fan: 0 % PWM does not guarantee 0 rpm, and natural draft needs a stopped fan (ADR 0004) |
| Servo PWM | 1 | flap position, the controller's other output |
| Servo power enable | 1 | cuts hold current and jitter between moves, and trips on a stalled flap (ADR 0004) |
| USB-C CC1/CC2 sense | 2 | read the source's advertised current (Default / 1.5 A / 3 A) so WiFi bursts and the servo cannot brown out a weak port. Two pins because the source's pull-up appears on whichever CC pin the cable orientation picks, and an e-marked cable puts VCONN on the other; both must be ADC1 pins (GPIO0-6) |
| Load-switch fault flags | 1 | the two switches' open-drain fault outputs wired together: a stalled servo or a shorted fan is reported instead of guessed. Not assigned yet |
| Servo current sense | 1 | amended 2026-10-15 (ADR 0004): the INA181 across the 0.1 ohm servo shunt, 2 V/A, so homing sees the stall as current and not only on the delayed fault line. An ADC1 pin: GPIO2, the one beside the servo corner on the module; ADC DRDY moved to GPIO6 to free it (it was a spare; see the probe rings above for where it went) |
| Status LED | 1 | the only local indication (not on GPIO8 or GPIO9, strapping) |
| User button | GPIO9 | doubles as BOOT; safe because it is only read after boot. Reset to defaults and WiFi provisioning |
| UART0 TX/RX | 2 | test pads only: a console for bring-up if USB is dead on the first boards. The first candidates to give up |
| **Total** | **20-21** | **GPIO8 and GPIO15 left, both straps** |

Strapping pins GPIO8, GPIO9 and GPIO15 keep their boot defaults: GPIO8 high, GPIO9 button pull-up. The schematic (`.3.3`) assigns pins.

## Consequences

- **Thermal:** the module is rated to 85C, the same limit as the probe ADC. The ICD's thermal requirement covers both.
- **Firmware target:** `riscv32imac-unknown-none-elf` with esp-hal, esp-wifi and embassy-executor. The host digital twin runs the same `minimeater-core` on std.
