NathanHowell/minimeater/hw/fab/minimeater-bom.csv

Comment | Designator | Footprint | LCSC Part #
10uF | C1 C8 C11 C15 C17 C18 C33 C39 | C_0805_2012Metric | C15850
100nF | C2 C7 C9 C10 C12 C13 C14 C16 C20 C21 C22 C24 C25 C27 C28 C30 C34 C35 C37 C38 C40 C41 C42 | C_0402_1005Metric | C1525
10nF | C3 | C_0402_1005Metric | C15195
6.8pF | C4 | C_0402_1005Metric | C318598
100uF 10V | C5 C32 | C_1210_3225Metric | C23742
1uF | C6 C19 C23 C36 | C_0402_1005Metric | C52923
1nF | C26 C29 C31 | C_0402_1005Metric | C1523
SMF5V0A | D1 | D_SMF | C151296
LTST-S220KGKT | D2 | LTST-S220KGKT | C160469
600R@100MHz 1.3A | FB1 FB2 | L_0603_1608Metric | C85833
USB4105-GF-A-120 | J1 | USB_C_Receptacle_GCT_USB4105-xx-A_16P_TopMnt_Horizontal | C5184243
PJ-242 | J2 J3 J4 J5 | PJ-242 | C431536
2.2uH | L1 | LQH3NPN2R2MMEL | C668451
5.1k 1% | R1 R2 | R_0402_1005Metric | C105872
100k 1% | R3 R6 R18 R42 | R_0402_1005Metric | C60491
43.2k 1% | R4 R38 | R_0402_1005Metric | C137980
453k 1% | R5 | R_0402_1005Metric | C27009
1k 1% | R7 R13 R14 R15 R16 R22 R29 R31 R33 R36 R41 | R_0402_1005Metric | C11702
10R 5% | R8 | R_0402_1005Metric | C25077
47k 0.1% 25ppm | R9 R10 R11 R12 | R_0603_1608Metric | C2089026
49.9k 1% | R17 | R_0402_1005Metric | C137969
10k 1% | R19 R20 R23 R27 R35 R40 | R_0402_1005Metric | C60490
100R 1% | R21 | R_0402_1005Metric | C25076
4.7k 1% | R25 R26 R30 R32 R34 R37 | R_0402_1005Metric | C25900
330R 1% | R28 | R_0402_1005Metric | C25104
0R1 1% | R39 | R_0402_1005Metric | C2088598
680R 1% | R43 | R_0402_1005Metric | C137948
SKRPACE010 | SW1 | SKRPACE010 | C139797
TPD4E05U06DQAR | U1 U2 U3 | TPD4E05U06DQA | C138714
TPS259531DSGR | U4 | Texas_DSG0008A_WSON-8-1EP_2x2mm_P0.5mm_EP0.9x1.6mm | C2155674
TLV62569DBV | U5 | SOT-23-5 | C141836
TLV75533PDBV | U6 | SOT-23-5 | C404027
TPS2553DBV | U7 U12 | SOT-23-6 | C55266
ADS122C04IPWR | U8 | TSSOP-16_4.4x5mm_P0.65mm | C2872338
ATECC608B-SSHDA-T | U9 | SOIC-8_3.9x4.9mm_P1.27mm | C1518769
ESP32-C6-WROOM-1-N8 | U10 | ESP32-C6-WROOM-1 | C5366877
INA181A1 | U11 | SOT-363_SC-70-6 | C22443503
TMP117AIDRVR | U13 | TMP117AIDRV_WSON-6_noEP | C699536
