NathanHowell/minimeater/hw/minimeater.kicad_pcb

## KiCad design hw/minimeater.kicad_pcb (2026-11-12)

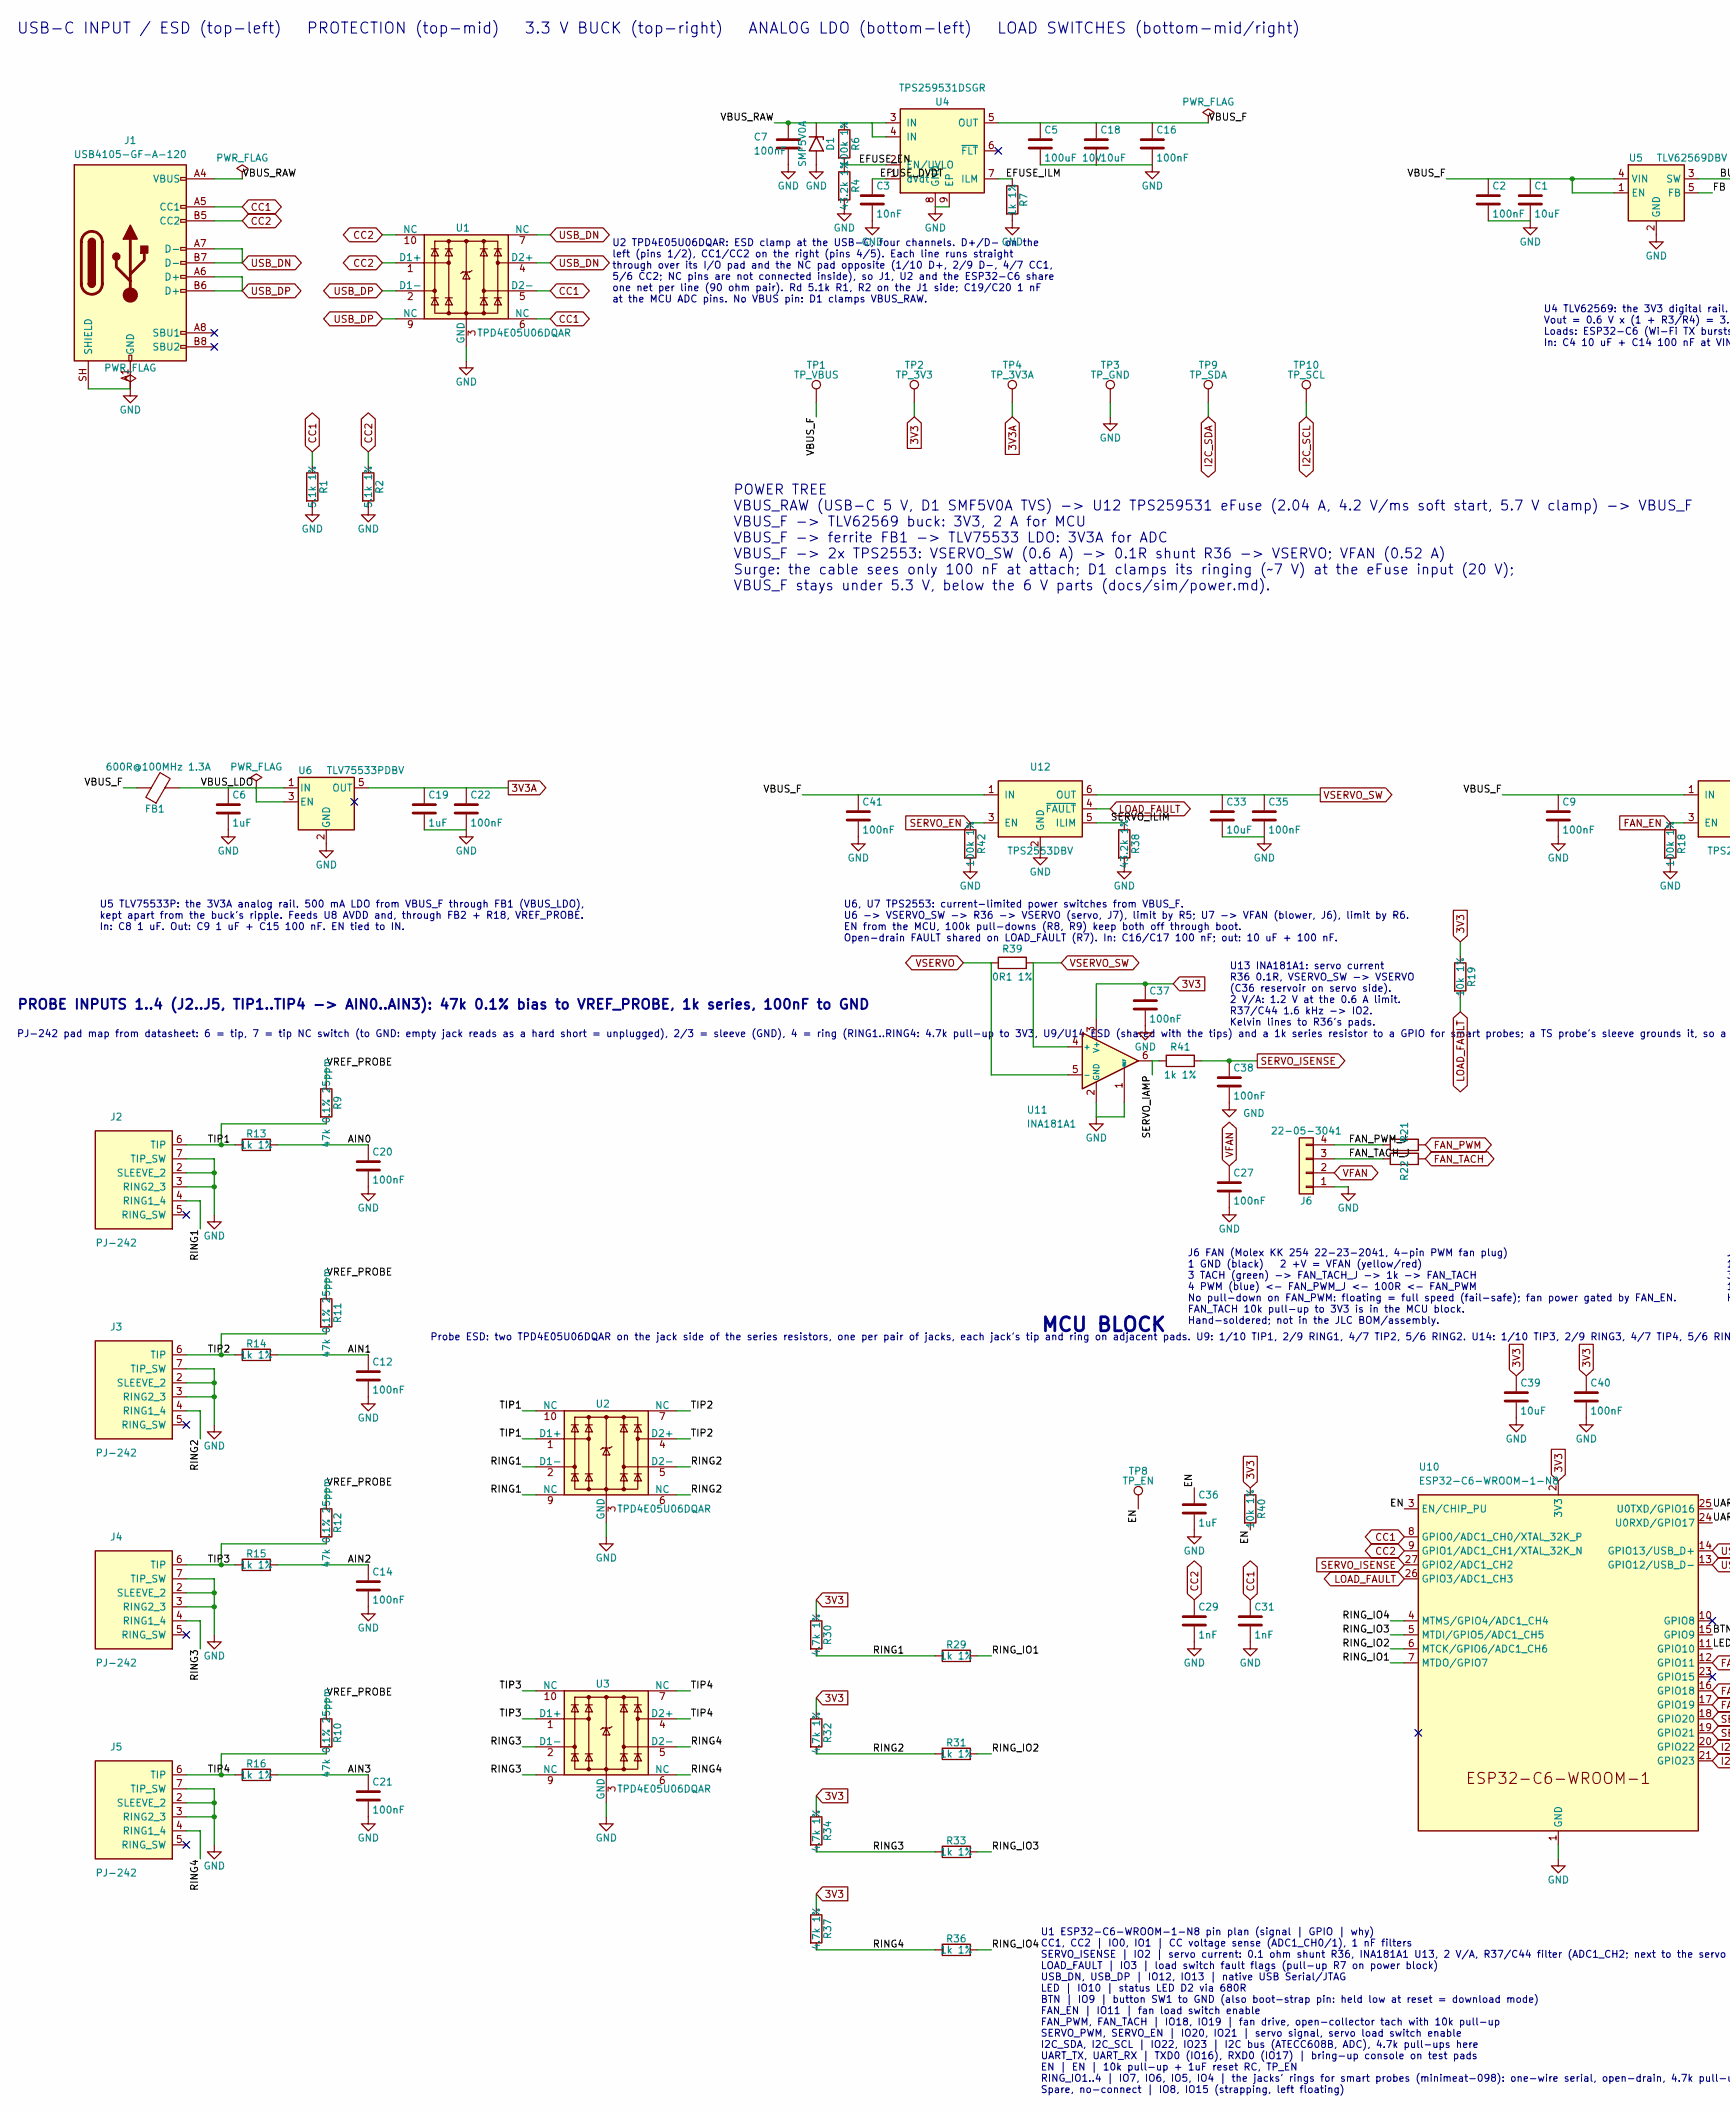
[picture p38: schematic minimeater.kicad_sch, part in row 1, column 1]

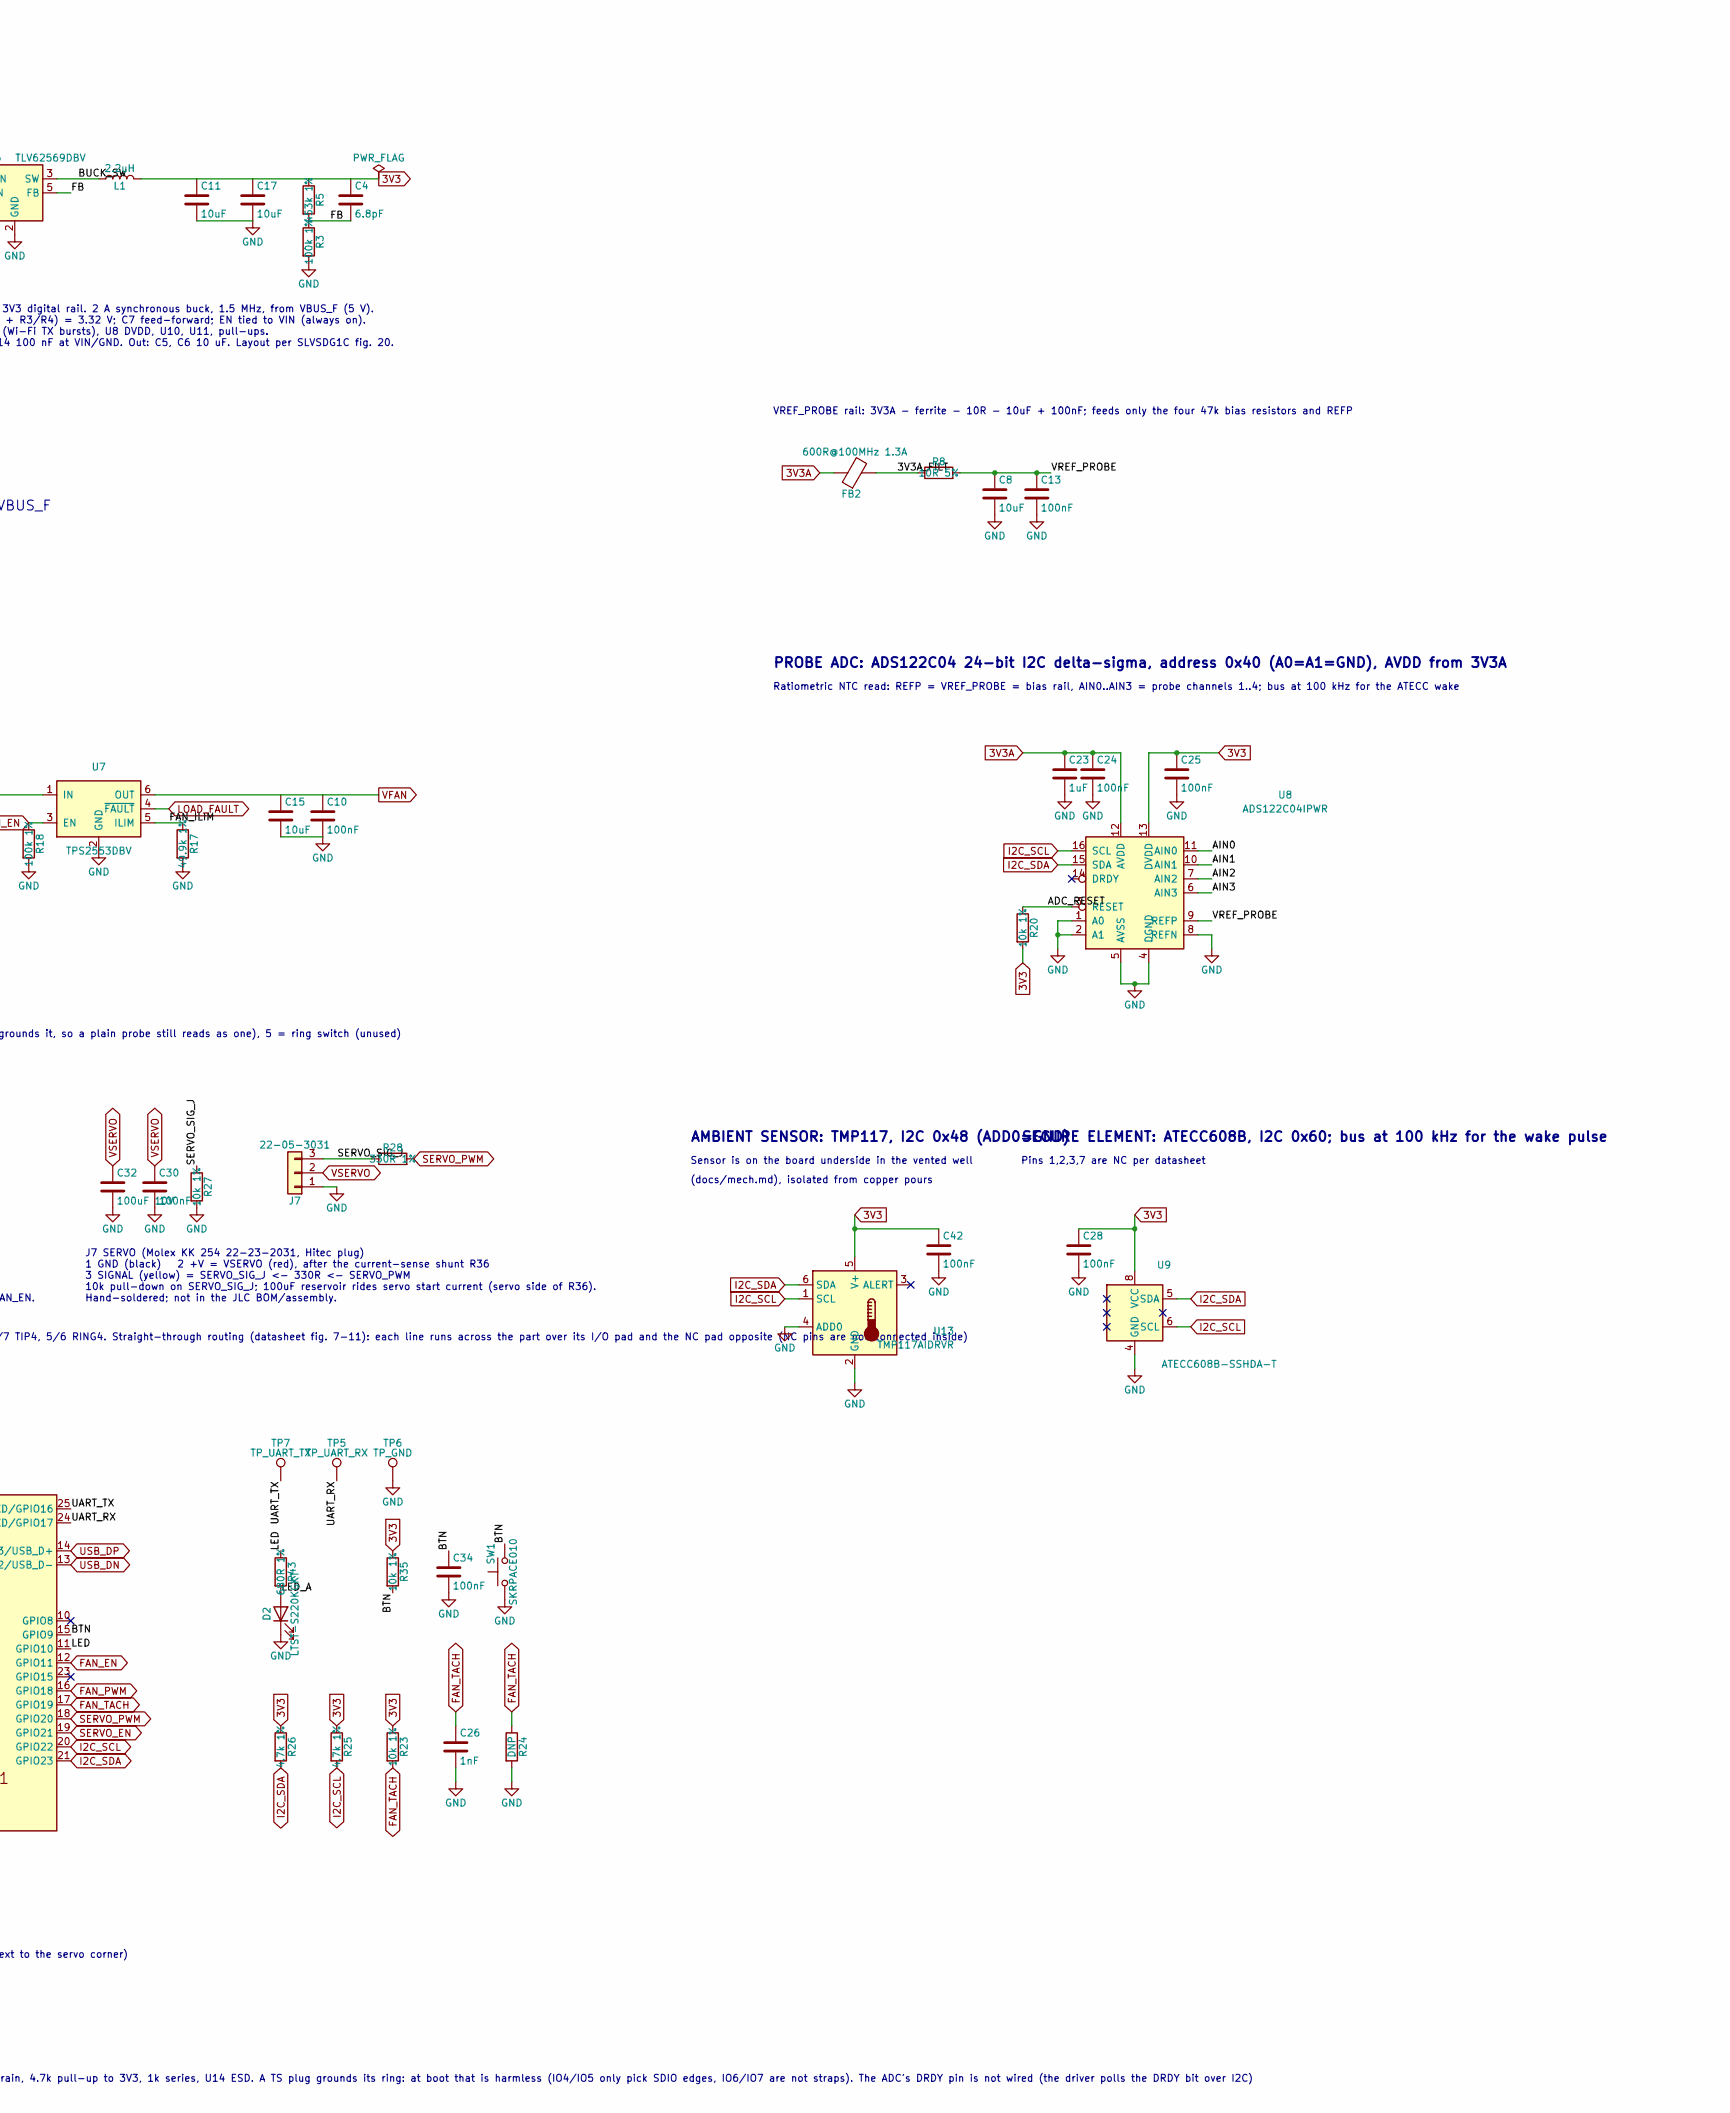
[picture p39: schematic minimeater.kicad_sch, part in row 1, column 2]

Parts:
C1, C8, C11, C15, C17, C18, C33, C39: 10uF; C_0805_2012Metric; MPN CL21A106KAYNNNE; LCSC C15850
C2, C7, C9, C10, C12, C13, C14, C16, C20, C21, C22, C24, C25, C27, C28, C30, C34, C35, C37, C38, C40, C41, C42: 100nF; C_0402_1005Metric; MPN CL05B104KO5NNNC; LCSC C1525
C3: 10nF; C_0402_1005Metric; MPN CL05B103KB5NNNC; LCSC C15195
C4: 6.8pF; C_0402_1005Metric; MPN CL05C6R8CB5NNNC; LCSC C318598
C5, C32: 100uF 10V; C_1210_3225Metric; MPN CL32A107MPVNNNE; LCSC C23742
C6, C19, C23, C36: 1uF; C_0402_1005Metric; MPN CL05A105KA5NQNC; LCSC C52923
C26, C29, C31: 1nF; C_0402_1005Metric; MPN 0402B102K500NT; LCSC C1523
D1: SMF5V0A; D_SMF; MPN SMF5.0A; LCSC C151296
D2: LTST-S220KGKT; MPN LTST-S220KGKT; LCSC C160469
FB1: 600R@100MHz 1.3A; L_0603_1608Metric; LCSC C85833
FB2: 600R@100MHz 1.3A; L_0603_1608Metric; MPN BLM18KG601SN1D; LCSC C85833
J1: USB4105-GF-A-120; USB_C_Receptacle_GCT_USB4105-xx-A_16P_TopMnt_Horizontal; MPN USB4105-GF-A-120; LCSC C5184243
J2, J3, J4, J5: PJ-242; MPN PJ-242; LCSC C431536
J6: 22-05-3041; KK254-RA-04; LCSC N/A hand-solder (Mouser/Digi-Key 22-05-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
J7: 22-05-3031; KK254-RA-03; LCSC N/A hand-solder (Mouser/Digi-Key 22-05-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
L1: 2.2uH; LQH3NPN2R2MMEL; MPN LQH3NPN2R2MMEL; LCSC C668451
R1, R2: 5.1k 1%; R_0402_1005Metric; MPN RC0402FR-075K1L; LCSC C105872
R3, R6, R18, R42: 100k 1%; R_0402_1005Metric; MPN RC0402FR-07100KL; LCSC C60491
R4, R38: 43.2k 1%; R_0402_1005Metric; MPN RC0402FR-0743K2L; LCSC C137980
R5: 453k 1%; R_0402_1005Metric; MPN 0402WGF4533TCE; LCSC C27009
R7, R13, R14, R15, R16, R22, R29, R31, R33, R36, R41: 1k 1%; R_0402_1005Metric; MPN 0402WGF1001TCE; LCSC C11702
R8: 10R 5%; R_0402_1005Metric; MPN 0402WGF100JTCE; LCSC C25077
R9, R10, R11, R12: 47k 0.1% 25ppm; R_0603_1608Metric; MPN TNPW060347K0BEEA; LCSC C2089026
R17: 49.9k 1%; R_0402_1005Metric; MPN RC0402FR-0749K9L; LCSC C137969
R19, R20, R23, R27, R35, R40: 10k 1%; R_0402_1005Metric; MPN RC0402FR-0710KL; LCSC C60490
R21: 100R 1%; R_0402_1005Metric; MPN 0402WGF1000TCE; LCSC C25076
R24: DNP; R_0402_1005Metric; LCSC DNP: rework only (FAN_TACH divider if t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
R25, R26, R30, R32, R34, R37: 4.7k 1%; R_0402_1005Metric; MPN 0402WGF4701TCE; LCSC C25900
R28: 330R 1%; R_0402_1005Metric; MPN 0402WGF3300TCE; LCSC C25104
R39: 0R1 1%; R_0402_1005Metric; MPN ERJ-2BWFR100X; LCSC C2088598
R43: 680R 1%; R_0402_1005Metric; MPN RC0402FR-07680RL; LCSC C137948
SW1: SKRPACE010; MPN SKRPACE010; LCSC C139797
TP1: TP_VBUS; TestPoint_Pad_D1.5mm; LCSC N/A (not assembled)
TP2: TP_3V3; TestPoint_Pad_D1.5mm; LCSC N/A (not assembled)
TP3, TP6: TP_GND; TestPoint_Pad_1.5x1.5mm; LCSC N/A (not assembled)
TP4: TP_3V3A; TestPoint_Pad_D1.5mm; LCSC N/A (not assembled)
TP5: TP_UART_RX; TestPoint_Pad_D1.5mm; LCSC N/A (not assembled)
TP7: TP_UART_TX; TestPoint_Pad_D1.5mm; LCSC N/A (not assembled)
TP8: TP_EN; TestPoint_Pad_D1.5mm; LCSC N/A (not assembled)
TP9: TP_SDA; TestPoint_Pad_D1.5mm; LCSC N/A (not assembled)
TP10: TP_SCL; TestPoint_Pad_D1.5mm; LCSC N/A (not assembled)
U1, U2, U3: TPD4E05U06DQAR; TPD4E05U06DQA; MPN TPD4E05U06DQAR; LCSC C138714
U4: TPS259531DSGR; Texas_DSG0008A_WSON-8-1EP_2x2mm_P0.5mm_EP0.9x1.6mm; MPN TPS259531DSGR; LCSC C2155674
U5: TLV62569DBV; SOT-23-5; MPN TLV62569DBVR; LCSC C141836
U6: TLV75533PDBV; SOT-23-5; MPN TLV75533PDBVR; LCSC C404027
U7, U12: TPS2553DBV; SOT-23-6; MPN TPS2553DBVR; LCSC C55266
U8: ADS122C04IPWR; TSSOP-16_4.4x5mm_P0.65mm; MPN ADS122C04IPWR; LCSC C2872338
U9: ATECC608B-SSHDA-T; SOIC-8_3.9x4.9mm_P1.27mm; MPN ATECC608B-SSHDA-T; LCSC C1518769
U10: ESP32-C6-WROOM-1-N8; ESP32-C6-WROOM-1; MPN ESP32-C6-WROOM-1-N8; LCSC C5366877
U11: INA181A1; SOT-363_SC-70-6; MPN INA181A1IDCKR; LCSC C22443503
U13: TMP117AIDRVR; TMP117AIDRV_WSON-6_noEP; MPN TMP117AIDRVR; LCSC C699536

Connections:
3V3A: C19.1, C22.1, C23.1, C24.1, FB2.1, TP4.1 (1_1), U6.5 (OUT), U8.12 (AVDD)
/3V3A_FILT: FB2.2, R8.1
/ADC_RESET: R20.1, U8.3 (RESET)
/AIN0: C20.1, R13.2, U8.11 (AIN0)
/AIN1: C12.1, R14.2, U8.10 (AIN1)
/AIN2: C14.1, R15.2, U8.7 (AIN2)
/AIN3: C21.1, R16.2, U8.6 (AIN3)
/BTN: C34.1, R35.2, SW1.2, U10.15 (GPIO9)
/BUCK_SW: L1.1, U5.3 (SW)
/EFUSE_DVDT: C3.1, U4.1 (dVdt)
/EFUSE_EN: R4.1, R6.2, U4.2 (EN/UVLO)
/EFUSE_ILM: R7.1, U4.7 (ILM)
/EN: C36.1, R40.2, TP8.1 (1_1), U10.3 (EN/CHIP_PU)
/FAN_ILIM: R17.1, U7.5 (ILIM)
/FAN_PWM_J: J6.4, R21.1
/FAN_TACH_J: J6.3, R22.1
/FB: C4.2, R3.1, R5.2, U5.5 (FB)
/LED: R43.1, U10.11 (GPIO10)
/LED_A: D2.2 (A), R43.2
/RING1: J2.4 (RING1_4), R29.1, R30.2, U2.2 (D1-), U2.9 (NC)
/RING2: J3.4 (RING1_4), R31.1, R32.2, U2.5 (D2-), U2.6 (NC)
/RING3: J4.4 (RING1_4), R33.1, R34.2, U3.2 (D1-), U3.9 (NC)
/RING4: J5.4 (RING1_4), R36.1, R37.2, U3.5 (D2-), U3.6 (NC)
/RING_IO1: R29.2, U10.7 (MTDO/GPIO7)
/RING_IO2: R31.2, U10.6 (MTCK/GPIO6/ADC1_CH6)
/RING_IO3: R33.2, U10.5 (MTDI/GPIO5/ADC1_CH5)
/RING_IO4: R36.2, U10.4 (MTMS/GPIO4/ADC1_CH4)
/SERVO_IAMP: R41.1, U11.6
/SERVO_ILIM: R38.1, U12.5 (ILIM)
/SERVO_SIG_J: J7.3, R27.1, R28.1
/TIP1: J2.6 (TIP), R9.2, R13.1, U2.1 (D1+), U2.10 (NC)
/TIP2: J3.6 (TIP), R11.2, R14.1, U2.4 (D2+), U2.7 (NC)
/TIP3: J4.6 (TIP), R12.2, R15.1, U3.1 (D1+), U3.10 (NC)
/TIP4: J5.6 (TIP), R10.2, R16.1, U3.4 (D2+), U3.7 (NC)
/UART_RX: TP5.1 (1_1), U10.24 (U0RXD/GPIO17)
/UART_TX: TP7.1 (1_1), U10.25 (U0TXD/GPIO16)
/VREF_PROBE: C8.1, C13.1, R8.2, R9.1, R10.1, R11.1, R12.1, U8.9 (REFP)
CC1: C31.1, J1.A5 (CC1), R1.1, U1.5 (D2-), U1.6 (NC), U10.8 (GPIO0/ADC1_CH0/XTAL_32K_P)
CC2: C29.1, J1.B5 (CC2), R2.1, U1.1 (D1+), U1.10 (NC), U10.9 (GPIO1/ADC1_CH1/XTAL_32K_N)
FAN_EN: R18.1, U7.3 (EN), U10.12 (GPIO11)
FAN_PWM: R21.2, U10.16 (GPIO18)
FAN_TACH: C26.1, R22.2, R23.2, R24.1, U10.17 (GPIO19)
I2C_SCL: R25.2, TP10.1 (1_1), U8.16 (SCL), U9.6 (SCL), U10.20 (GPIO22), U13.1 (SCL)
I2C_SDA: R26.2, TP9.1 (1_1), U8.15 (SDA), U9.5 (SDA), U10.21 (GPIO23), U13.6 (SDA)
LOAD_FAULT: R19.2, U7.4 (~FAULT), U10.26 (GPIO3/ADC1_CH3), U12.4 (~FAULT)
SERVO_EN: R42.1, U10.19 (GPIO21), U12.3 (EN)
SERVO_ISENSE: C38.1, R41.2, U10.27 (GPIO2/ADC1_CH2)
SERVO_PWM: R28.2, U10.18 (GPIO20)
USB_DN: J1.A7 (D-), J1.B7 (D-), U1.4 (D2+), U1.7 (NC), U10.13 (GPIO12/USB_D-)
USB_DP: J1.A6 (D+), J1.B6 (D+), U1.2 (D1-), U1.9 (NC), U10.14 (GPIO13/USB_D+)
VFAN: C10.1, C15.1, C27.1, J6.2, U7.6 (OUT)
VSERVO: C30.1, C32.1, J7.2, R39.1, U11.5 (-)
VSERVO_SW: C33.1, C35.1, R39.2, U11.4 (+), U12.6 (OUT)

Notes on the sheet:
MCU BLOCK
Ratiometric NTC read: REFP = VREF_PROBE = bias rail, AIN0..AIN3 = probe channels 1..4; bus at 100 kHz for the ATECC wake
AMBIENT SENSOR: TMP117, I2C 0x48 (ADD0=GND)
U4 TLV62569: the 3V3 digital rail. 2 A synchronous buck, 1.5 MHz, from VBUS_F (5 V). Vout = 0.6 V x (1 + R3/R4) = 3.32 V; C7 feed-forward; EN tied to VIN (always on). Loads: ESP32-C6 (Wi-Fi TX bursts), U8 DVDD, U10, U11, pull-ups. In: C4 10 uF + C14 100 nF at VIN/GND. Out: C5, C6 10 uF. Layout per 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
Sensor is on the board underside in the vented well
PROBE INPUTS 1..4 (J2..J5, TIP1..TIP4 -> AIN0..AIN3): 47k 0.1% bias to VREF_PROBE, 1k series, 100nF to GND
Pins 1,2,3,7 are NC per datasheet
U13 INA181A1: servo current R36 0.1R, VSERVO_SW -> VSERVO (C36 reservoir on servo side). 2 V/A: 1.2 V at the 0.6 A limit. R37/C44 1.6 kHz -> IO2. Kelvin lines to R36's pads.
J6 FAN (Molex KK 254 22-23-2041, 4-pin PWM fan plug) 1 GND (black) 2 +V = VFAN (yellow/red) 3 TACH (green) -> FAN_TACH_J -> 1k -> FAN_TACH 4 PWM (blue) <- FAN_PWM_J <- 100R <- FAN_PWM No pull-down on FAN_PWM: floating = full speed (fail-safe); fan power gated by FAN_EN. FAN_TACH 10k pull-up to 3V3 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
Probe ESD: two TPD4E05U06DQAR on the jack side of the series resistors, one per pair of jacks, each jack's tip and ring on adjacent pads. U9: 1/10 TIP1, 2/9 RING1, 4/7 TIP2, 5/6 RING2. U14: 1/10 TIP3, 2/9 RING3, 4/7 TIP4, 5/6 RING4. Straight-through routing (datasheet fig. 7-11): each line runs acr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
U6, U7 TPS2553: current-limited power switches from VBUS_F. U6 -> VSERVO_SW -> R36 -> VSERVO (servo, J7), limit by R5; U7 -> VFAN (blower, J6), limit by R6. EN from the MCU, 100k pull-downs (R8, R9) keep both off through boot. Open-drain FAULT shared on LOAD_FAULT (R7). In: C16/C17 100 nF; out: 10 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
POWER TREE VBUS_RAW (USB-C 5 V, D1 SMF5V0A TVS) -> U12 TPS259531 eFuse (2.04 A, 4.2 V/ms soft start, 5.7 V clamp) -> VBUS_F VBUS_F -> TLV62569 buck: 3V3, 2 A for MCU VBUS_F -> ferrite FB1 -> TLV75533 LDO: 3V3A for ADC VBUS_F -> 2x TPS2553: VSERVO_SW (0.6 A) -> 0.1R shunt R36 -> VSERVO; VFAN (0.52 A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
USB-C INPUT / ESD (top-left) PROTECTION (top-mid) 3.3 V BUCK (top-right) ANALOG LDO (bottom-left) LOAD SWITCHES (bottom-mid/right)
(docs/mech.md), isolated from copper pours
U2 TPD4E05U06DQAR: ESD clamp at the USB-C, four channels. D+/D- on the left (pins 1/2), CC1/CC2 on the right (pins 4/5). Each line runs straight through over its I/O pad and the NC pad opposite (1/10 D+, 2/9 D-, 4/7 CC1, 5/6 CC2; NC pins are not connected inside), so J1, U2 and the ESP32-C6 share o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
PROBE ADC: ADS122C04 24-bit I2C delta-sigma, address 0x40 (A0=A1=GND), AVDD from 3V3A
SECURE ELEMENT: ATECC608B, I2C 0x60; bus at 100 kHz for the wake pulse
J7 SERVO (Molex KK 254 22-23-2031, Hitec plug) 1 GND (black) 2 +V = VSERVO (red), after the current-sense shunt R36 3 SIGNAL (yellow) = SERVO_SIG_J <- 330R <- SERVO_PWM 10k pull-down on SERVO_SIG_J; 100uF reservoir rides servo start current (servo side of R36). Hand-soldered; not in the JLC BOM/ass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
PJ-242 pad map from datasheet: 6 = tip, 7 = tip NC switch (to GND: empty jack reads as a hard short = unplugged), 2/3 = sleeve (GND), 4 = ring (RING1..RING4: 4.7k pull-up to 3V3, U9/U14 ESD (shared with the tips) and a 1k series resistor to a GPIO for smart probes; a TS probe's sleeve grounds it, s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
U5 TLV75533P: the 3V3A analog rail. 500 mA LDO from VBUS_F through FB1 (VBUS_LDO), kept apart from the buck's ripple. Feeds U8 AVDD and, through FB2 + R18, VREF_PROBE. In: C8 1 uF. Out: C9 1 uF + C15 100 nF. EN tied to IN.
U1 ESP32-C6-WROOM-1-N8 pin plan (signal | GPIO | why) CC1, CC2 | IO0, IO1 | CC voltage sense (ADC1_CH0/1), 1 nF filters SERVO_ISENSE | IO2 | servo current: 0.1 ohm shunt R36, INA181A1 U13, 2 V/A, R37/C44 filter (ADC1_CH2; next to the servo corner) LOAD_FAULT | IO3 | load switch fault flags (pull-up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
VREF_PROBE rail: 3V3A - ferrite - 10R - 10uF + 100nF; feeds only the four 47k bias resistors and REFP

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
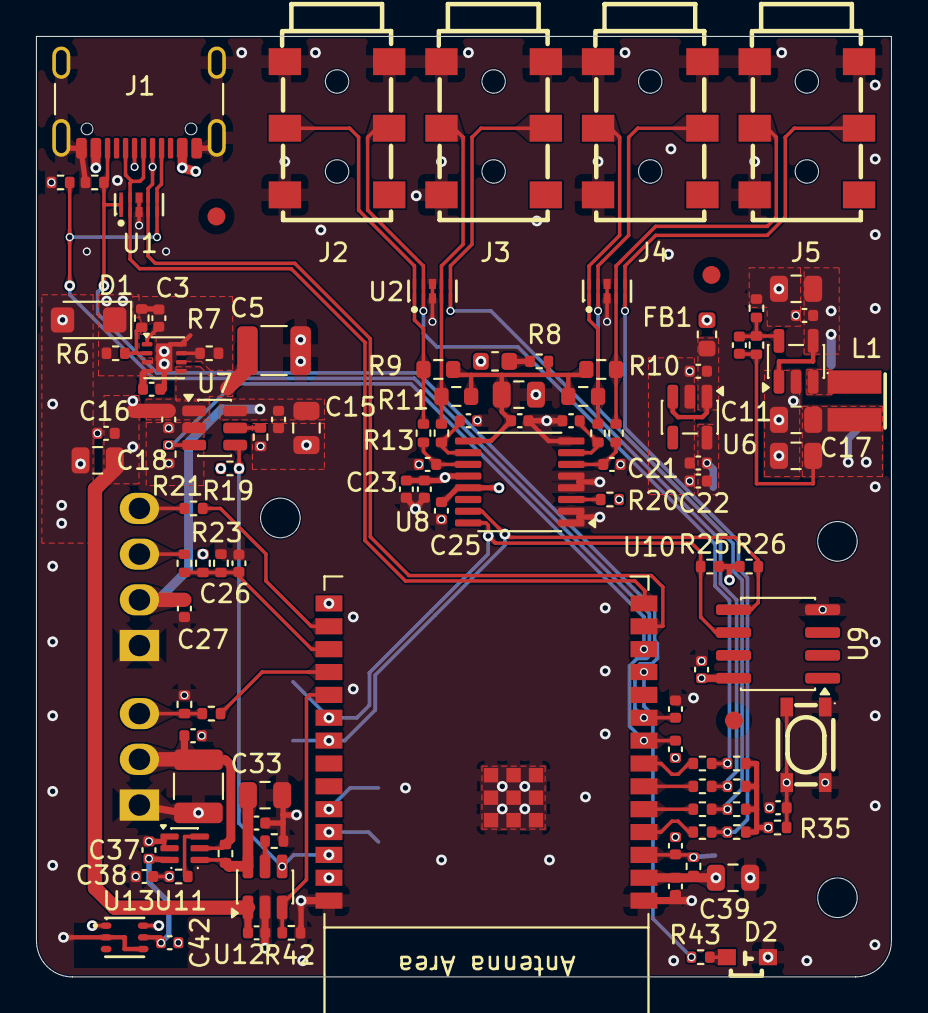
[picture p40: board minimeater.kicad_pcb from above]

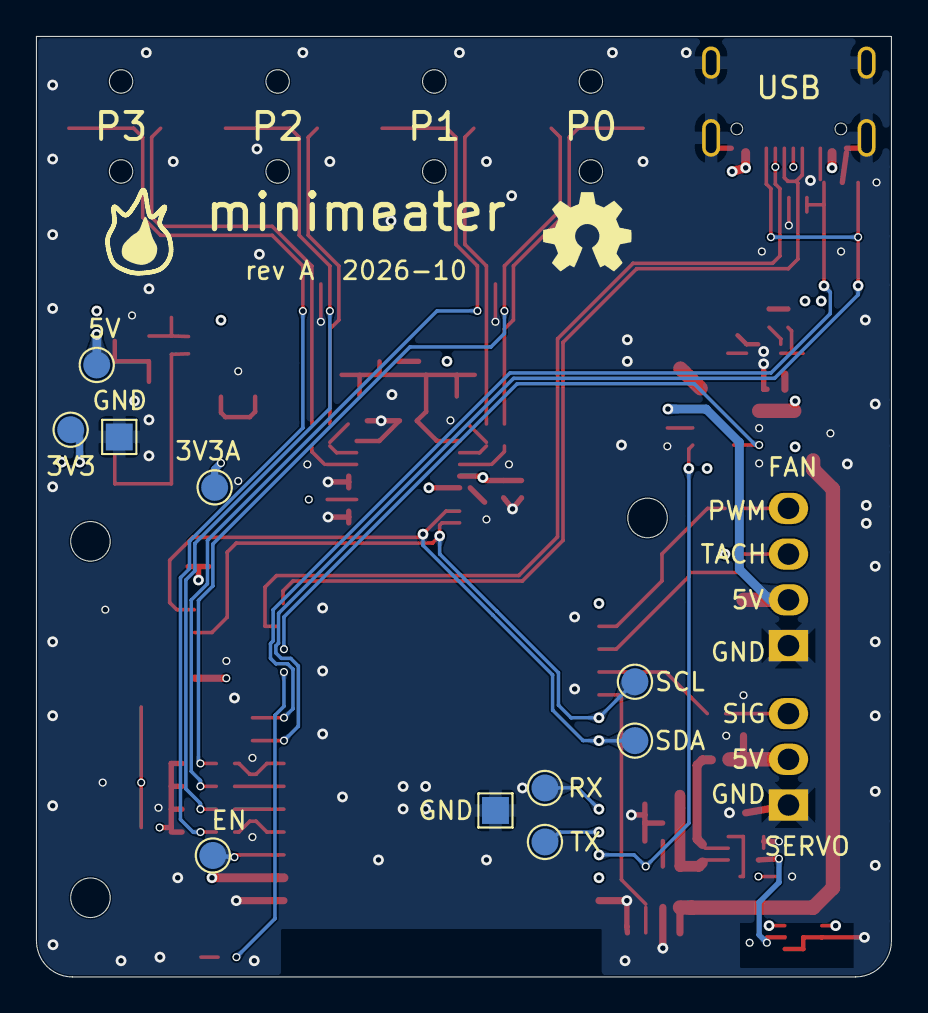
[picture p41: board minimeater.kicad_pcb from below]

Board: 4 copper layers, 47.5 x 52.2 mm, 127 parts (10 on the bottom side), 58 nets.

Other parts of the board:
FID1, FID2, FID3: Fiducial_1mm_Mask2mm
H1, H2, H3: MountingHole_2.2mm_M2
