NathanHowell/minimeater/fw/minimeater-app/src/drive.rs

//! Actuator drivers (`.4.8`): the logic between "open the flap to 40 degrees, run the fan at 30 %"
//! and the pulse width, power gate and PWM duty that do it. Pure state machines that the
//! [`crate::tasks::actuators`] task steps once a second, so they run unchanged on the host.
//!
//! - [`ServoDrive`]: angle to pulse width through the calibration (either direction), a slew limit
//!   so the damper is not slammed, and the power gate: the servo is powered only while it moves and
//!   for [`HOLD_S`] after, which stops hold current and jitter.
//! - [`Homing`]: the hard-stop homing that finds the servo calibration by itself.
//! - [`FanCurve`] and [`FanDrive`]: speed fraction to PWM duty, and an optional spin-up kick.
//! - [`TachWatch`]: a fan that is driven but does not turn is a fault (`fan_stall`).
//! - [`ServoWatch`]: the servo's current over each move, and a fault when it is wrong (`servo`).

use crate::config::ServoPulses;

/// The servo stays powered this long after its last move, s.
pub const HOLD_S: f64 = 2.0;

/// Pulse widths at the flap's closed stop and its fully open (90 degree) stop, us. `closed_us >
/// open_us` is a servo mounted the other way round.
#[derive(Clone, Copy, Debug, PartialEq)]
pub struct ServoCal {
    pub closed_us: f64,
    pub open_us: f64,
}

impl From<crate::config::ServoPulses> for ServoCal {
    fn from(p: crate::config::ServoPulses) -> Self {
        Self {
            closed_us: f64::from(p.closed_us),
            open_us: f64::from(p.open_us),
        }
    }
}

impl ServoCal {
    /// A typical hobby servo, 1 to 2 ms over 90 degrees. [est until `.2.9` picks the servo]
    pub const DEFAULT: ServoCal = ServoCal {
        closed_us: 1000.0,
        open_us: 2000.0,
    };

    /// Pulse width for a flap angle (clamped to the stops), us.
    pub fn pulse_us(&self, angle_deg: f64) -> u16 {
        let frac = (angle_deg / 90.0).clamp(0.0, 1.0);
        (self.closed_us + frac * (self.open_us - self.closed_us) + 0.5) as u16
    }
}

/// What to put on the servo pins this second.
#[derive(Clone, Copy, Debug, PartialEq)]
pub struct ServoOut {
    pub pulse_us: u16,
    pub power: bool,
}

#[derive(Clone, Debug)]
pub struct ServoDrive {
    pub cal: ServoCal,
    /// Slew limit, degrees per second.
    pub slew_dps: f64,
    /// Where the flap is believed to be; `None` until the first command (it could be anywhere
    /// after a power-up, so the first move is a jump).
    angle_deg: Option<f64>,
    still_s: f64,
}

impl ServoDrive {
    /// Full travel in 1.5 s.
    pub const SLEW_DPS: f64 = 60.0;

    pub fn new(cal: ServoCal) -> Self {
        Self {
            cal,
            slew_dps: Self::SLEW_DPS,
            angle_deg: None,
            still_s: HOLD_S,
        }
    }

    /// Forgets where the flap is: something else moved the servo, so the next command is a jump.
    pub fn forget(&mut self) {
        self.angle_deg = None;
    }

    /// Where the servo has been told to be.
    pub fn angle_deg(&self) -> Option<f64> {
        self.angle_deg
    }

    /// One step of `dt` seconds toward `target_deg`. The caller sets the pulse before it applies
    /// power, so a servo that wakes up goes straight to its new position and not first to the old one.
    pub fn tick(&mut self, target_deg: f64, dt: f64) -> ServoOut {
        let target = target_deg.clamp(0.0, 90.0);
        let next = match self.angle_deg {
            None => target,
            Some(a) => a + (target - a).clamp(-self.slew_dps * dt, self.slew_dps * dt),
        };
        if self.angle_deg != Some(next) {
            self.still_s = 0.0;
        } else {
            self.still_s += dt;
        }
        self.angle_deg = Some(next);
        ServoOut {
            pulse_us: self.cal.pulse_us(next),
            power: self.still_s < HOLD_S,
        }
    }
}

/// Why a homing run found no calibration.
#[derive(Clone, Copy, Debug, PartialEq, Eq)]
pub enum HomeFail {
    /// The sweep toward the lower pulses reached its limit without the servo stalling: no stop there.
    NoStopLow,
    /// The same toward the higher pulses.
    NoStopHigh,
    /// The fault line was already low, or the current already high, with the servo at rest: something else is wrong, and
    /// a stall could not be told.
    FaultAtRest,
    /// The two stops are not a flap's travel apart (too close, or out of range).
    Span,
    /// The supply or a load switch went away before it finished; it runs again once the supply is back.
    Cancelled,
}

impl HomeFail {
    /// Wire name (the `servo_home` event's `why`, docs/protocol.md).
    pub fn name(self) -> &'static str {
        match self {
            HomeFail::NoStopLow => "no_stop_low",
            HomeFail::NoStopHigh => "no_stop_high",
            HomeFail::FaultAtRest => "fault_at_rest",
            HomeFail::Span => "span",
            HomeFail::Cancelled => "cancelled",
        }
    }
}

/// Homing (`minimeat-xdn`): the servo is swept slowly toward each end until the crank's lug meets a printed post and
/// the servo stalls. The stall is seen two ways (`minimeat-sul`): its supply current, across the shunt, passes
/// [`Homing::STALL_MA`] before the load switch limits, and once it would pass the switch's limit the shared fault line
/// asserts. Either counts, so a broken current sense still homes on the line. The stalled pulses (less the lead the
/// servo needs to build that current, shorter for the current than for the line) are the stops, and become the
/// calibration the manual jog procedure otherwise makes (`minimeat-bkz`). The lower stop is taken to be closed, so a servo
/// mounted the other way round is calibrated by hand. Pure: [`Homing::tick`] is stepped every [`Homing::DT`] seconds by
/// the actuator task, which holds the fan off (so the fault line is the servo's) and keeps the load watch out of it.
#[derive(Clone, Copy, Debug)]
pub struct Homing {
    phase: HomePhase,
    pulse_us: f64,
    t_s: f64,
    /// One bit per recent step, set when the stall was seen in it (line low or current high), newest lowest.
    active: u8,
    /// The same, for the steps in which the current saw it.
    by_current: u8,
    lo_us: f64,
    hi_us: f64,
    /// The lead taken off each stop: [`Homing::LEAD_CURRENT_US`] when the current saw that stall, else [`Homing::LEAD_US`].
    lo_lead_us: f64,
    hi_lead_us: f64,
}

#[derive(Clone, Copy, Debug, PartialEq, Eq)]
enum HomePhase {
    Settle,
    Low,
    RestLow,
    High,
    RestHigh,
    Done,
}

impl Homing {
    /// Step of the state machine, s. The fault switch asserts after about 8 ms, so it is seen within one step.
    pub const DT: f64 = 0.1;
    /// Where it starts, us: the middle of what a hobby servo takes, which the servo reaches from anywhere.
    pub const START_US: f64 = 1500.0;
    /// The furthest it will sweep either way, us.
    pub const LIMIT_US: (f64, f64) = (700.0, 2300.0);
    /// Sweep speed, us per second (about 9 degrees per second): slow enough that the servo follows the pulse and the
    /// stall is found within a few degrees. [est until the bench: `minimeat-xdn`]
    pub const RATE_US_S: f64 = 100.0;
    /// Pulse past the real stop at which a stall is seen on the fault line: the error the servo needs to draw the switch's
    /// limit plus the two reads and the ramp during them. [est until the bench: `minimeat-xdn`]
    pub const LEAD_US: f64 = 60.0;
    /// Mean servo current over a step at or above which the step counts as stalled, mA: about twice the running current
    /// (0.2 A) and under the load switch's 0.6 A limit, so the stall is seen before the switch limits. [est until the bench]
    pub const STALL_MA: u16 = 450;
    /// The lead when the current saw the stall: it crosses [`Self::STALL_MA`] at a smaller error than the switch trips at.
    /// [est until the bench]
    pub const LEAD_CURRENT_US: f64 = 40.0;
    /// How many times the line is read in a step; the task spreads them evenly. The switch holds the line a deglitch (5 to 10 ms)
    /// after the overload ends as well as before it starts, so a fault of any kind is seen by reads 10 ms apart.
    pub const SAMPLES: u8 = 10;
    /// A stall is this many steps with the line seen low among the last [`Self::WINDOW`], not necessarily one after the other:
    /// a stalled servo whose supply the current limit pulls down may reset and restart, and the line then comes and goes.
    const STALL_STEPS: u32 = 2;
    const WINDOW: u8 = 5;
    /// The widest travel that can be the two posts, us: about 120 degrees on a typical servo. More is the servo's own end
    /// stops, which means the posts are absent or the linkage is not engaged. [est until the bench]
    pub const SPAN_MAX_US: u16 = 1300;
    /// After a power-up the line is not read this long (the start-up current), s.
    const BLANK_S: f64 = 0.5;
    const SETTLE_S: f64 = 1.5;
    /// Unpowered after a stall, so the switch lets go before the next sweep, s.
    const REST_S: f64 = 1.0;

    #[cfg(test)]
    fn pulse_us_for_test(&self) -> f64 {
        self.pulse_us
    }

    pub fn new() -> Self {
        Self {
            phase: HomePhase::Settle,
            pulse_us: Self::START_US,
            t_s: 0.0,
            active: 0,
            by_current: 0,
            lo_us: 0.0,
            hi_us: 0.0,
            lo_lead_us: Self::LEAD_US,
            hi_lead_us: Self::LEAD_US,
        }
    }

    /// One step: what to put on the servo, and the result once there is one (after which the servo is off). `lows`
    /// is how many of the step's [`Self::SAMPLES`] reads found the shared fault line asserted, `ma` the servo's mean
    /// current over them (0 if it is not sensed).
    pub fn tick(&mut self, lows: u8, ma: u16) -> (ServoOut, Option<Result<ServoPulses, HomeFail>>) {
        self.t_s += Self::DT;
        let awake = self.t_s > Self::BLANK_S;
        let current = awake && ma >= Self::STALL_MA;
        let seen = (awake && lows > 0) || current;
        let mask = (1 << Self::WINDOW) - 1;
        self.active = ((self.active << 1) | u8::from(seen)) & mask;
        self.by_current = ((self.by_current << 1) | u8::from(current)) & mask;
        let stalled = self.active.count_ones() >= Self::STALL_STEPS;
        let lead = if self.by_current != 0 {
            Self::LEAD_CURRENT_US
        } else {
            Self::LEAD_US
        };
        let mut result = None;
        match self.phase {
            HomePhase::Settle => {
                if stalled {
                    result = Some(Err(HomeFail::FaultAtRest));
                } else if self.t_s >= Self::SETTLE_S {
                    self.phase = HomePhase::Low;
                    self.t_s = 0.0;
                    self.active = 0;
                    self.by_current = 0;
                }
            }
            HomePhase::Low => {
                self.pulse_us -= Self::RATE_US_S * Self::DT;
                if stalled {
                    self.lo_us = self.pulse_us;
                    self.lo_lead_us = lead;
                    self.phase = HomePhase::RestLow;
                    self.t_s = 0.0;
                    self.active = 0;
                    self.by_current = 0;
                } else if self.pulse_us <= Self::LIMIT_US.0 {
                    result = Some(Err(HomeFail::NoStopLow));
                }
            }
            HomePhase::RestLow => {
                if self.t_s >= Self::REST_S {
                    self.phase = HomePhase::High;
                    self.t_s = 0.0;
                    self.active = 0;
                    self.by_current = 0;
                }
            }
            HomePhase::High => {
                self.pulse_us += Self::RATE_US_S * Self::DT;
                if stalled {
                    self.hi_us = self.pulse_us;
                    self.hi_lead_us = lead;
                    self.phase = HomePhase::RestHigh;
                    self.t_s = 0.0;
                    self.active = 0;
                    self.by_current = 0;
                } else if self.pulse_us >= Self::LIMIT_US.1 {
                    result = Some(Err(HomeFail::NoStopHigh));
                }
            }
            HomePhase::RestHigh => {
                if self.t_s >= Self::REST_S {
                    let p = ServoPulses {
                        closed_us: (self.lo_us + self.lo_lead_us + 0.5) as u16,
                        open_us: (self.hi_us - self.hi_lead_us + 0.5) as u16,
                    };
                    result = Some(if p.valid() && p.closed_us.abs_diff(p.open_us) <= Self::SPAN_MAX_US {
                        Ok(p)
                    } else {
                        Err(HomeFail::Span)
                    });
                }
            }
            HomePhase::Done => {}
        }
        if result.is_some() {
            self.phase = HomePhase::Done;
        }
        let rest = matches!(self.phase, HomePhase::RestLow | HomePhase::RestHigh | HomePhase::Done);
        (
            ServoOut {
                pulse_us: (self.pulse_us + 0.5) as u16,
                power: !rest,
            },
            result,
        )
    }
}

impl Default for Homing {
    fn default() -> Self {
        Self::new()
    }
}

/// Fan speed fraction to PWM duty: piecewise linear through `(speed, duty)` points, speed ascending.
/// Speed 0 is always duty 0.
#[derive(Clone, Copy, Debug)]
pub struct FanCurve {
    pub points: &'static [(f64, f64)],
}

impl FanCurve {
    /// Duty equals speed. [est until `.2.2` picks the fan and its datasheet curve is known]
    pub const LINEAR: FanCurve = FanCurve {
        points: &[(0.0, 0.0), (1.0, 1.0)],
    };

    pub fn duty(&self, speed: f64) -> f64 {
        if speed <= 0.0 {
            return 0.0;
        }
        let s = speed.min(1.0);
        let mut prev = self.points[0];
        for &(x, y) in &self.points[1..] {
            if s == x {
                return y;
            }
            if s < x {
                return prev.1 + (y - prev.1) * (s - prev.0) / (x - prev.0);
            }
            prev = (x, y);
        }
        prev.1
    }
}

/// Speed to duty, with an optional kick: the first second of a start runs at least `kick` duty so a
/// fan that needs more than its running minimum to get going does.
#[derive(Clone, Debug)]
pub struct FanDrive {
    pub curve: FanCurve,
    pub kick: Option<f64>,
    running: bool,
}

impl FanDrive {
    pub fn new(curve: FanCurve, kick: Option<f64>) -> Self {
        Self {
            curve,
            kick,
            running: false,
        }
    }

    /// PWM duty (0..1) for the speed to apply this second.
    pub fn duty(&mut self, speed: f64) -> f64 {
        let d = self.curve.duty(speed);
        let starting = d > 0.0 && !self.running;
        self.running = d > 0.0;
        match self.kick {
            Some(k) if starting => d.max(k),
            _ => d,
        }
    }
}

/// Duty above which a silent tach is a stall (docs/protocol.md `fan_stall`).
const STALL_DUTY: f64 = 0.3;
/// A stall is raised after this long of driving a fan that does not turn, s (spin-up included).
const STALL_AFTER_S: f64 = 5.0;
/// ... and cleared after this long of it turning again, s.
const RECOVER_AFTER_S: f64 = 3.0;
/// The tach must read at least this fraction of the speed expected from the duty to count as turning.
const TURNING_FRAC: f64 = 0.25;

/// Raises `fan_stall` when the fan is driven but the tach shows it not turning.
#[derive(Clone, Debug, Default)]
pub struct TachWatch {
    stalled: bool,
    bad_s: f64,
    good_s: f64,
}

impl TachWatch {
    pub fn stalled(&self) -> bool {
        self.stalled
    }

    /// One step of `dt` seconds: `duty` applied over it, `rpm` the tach's mean over it (`None` if it
    /// had nothing to measure) and `rpm_max` the fan's speed at full duty. Returns the new state
    /// when it changed.
    pub fn tick(&mut self, duty: f64, rpm: Option<f64>, rpm_max: f64, dt: f64) -> Option<bool> {
        let rpm = rpm?;
        if duty < STALL_DUTY {
            // not driven hard enough to say; a stalled fan stays so until it turns
            (self.bad_s, self.good_s) = (0.0, 0.0);
            return None;
        }
        if rpm >= TURNING_FRAC * duty * rpm_max {
            self.bad_s = 0.0;
            self.good_s += dt;
            if self.stalled && self.good_s >= RECOVER_AFTER_S {
                self.stalled = false;
                return Some(false);
            }
        } else {
            self.good_s = 0.0;
            self.bad_s += dt;
            if !self.stalled && self.bad_s >= STALL_AFTER_S {
                self.stalled = true;
                return Some(true);
            }
        }
        None
    }
}

/// The advertised source current the fan and servo need together (ADR 0004): worst case is the radio's burst, the
/// fan and a servo at its 0.6 A limit, about 1.1 A. Below this the box does not run them at all.
pub const SUPPLY_MIN_MA: u16 = 1500;
/// Consecutive reads, one a second, before the supply is judged good or bad (a CC reading can glitch).
const SUPPLY_GOOD_READS: u8 = 2;
const SUPPLY_BAD_READS: u8 = 3;

/// Decides whether the USB-C source can run the fan and the servo, from its advertised current. All or nothing:
/// there is no reduced mode. Until the first verdict the actuators stay off and no fault is raised.
#[derive(Clone, Copy, Debug, Default)]
pub struct SupplyWatch {
    verdict: Option<bool>,
    run: u8,
}

impl SupplyWatch {
    /// The actuators may run.
    pub fn ok(&self) -> bool {
        self.verdict == Some(true)
    }

    /// One read of the advertised current. Returns the new fault state (`true` = `supply` raised) when it changed.
    pub fn tick(&mut self, advertised_ma: Option<u16>) -> Option<bool> {
        let good = advertised_ma.is_some_and(|ma| ma >= SUPPLY_MIN_MA);
        // the run counts reads that disagree with the current verdict (or with nothing yet)
        let agrees = self.verdict == Some(good);
        if agrees {
            self.run = 0;
            return None;
        }
        self.run += 1;
        let need = if good { SUPPLY_GOOD_READS } else { SUPPLY_BAD_READS };
        if self.run < need {
            return None;
        }
        let first = self.verdict.is_none();
        self.verdict = Some(good);
        self.run = 0;
        // the first verdict being good is not a change; being bad is a fault
        (!(first && good)).then_some(!good)
    }
}

/// Consecutive one-second samples of the fault line held low before it counts: the TPS2553 only asserts it after a
/// deglitch of several ms, and a start-up into the output capacitors never lasts that long, so a real trip is steady.
const LOAD_TRIP_READS: u8 = 3;

/// Latches when a load switch holds the shared fault line low (ADR 0004): the servo stalled or the fan jammed or a
/// short. Both loads then stay off until the next reboot; the switches thermal-cycle on their own, and retrying
/// from here would only keep cycling them.
#[derive(Clone, Copy, Debug, Default)]
pub struct LoadWatch {
    low: u8,
    tripped: bool,
}

impl LoadWatch {
    pub fn tripped(&self) -> bool {
        self.tripped
    }

    /// One read of the line (`low` = asserted). Returns `true` once, when it latches.
    pub fn tick(&mut self, low: bool) -> bool {
        if self.tripped {
            return false;
        }
        self.low = if low { self.low + 1 } else { 0 };
        self.tripped = self.low >= LOAD_TRIP_READS;
        self.tripped
    }
}

/// Mean current while the servo should be holding still above which it is pushing against something, mA. A servo holds a
/// light flap on a few tens of mA; pushing past a stop it wants more than the switch's 0.6 A within a few degrees. [est
/// until the bench, `minimeat-vzg`]
pub const JAM_MA: u16 = 300;
/// Peak current below which a real move did not run the motor, mA. [est: the HS-5065MG runs on about 0.2 A]
pub const OPEN_MA: u16 = 50;
/// Moves that drew nothing must have taken the pulse over this many us between them (about 3 degrees) before it counts:
/// the motor would have had to run, where a small move may sit inside the servo's deadband.
pub const OPEN_SPAN_US: u16 = 30;
/// Holding samples a move needs before its holding current is judged.
const HOLD_SAMPLES: u16 = 3;
/// Moves running that must agree before `servo` is raised, and cleared.
const BAD_MOVES: u8 = 2;
const GOOD_MOVES: u8 = 2;
/// While `servo` is raised the servo is driven again this often, s: the flap is not where it was told, and a flap that
/// comes free (or a servo plugged back in) only gets there, and clears the fault, on a move. Each retry is one move of
/// [`HOLD_S`] or so, held to the switch's limit if it is still jammed.
pub const RETRY_S: f64 = 60.0;

/// The servo's current over one move: from when it is powered until it is switched off again.
#[derive(Clone, Copy, Debug, PartialEq, Eq)]
pub struct MoveMa {
    pub peak: u16,
    pub mean: u16,
}

#[derive(Clone, Copy, Debug)]
struct Move {
    peak: u16,
    sum: u32,
    n: u16,
    hold_sum: u32,
    hold_n: u16,
    lo_us: u16,
    hi_us: u16,
    last: u16,
    last_us: u16,
}

/// Watches the servo's supply current (`minimeat-y8a`): each move's peak and mean for the status, and the `servo` fault
/// when a move's current is wrong. While it should be holding still (the pulse unchanged since the step before) a servo
/// that keeps drawing [`JAM_MA`] is pushing against something; moves whose peaks stay under [`OPEN_MA`] while they take the
/// pulse over [`OPEN_SPAN_US`] did not run the motor at all (a ramp is many small moves, so the span is over the run of
/// them). A move that drew current and is not jammed is a good one. It only warns: the actuators carry on, and the load
/// switch is what cuts a servo that stalls hard.
#[derive(Clone, Copy, Debug, Default)]
pub struct ServoWatch {
    now: Option<Move>,
    last: Option<MoveMa>,
    bad: u8,
    good: u8,
    raised: bool,
    idle_s: f64,
    /// The pulse the last move left the servo at, where the next one starts from; `None` when not known.
    rest_us: Option<u16>,
    /// The pulses the moves since the last one that drew current have covered.
    quiet: Option<(u16, u16)>,
}

impl ServoWatch {
    /// The last finished move's current.
    pub fn last(&self) -> Option<MoveMa> {
        self.last
    }

    pub fn raised(&self) -> bool {
        self.raised
    }

    /// One current sample while the servo is powered, at pulse `pulse_us`; `holding` when the pulse has not changed since
    /// the step before (the servo should have arrived).
    pub fn sample(&mut self, ma: u16, pulse_us: u16, holding: bool) {
        // the span counts from where the last move left the servo
        let from = self.rest_us.unwrap_or(pulse_us);
        let m = self.now.get_or_insert(Move {
            peak: 0,
            sum: 0,
            n: 0,
            hold_sum: 0,
            hold_n: 0,
            lo_us: from,
            hi_us: from,
            last: 0,
            last_us: pulse_us,
        });
        m.peak = m.peak.max(ma);
        m.sum += u32::from(ma);
        m.n = m.n.saturating_add(1);
        if holding {
            m.hold_sum += u32::from(ma);
            m.hold_n = m.hold_n.saturating_add(1);
        }
        m.lo_us = m.lo_us.min(pulse_us);
        m.hi_us = m.hi_us.max(pulse_us);
        m.last = ma;
        m.last_us = pulse_us;
    }

    /// Something else drove the servo (homing, a jog): the move under way is not one, and where it is is not known.
    pub fn abandon(&mut self) {
        self.now = None;
        self.rest_us = None;
        self.quiet = None;
    }

    /// The servo was just switched off: the move is over. Returns the new fault state when it changed.
    pub fn end(&mut self) -> Option<bool> {
        let m = self.now.take()?;
        self.rest_us = Some(m.last_us);
        self.last = Some(MoveMa {
            peak: m.peak,
            mean: (m.sum / u32::from(m.n)) as u16,
        });
        let jammed = m.hold_n >= HOLD_SAMPLES && m.hold_sum / u32::from(m.hold_n) >= u32::from(JAM_MA);
        let drew = m.peak >= OPEN_MA;
        let mut open = false;
        if drew {
            self.quiet = None;
        } else {
            let (lo, hi) = self
                .quiet
                .map_or((m.lo_us, m.hi_us), |(lo, hi)| (lo.min(m.lo_us), hi.max(m.hi_us)));
            open = hi - lo >= OPEN_SPAN_US;
            // each further span of quiet travel is another bad move
            self.quiet = Some(if open { (m.last_us, m.last_us) } else { (lo, hi) });
        }
        if jammed || open {
            self.good = 0;
            self.bad = self.bad.saturating_add(1);
            if !self.raised && self.bad >= BAD_MOVES {
                self.raised = true;
                return Some(true);
            }
        } else if drew {
            self.bad = 0;
            self.good = self.good.saturating_add(1);
            if self.raised && self.good >= GOOD_MOVES {
                self.raised = false;
                return Some(false);
            }
        }
        None
    }

    /// One step of `dt` seconds with the servo off: true when it is time to drive it again while the fault is raised.
    pub fn retry_due(&mut self, dt: f64) -> bool {
        if !self.raised {
            self.idle_s = 0.0;
            return false;
        }
        self.idle_s += dt;
        let due = self.idle_s >= RETRY_S;
        if due {
            self.idle_s = 0.0;
        }
        due
    }

    /// The load switch just latched: the servo is to blame if it was drawing [`JAM_MA`] or more. Returns true when that
    /// raises the fault now.
    pub fn blame(&mut self) -> bool {
        let high = self.now.is_some_and(|m| m.last >= JAM_MA);
        let raise = high && !self.raised;
        self.raised |= high;
        raise
    }
}

#[cfg(test)]
mod tests {
    use super::*;

    /// A servo with hard stops at `lo` and `hi` us that draws the tripping current (the fault line low) once its power is on and
    /// the pulse is `trip` us past either. Returns what homing answered and how long it took, s.
    fn home_against(lo: f64, hi: f64, trip: f64) -> (Result<ServoPulses, HomeFail>, f64) {
        let mut h = Homing::new();
        let mut line = false;
        let mut t = 0.0;
        loop {
            t += Homing::DT;
            assert!(t < 120.0, "homing never ended");
            let (out, done) = h.tick(if line { Homing::SAMPLES } else { 0 }, 0);
            if let Some(r) = done {
                assert!(!out.power, "the servo is off when it ends");
                return (r, t);
            }
            let p = f64::from(out.pulse_us);
            line = out.power && (p < lo - trip || p > hi + trip);
        }
    }

    /// The same servo, also sensed: 200 mA running, rising with the error past a stop toward 1.1 A stalled, held at the
    /// switch's 0.6 A limit (where the line goes low, `trip` us past the stop). `sense` false: the current reads 0.
    fn home_sensed(lo: f64, hi: f64, trip: f64, sense: bool) -> Result<ServoPulses, HomeFail> {
        let mut h = Homing::new();
        let (mut line, mut ma) = (false, 0u16);
        for _ in 0..1200 {
            let (out, done) = h.tick(if line { Homing::SAMPLES } else { 0 }, if sense { ma } else { 0 });
            if let Some(r) = done {
                return r;
            }
            let p = f64::from(out.pulse_us);
            let err = (lo - p).max(p - hi).max(0.0);
            // the error at which the wanted current reaches the limit is `trip`
            let wanted = 200.0 + 900.0 * (err * (600.0 - 200.0) / (900.0 * trip)).min(1.0);
            line = out.power && err > trip;
            ma = if out.power { wanted.min(600.0) as u16 } else { 0 };
        }
        panic!("homing never ended");
    }

    #[test]
    fn the_current_sees_the_stall_first_and_homes_as_well_as_the_line() {
        for (lo, hi) in [(1000.0, 2000.0), (1130.0, 1870.0), (900.0, 2100.0)] {
            for sense in [true, false] {
                let p = home_sensed(lo, hi, 30.0, sense).unwrap_or_else(|e| panic!("{lo}..{hi} sense {sense}: {e:?}"));
                assert!(
                    (f64::from(p.closed_us) - lo).abs() <= 15.0 && (f64::from(p.open_us) - hi).abs() <= 15.0,
                    "{lo}..{hi} sense {sense}: found {p:?}"
                );
            }
        }
        // a servo held high at rest (jammed in the middle) is not homed
        let mut h = Homing::new();
        let r = (0..40).find_map(|_| h.tick(0, 700).1).unwrap();
        assert_eq!(r, Err(HomeFail::FaultAtRest));
        // the start-up surge in the first half second is not read
        let mut h = Homing::new();
        for _ in 0..4 {
            assert!(h.tick(0, 900).1.is_none());
        }
        assert!(
            (0..20).all(|_| h.tick(0, 200).1.is_none()),
            "running current after the surge is not a stall"
        );
    }

    #[test]
    fn homing_finds_the_stops_of_servos_with_different_travel() {
        for (lo, hi) in [(1000.0, 2000.0), (1130.0, 1870.0), (900.0, 2100.0), (1250.0, 1750.0)] {
            let (r, took) = home_against(lo, hi, 30.0);
            let p = r.unwrap_or_else(|e| panic!("{lo}..{hi}: {e:?}"));
            assert!(
                (f64::from(p.closed_us) - lo).abs() <= 15.0 && (f64::from(p.open_us) - hi).abs() <= 15.0,
                "{lo}..{hi} found as {p:?}"
            );
            // well inside the watchdog's 30 s only because the task beats it: it should still not be long
            assert!(took < 30.0, "{lo}..{hi} took {took} s");
        }
    }

    #[test]
    fn a_servo_that_never_stalls_finds_no_stop_and_the_other_failures_are_named() {
        // the line never asserts (no posts, or a switch that does not trip): the low sweep runs out
        let mut h = Homing::new();
        let r = (0..2000).find_map(|_| h.tick(0, 0).1).unwrap();
        assert_eq!(r, Err(HomeFail::NoStopLow));
        // a stop below but none above
        assert_eq!(home_against(1000.0, 3000.0, 30.0).0, Err(HomeFail::NoStopHigh));
        // stops 1400 us apart are the servo's own end stops
        assert_eq!(home_against(790.0, 2210.0, 30.0).0, Err(HomeFail::Span));
        // stops 100 us apart are not a damper
        assert_eq!(home_against(1450.0, 1550.0, 30.0).0, Err(HomeFail::Span));
        // already low at rest: not a stall
        let mut h = Homing::new();
        let r = (0..40).find_map(|_| h.tick(Homing::SAMPLES, 0).1).unwrap();
        assert_eq!(r, Err(HomeFail::FaultAtRest));
    }

    #[test]
    fn the_line_is_not_read_through_the_start_up_current_and_a_blip_is_not_a_stall() {
        let mut h = Homing::new();
        // a start-up pulse on the line in the first half second
        for _ in 0..4 {
            assert!(h.tick(Homing::SAMPLES, 0).1.is_none());
        }
        // a single low read in the sweep is a blip
        let mut seen = 0;
        let mut r = None;
        for i in 0..3000 {
            let (out, done) = h.tick(u8::from(i == 40), 0);
            if let Some(d) = done {
                r = Some(d);
                break;
            }
            seen = out.pulse_us;
        }
        assert_eq!(
            r,
            Some(Err(HomeFail::NoStopLow)),
            "the blip did not end the sweep (last pulse {seen})"
        );
    }

    #[test]
    fn a_line_that_chatters_through_the_stall_is_still_a_stall() {
        // a stalled servo whose supply the current limit pulls down resets and restarts: the line is low in one step in
        // three, and for part of that step only. Two lows in a row, the first detector, never sees it.
        for gap in [2usize, 3, 4] {
            let mut h = Homing::new();
            let mut stalled_steps = 0usize;
            let mut t = 0.0;
            let r = loop {
                t += Homing::DT;
                assert!(t < 120.0);
                let mut lows = 0;
                // push the pulse past the true stop (1000 us, trip 30) and the line chatters; before it, quiet
                let last = h.pulse_us_for_test();
                if last < 970.0 || last > 2030.0 {
                    stalled_steps += 1;
                    if stalled_steps.is_multiple_of(gap) {
                        lows = 3;
                    }
                }
                let (_, done) = h.tick(lows, 0);
                if let Some(r) = done {
                    break r;
                }
            };
            let p = r.unwrap_or_else(|e| panic!("gap {gap}: {e:?}"));
            assert!(
                (f64::from(p.closed_us) - 1000.0).abs() <= 70.0,
                "gap {gap}: found {p:?} for a stop at 1000 (a line that comes and goes is seen later, so the servo has pushed further)"
            );
        }
    }

    #[test]
    fn homing_holds_the_servo_off_while_the_switch_lets_go() {
        let mut h = Homing::new();
        let mut line = false;
        let mut off_run = 0;
        let mut longest = 0;
        loop {
            let (out, done) = h.tick(if line { Homing::SAMPLES } else { 0 }, 0);
            let p = f64::from(out.pulse_us);
            line = out.power && !(1000.0 - 30.0..=2000.0 + 30.0).contains(&p);
            off_run = if out.power { 0 } else { off_run + 1 };
            longest = longest.max(off_run);
            if done.is_some() {
                break;
            }
        }
        assert!(
            longest >= 10,
            "unpowered for at least a second after a stall: {longest} steps"
        );
    }

    #[test]
    fn a_steady_fault_latches_and_a_blip_does_not() {
        let mut w = LoadWatch::default();
        assert!(!w.tick(true) && !w.tick(true));
        assert!(!w.tick(false), "a blip resets the count");
        assert!(!w.tick(true) && !w.tick(true));
        assert!(w.tick(true), "the third in a row latches");
        assert!(w.tripped());
        assert!(!w.tick(false), "stays latched, and says so once");
        assert!(w.tripped());
    }

    #[test]
    fn supply_needs_1500_ma_and_debounces_both_ways() {
        let mut w = SupplyWatch::default();
        assert!(!w.ok(), "off until the first verdict");
        assert_eq!(w.tick(Some(3000)), None);
        assert!(!w.ok());
        assert_eq!(w.tick(Some(3000)), None, "a good source from the start raises nothing");
        assert!(w.ok());
        // a glitch does not drop it, a lasting loss does
        assert_eq!(w.tick(Some(500)), None);
        assert_eq!(w.tick(Some(500)), None);
        assert_eq!(w.tick(Some(3000)), None);
        assert!(w.ok());
        for _ in 0..2 {
            assert_eq!(w.tick(None), None);
        }
        assert_eq!(w.tick(None), Some(true));
        assert!(!w.ok());
        assert_eq!(w.tick(Some(1500)), None);
        assert_eq!(w.tick(Some(1500)), Some(false), "1.5 A is enough");
        assert!(w.ok());
    }

    #[test]
    fn a_default_source_is_a_fault_from_the_start() {
        let mut w = SupplyWatch::default();
        assert_eq!(w.tick(Some(500)), None);
        assert_eq!(w.tick(Some(500)), None);
        assert_eq!(w.tick(Some(500)), Some(true));
        assert!(!w.ok());
    }

    #[test]
    fn servo_pulse_follows_the_calibration_either_way_round() {
        let c = ServoCal::DEFAULT;
        assert_eq!(
            [c.pulse_us(0.0), c.pulse_us(45.0), c.pulse_us(90.0)],
            [1000, 1500, 2000]
        );
        assert_eq!(c.pulse_us(-10.0), 1000, "clamped to the stops");
        assert_eq!(c.pulse_us(120.0), 2000);
        let flipped = ServoCal {
            closed_us: 2100.0,
            open_us: 900.0,
        };
        assert_eq!(
            [flipped.pulse_us(0.0), flipped.pulse_us(45.0), flipped.pulse_us(90.0)],
            [2100, 1500, 900]
        );
    }

    #[test]
    fn servo_slews_gates_power_and_jumps_the_first_time() {
        let mut s = ServoDrive::new(ServoCal::DEFAULT);
        // first command: straight there, powered for the hold time
        let o = s.tick(30.0, 1.0);
        assert_eq!(
            o,
            ServoOut {
                pulse_us: 1333,
                power: true
            }
        );
        assert!(s.tick(30.0, 1.0).power);
        assert!(!s.tick(30.0, 1.0).power, "off after {HOLD_S} s still");
        // a big move is slewed, powered all the way and for the hold after
        let mut angles = vec![];
        let mut powered = vec![];
        for _ in 0..8 {
            let o = s.tick(90.0, 1.0);
            angles.push(s.angle_deg().unwrap());
            powered.push(o.power);
        }
        assert_eq!(angles[..2], [90.0, 90.0], "30 -> 90 at 60 deg/s takes one second");
        assert_eq!(powered, [true, true, false, false, false, false, false, false]);
        // slower servo, smaller steps, both directions
        s.slew_dps = 20.0;
        s.tick(0.0, 1.0);
        assert_eq!(s.angle_deg(), Some(70.0));
        s.tick(80.0, 1.0);
        assert_eq!(s.angle_deg(), Some(80.0));
    }

    #[test]
    fn a_target_outside_the_travel_is_clamped() {
        let mut s = ServoDrive::new(ServoCal::DEFAULT);
        s.tick(-5.0, 1.0);
        assert_eq!(s.angle_deg(), Some(0.0));
        s.tick(500.0, 1.0);
        assert_eq!(s.angle_deg(), Some(60.0));
    }

    #[test]
    fn fan_curve_interpolates() {
        const C: FanCurve = FanCurve {
            points: &[(0.0, 0.0), (0.2, 0.3), (1.0, 1.0)],
        };
        assert_eq!(C.duty(0.0), 0.0);
        assert!((C.duty(0.1) - 0.15).abs() < 1e-12);
        assert!((C.duty(0.2) - 0.3).abs() < 1e-12);
        assert!((C.duty(0.6) - 0.65).abs() < 1e-12);
        assert_eq!(C.duty(1.5), 1.0);
        assert_eq!(C.duty(-1.0), 0.0);
        assert_eq!(FanCurve::LINEAR.duty(0.37), 0.37);
    }

    #[test]
    fn fan_kick_applies_to_starts_only() {
        let mut f = FanDrive::new(FanCurve::LINEAR, Some(0.6));
        assert_eq!(f.duty(0.2), 0.6, "start");
        assert_eq!(f.duty(0.2), 0.2, "running");
        assert_eq!(f.duty(0.0), 0.0);
        assert_eq!(f.duty(0.9), 0.9, "a start already above the kick");
        assert_eq!(f.duty(0.0), 0.0);
        assert_eq!(f.duty(0.2), 0.6);
        let mut plain = FanDrive::new(FanCurve::LINEAR, None);
        assert_eq!(plain.duty(0.2), 0.2);
    }

    #[test]
    fn tach_watch_raises_and_clears_a_stall_with_hysteresis() {
        let mut t = TachWatch::default();
        let events: Vec<_> = (0..12).map(|_| t.tick(0.5, Some(0.0), 3000.0, 1.0)).collect();
        assert_eq!(events.iter().position(|e| *e == Some(true)), Some(4), "after 5 s");
        assert_eq!(events.iter().flatten().count(), 1, "once");
        // a blip of turning does not clear it, and nor does running below the stall duty
        assert_eq!(t.tick(0.5, Some(1500.0), 3000.0, 1.0), None);
        assert_eq!(t.tick(0.5, Some(0.0), 3000.0, 1.0), None);
        assert_eq!(t.tick(0.1, Some(0.0), 3000.0, 1.0), None);
        assert!(t.stalled());
        let cleared: Vec<_> = (0..4).map(|_| t.tick(0.5, Some(1500.0), 3000.0, 1.0)).collect();
        assert_eq!(cleared, [None, None, Some(false), None]);
    }

    #[test]
    fn tach_watch_ignores_a_healthy_fan_and_a_missing_reading() {
        let mut t = TachWatch::default();
        for _ in 0..100 {
            // rpm tracks duty, with the slack of a real fan
            assert_eq!(t.tick(0.4, Some(0.4 * 3000.0 * 0.9), 3000.0, 1.0), None);
            assert_eq!(t.tick(0.0, Some(0.0), 3000.0, 1.0), None);
            assert_eq!(t.tick(0.8, None, 3000.0, 1.0), None);
        }
        assert!(!t.stalled());
    }

    /// Feeds one move: `run` samples moving across `span` us, then `hold` samples holding, all at `ma` running and `hold_ma`
    /// holding.
    fn one_move(w: &mut ServoWatch, span: u16, ma: u16, hold_ma: u16) -> Option<bool> {
        for i in 0..10 {
            w.sample(ma, 1500 + span * i / 9, false);
        }
        for _ in 0..10 {
            w.sample(hold_ma, 1500 + span, true);
        }
        w.end()
    }

    #[test]
    fn servo_watch_raises_on_two_bad_moves_and_clears_on_two_good() {
        let mut w = ServoWatch::default();
        assert_eq!(w.last(), None);
        assert_eq!(one_move(&mut w, 100, 200, 20), None);
        assert_eq!(w.last(), Some(MoveMa { peak: 200, mean: 110 }));
        // jammed: still pushing once it should hold
        assert_eq!(one_move(&mut w, 100, 600, 600), None, "one bad move is not enough");
        assert_eq!(one_move(&mut w, 100, 600, 500), Some(true));
        assert!(w.raised());
        assert_eq!(one_move(&mut w, 100, 600, 500), None, "raised once");
        // raised, it asks for the servo to be driven again every minute
        let due = (0..180).filter(|_| w.retry_due(1.0)).count();
        assert_eq!(due, 3);
        assert_eq!(one_move(&mut w, 100, 200, 20), None);
        assert_eq!(one_move(&mut w, 100, 200, 20), Some(false));
        // unplugged: a real move draws nothing
        assert_eq!(one_move(&mut w, 100, 3, 3), None);
        assert_eq!(one_move(&mut w, 100, 0, 0), Some(true));
        assert_eq!(one_move(&mut w, 100, 200, 20), None);
        assert_eq!(one_move(&mut w, 100, 200, 20), Some(false));
    }

    #[test]
    fn small_moves_and_short_ones_are_not_judged_open() {
        let mut w = ServoWatch::default();
        assert!((0..120).all(|_| !w.retry_due(1.0)), "no retries without the fault");
        // 2 degrees with nothing drawn: inside the deadband, and holding at 0 is not a jam
        for _ in 0..4 {
            assert_eq!(one_move(&mut w, 20, 5, 5), None);
        }
        assert!(!w.raised());
        // a move switched off before it held: only its span can judge it
        w.sample(0, 1500, false);
        w.sample(0, 1600, false);
        assert_eq!(w.end(), None);
        // a move in one step is seen at its new pulse only: the span counts from where the last one ended
        w.sample(0, 1700, false);
        assert_eq!(w.end(), Some(true));
        assert_eq!(w.end(), None, "nothing under way");
    }

    #[test]
    fn a_ramp_of_small_quiet_moves_adds_up_and_quiet_moves_never_clear() {
        let mut w = ServoWatch::default();
        // 5 us a move, nothing drawn: the second 30 us of travel raises it
        let mut raised_at = None;
        for i in 0..20u16 {
            w.sample(0, 1500 + 5 * i, false);
            for _ in 0..5 {
                w.sample(0, 1500 + 5 * i, true);
            }
            if w.end() == Some(true) {
                raised_at = Some(i);
            }
        }
        assert_eq!(raised_at, Some(12));
        // holding still on nothing (unplugged, at rest) is no evidence it is back
        for _ in 0..5 {
            assert_eq!(one_move(&mut w, 0, 0, 0), None);
        }
        assert!(w.raised());
        // back and forth inside the deadband never adds up
        let mut w = ServoWatch::default();
        for i in 0..40u16 {
            w.sample(0, 1500 + 4 * (i % 2), true);
            assert_eq!(w.end(), None);
        }
    }

    #[test]
    fn a_tripped_switch_is_blamed_on_the_servo_only_if_it_was_drawing() {
        let mut w = ServoWatch::default();
        assert!(!w.blame(), "not powered");
        w.sample(20, 1500, true);
        assert!(!w.blame(), "holding quietly: the fan tripped it");
        w.sample(600, 1500, true);
        assert!(w.blame());
        assert!(w.raised());
        assert!(!w.blame(), "raised once");
        // homing or a jog is not a move
        let mut w = ServoWatch::default();
        w.sample(600, 1500, true);
        w.abandon();
        assert_eq!(w.end(), None);
        assert_eq!(w.last(), None);
    }
}
