NathanHowell/minimeater/fw/minimeater-fw/src/board.rs

//! The ESP32-C6 board: `minimeater-app`'s peripheral traits bound to esp-hal (`.4.16.1`). This module is
//! the only place that knows pin numbers and peripheral instances.
//!
//! Pin map: the schematic's contract (`.3.3`; hw/minimeater.kicad_sch). Constraints honoured (ADR 0001): CC sense
//! on ADC1 pins (GPIO0-6), button on GPIO9 (BOOT), nothing on GPIO8 (strapping) or GPIO12/13 (USB). The probe jacks' rings are
//! GPIO7, 6, 5 and 4 for jacks 1-4 (smart probes, minimeat-098): not driven yet.
//!
//! | Signal | GPIO | | Signal | GPIO |
//! |---|---|---|---|---|
//! | USB-C CC1 / CC2 (ADC1) | 0 / 1 | | I2C SDA / SCL (ADS122C04, TMP117, ATECC608B) | 23 / 22 |
//! | probe rings 1-4 (smart probes, unused) | 7 / 6 / 5 / 4 | | fan PWM / tach | 18 / 19 |
//! | button (BOOT) | 9 | | servo PWM / power enable | 20 / 21 |
//! | status LED | 10 | | fan power enable (TPS2553) | 11 |
//! | load-switch fault (open drain, shared) | 3 | | spare (no-connect) | 8 / 15 |
//! | servo current sense (INA181 across the shunt, ADC1) | 2 | | | |
//! | UART0 TX / RX (test pads) | 16 / 17 | | USB D- / D+ | 12 / 13 |

use core::cell::RefCell;

use embassy_embedded_hal::adapter::BlockingAsync;
use embassy_embedded_hal::shared_bus::asynch::i2c::I2cDevice;
use embassy_sync::blocking_mutex::Mutex as BlockingMutex;
use embassy_sync::blocking_mutex::raw::CriticalSectionRawMutex;
use embassy_sync::mutex::Mutex;
use embassy_time::{Delay, Instant};
use esp_hal::Async;
use esp_hal::analog::adc::{Adc, AdcCalCurve, AdcConfig, AdcPin, Attenuation};
use esp_hal::gpio::{DriveMode, Input, InputConfig, Level, Output, OutputConfig, Pull};
use esp_hal::i2c::master::I2c;
use esp_hal::ledc::channel::{self, ChannelIFace};
use esp_hal::ledc::timer::{self, TimerIFace};
use esp_hal::ledc::{LSGlobalClkSource, Ledc, LowSpeed};
use esp_hal::pcnt::{Pcnt, channel::EdgeMode, unit::Unit};
use esp_hal::peripherals::{ADC1, FROM_CPU_INTR0, GPIO0, GPIO1, GPIO2, Peripherals, TIMG0, TIMG1, USB_DEVICE, WIFI};
use esp_hal::time::{Duration, Rate};
use esp_hal::timer::timg::{MwdtStage, TimerGroup, Wdt};
use esp_storage::FlashStorage;
use minimeater_app::drivers::{
    ads122c04, ads122c04::Ads122c04, atecc608, atecc608::Atecc608, servo_sense, tmp117, tmp117::Tmp117, usb_cc,
};
use minimeater_app::hal::{Board, FlashRegion, Io, PwmServo, ServoCurrent, Tach, UsbPower, Watchdog};
use static_cell::StaticCell;

/// Configuration region: the `nvs` partition of espflash's default partition table. `.4.13` (OTA)
/// replaces the table; keep this in step with it.
const CONFIG_OFFSET: u32 = 0x9000;
const CONFIG_LEN: u32 = 0x6000;
// the store's map needs two erase pages at least: one to write while the other is erased
const _: () = assert!(CONFIG_LEN >= 2 * FlashStorage::SECTOR_SIZE);

/// Fan PWM: 25 kHz (Intel 4-wire fan spec), 10-bit at the 80 MHz APB clock.
const FAN_PWM_HZ: u32 = 25_000;
/// Servo frame: 50 Hz, 14-bit, so 1 us is about 0.8 LSB.
const SERVO_PERIOD_US: u32 = 20_000;

/// The fan's tach gives two pulses per revolution (4-wire PC fan convention).
const TACH_PULSES_PER_REV: f64 = 2.0;

pub struct Esp;

/// The one I2C bus, shared by the probe ADC and the ambient sensor.
type Bus = I2cDevice<'static, CriticalSectionRawMutex, I2c<'static, Async>>;
type Probes = Ads122c04<Bus, Delay>;
type Pwm = channel::Channel<'static, LowSpeed>;

impl Board for Esp {
    type Probes = Probes;
    type Ambient = Tmp117<Bus>;
    type Fan = Pwm;
    type Tach = PcntTach;
    type Servo = PwmServo<Pwm>;
    type ServoPower = Output<'static>;
    type FanPower = Output<'static>;
    type LoadFault = Input<'static>;
    type ServoCurrent = ServoSense;
    type Led = Output<'static>;
    type Button = Input<'static>;
    type Config = FlashRegion<BlockingAsync<FlashStorage<'static>>>;
    type Usb = CcSense;
    type Watchdog = Mwdt;
}

/// The secure element behind the lock the REPL's enrolment task and the TLS signer share.
/// The I2C bus handle the secure element and the sensors share.
pub type ChipBus = Bus;

pub type SecureElement = minimeater_app::enrol::Shared<Bus, Delay>;

/// Peripherals the board does not wrap, for the runtime and (later) the radio.
pub struct Rest {
    pub timg0: TIMG0<'static>,
    pub sw_interrupt: FROM_CPU_INTR0<'static>,
    /// The USB Serial/JTAG port: console logs and Improv provisioning share it (`console.rs`).
    pub usb: USB_DEVICE<'static>,
    /// The radio (`net.rs`).
    pub wifi: WIFI<'static>,
    /// The secure element on the shared I2C bus (ADR 0005); the REPL's `identity` commands reach it (`enrol`).
    pub secure_element: &'static SecureElement,
}

/// Brings up every peripheral. Panics only on start-up bugs (bad static configuration); a missing
/// or broken chip shows up later as a read error, not here.
pub fn init(p: Peripherals) -> (Io<Esp>, Rest) {
    let out = OutputConfig::default();

    let i2c = I2c::new(
        p.I2C0,
        // 100 kHz: the ATECC608B (ADR 0005) wakes on SDA held low 60 us, which a write to address 0 gives
        // only at this speed; the ADC and the TMP117 need no more.
        esp_hal::i2c::master::Config::default().with_frequency(Rate::from_khz(100)),
    )
    .expect("i2c config")
    .with_sda(p.GPIO23)
    .with_scl(p.GPIO22)
    .into_async();
    static I2C_BUS: StaticCell<Mutex<CriticalSectionRawMutex, I2c<'static, Async>>> = StaticCell::new();
    let i2c = I2C_BUS.init(Mutex::new(i2c));
    let probes = Ads122c04::new(I2cDevice::new(i2c), ads122c04::ADDRESS, Delay);
    let ambient = Tmp117::new(I2cDevice::new(i2c), tmp117::ADDRESS);
    static SECURE_ELEMENT: StaticCell<SecureElement> = StaticCell::new();
    let secure_element = &*SECURE_ELEMENT.init(minimeater_app::enrol::share(Atecc608::new(
        I2cDevice::new(i2c),
        atecc608::ADDRESS,
        Delay,
    )));

    static LEDC: StaticCell<Ledc<'static>> = StaticCell::new();
    static FAN_TIMER: StaticCell<timer::Timer<'static, LowSpeed>> = StaticCell::new();
    static SERVO_TIMER: StaticCell<timer::Timer<'static, LowSpeed>> = StaticCell::new();
    let ledc = LEDC.init(Ledc::new(p.LEDC));
    ledc.set_global_slow_clock(LSGlobalClkSource::APBClk);
    let fan_timer = FAN_TIMER.init(ledc.timer(timer::Number::Timer0));
    fan_timer
        .configure(timer::config::Config {
            duty: timer::config::Duty::Duty10Bit,
            clock_source: timer::LSClockSource::APBClk,
            frequency: Rate::from_hz(FAN_PWM_HZ),
        })
        .expect("fan timer");
    let servo_timer = SERVO_TIMER.init(ledc.timer(timer::Number::Timer1));
    servo_timer
        .configure(timer::config::Config {
            duty: timer::config::Duty::Duty14Bit,
            clock_source: timer::LSClockSource::APBClk,
            frequency: Rate::from_hz(1_000_000 / SERVO_PERIOD_US),
        })
        .expect("servo timer");
    let mut fan = ledc.channel(channel::Number::Channel0, p.GPIO18);
    fan.configure(channel::config::Config {
        timer: fan_timer,
        duty_pct: 0,
        drive_mode: DriveMode::PushPull,
    })
    .expect("fan channel");
    let mut servo = ledc.channel(channel::Number::Channel1, p.GPIO20);
    servo
        .configure(channel::config::Config {
            timer: servo_timer,
            duty_pct: 0,
            drive_mode: DriveMode::PushPull,
        })
        .expect("servo channel");

    static PCNT: StaticCell<Pcnt<'static>> = StaticCell::new();
    let pcnt = PCNT.init(Pcnt::new(p.PCNT));
    let tach_pin = Input::new(p.GPIO19, InputConfig::default().with_pull(Pull::Up));
    let unit = &pcnt.unit0;
    unit.set_filter(Some(1023)).expect("tach filter");
    unit.channel0.set_edge_signal(tach_pin.peripheral_input());
    unit.channel0.set_input_mode(EdgeMode::Hold, EdgeMode::Increment);
    unit.clear();
    unit.resume();

    // ADC1 reads the CC pins and the servo current: one converter, shared by the two readers (both in the actuator task)
    let mut adc_cfg = AdcConfig::new();
    let cc1 = adc_cfg.enable_pin_with_cal::<_, AdcCalCurve<ADC1<'static>>>(p.GPIO0, Attenuation::_11dB);
    let cc2 = adc_cfg.enable_pin_with_cal::<_, AdcCalCurve<ADC1<'static>>>(p.GPIO1, Attenuation::_11dB);
    // 0 to 1.8 V (0.9 A) from the INA181; 11 dB reads to about 3.1 V
    let isense = adc_cfg.enable_pin_with_cal::<_, AdcCalCurve<ADC1<'static>>>(p.GPIO2, Attenuation::_11dB);
    static ADC: StaticCell<SharedAdc> = StaticCell::new();
    let adc = &*ADC.init(BlockingMutex::new(RefCell::new(Adc::new(p.ADC1, adc_cfg))));

    let io = Io {
        probes,
        ambient,
        fan,
        tach: PcntTach { unit, since: None },
        servo: PwmServo::new(servo, SERVO_PERIOD_US),
        servo_power: Output::new(p.GPIO21, Level::Low, out),
        fan_power: Output::new(p.GPIO11, Level::Low, out),
        // the shared open-drain fault line has its own pull-up on the board
        load_fault: Input::new(p.GPIO3, InputConfig::default().with_pull(Pull::None)),
        servo_current: ServoSense { adc, pin: isense },
        led: Output::new(p.GPIO10, Level::Low, out),
        button: Input::new(p.GPIO9, InputConfig::default().with_pull(Pull::Up)),
        config: FlashRegion::new::<CONFIG_OFFSET, CONFIG_LEN>(BlockingAsync::new(FlashStorage::new(p.FLASH))),
        usb: CcSense { adc, cc1, cc2 },
        // TIMG0 is the runtime's; TIMG1's watchdog resets the whole system
        watchdog: Mwdt(TimerGroup::new(p.TIMG1).wdt),
    };
    let rest = Rest {
        timg0: p.TIMG0,
        sw_interrupt: p.FROM_CPU_INTR0,
        usb: p.USB_DEVICE,
        wifi: p.WIFI,
        secure_element,
    };
    (io, rest)
}

/// The main watchdog of timer group 1: stage 0 resets the system (`Wdt::enable` sets that action).
pub struct Mwdt(Wdt<TIMG1<'static>>);

impl Watchdog for Mwdt {
    fn start(&mut self, timeout_ms: u32) {
        self.0
            .set_timeout(MwdtStage::Stage0, Duration::from_millis(u64::from(timeout_ms)));
        self.0.enable();
        self.0.feed();
    }

    fn feed(&mut self) {
        self.0.feed();
    }
}

/// Fan tach on a pulse-counter unit: rising edges, glitch-filtered, read and cleared each call.
pub struct PcntTach {
    unit: &'static Unit<'static, 0>,
    /// Start of the current count; `None` until the first call.
    since: Option<Instant>,
}

impl Tach for PcntTach {
    fn rpm(&mut self) -> Option<f64> {
        let now = Instant::now();
        let pulses = f64::from(self.unit.value());
        self.unit.clear();
        let s = (now - self.since.replace(now)?).as_micros() as f64 * 1e-6;
        (s > 0.0).then(|| pulses / TACH_PULSES_PER_REV / s * 60.0)
    }
}

type CcPin<P> = AdcPin<P, ADC1<'static>, AdcCalCurve<ADC1<'static>>>;
type SharedAdc = BlockingMutex<CriticalSectionRawMutex, RefCell<Adc<'static, ADC1<'static>, esp_hal::Blocking>>>;

/// One calibrated conversion, mV (0 if the converter fails, which it does not once configured).
fn read_mv<P: esp_hal::analog::adc::AdcChannel>(adc: &SharedAdc, pin: &mut CcPin<P>) -> u16 {
    adc.lock(|a| nb::block!(a.borrow_mut().read_oneshot(pin)).unwrap_or(0))
}

/// CC1/CC2 voltages across the 5.1k Rd pull-downs.
pub struct CcSense {
    adc: &'static SharedAdc,
    cc1: CcPin<GPIO0<'static>>,
    cc2: CcPin<GPIO1<'static>>,
}

impl UsbPower for CcSense {
    fn source_current_ma(&mut self) -> Option<u16> {
        let cc1 = read_mv(self.adc, &mut self.cc1);
        let cc2 = read_mv(self.adc, &mut self.cc2);
        usb_cc::source_current_ma(cc1, cc2)
    }
}

/// Conversions averaged per servo current reading: the amplifier's 1.6 kHz filter leaves the servo's 50 Hz pulse
/// current on it, so one conversion is a sample of a ripple, not the mean.
const ISENSE_READS: u32 = 8;

/// The servo's supply current: the INA181's output across the shunt (2 mV per mA).
pub struct ServoSense {
    adc: &'static SharedAdc,
    pin: CcPin<GPIO2<'static>>,
}

impl ServoCurrent for ServoSense {
    fn ma(&mut self) -> u16 {
        let sum: u32 = (0..ISENSE_READS)
            .map(|_| u32::from(read_mv(self.adc, &mut self.pin)))
            .sum();
        servo_sense::ma_from_mv((sum / ISENSE_READS) as u16)
    }
}
