NathanHowell/minimeater/fw/minimeater-app/src/tasks.rs

//! The application's tasks, generic over the [`Board`]: the ESP32-C6 binary and the host twin
//! (`.4.16.2`) wrap each in a thin `#[embassy_executor::task]` and run the same code.
//!
//! - [`control`]: every [`PERIOD_S`], probes in, [`Pit::step`] and [`Foods::step`], the actuation
//!   out to [`actuators`], status and events onto the [`Bus`], settings to flash.
//! - [`actuators`]: every second, the fan (duty-cycled below its minimum speed, [`FanCycler`]; duty
//!   curve and stall watch from the tach) and the damper servo (calibration, slew limit, powered
//!   only while it moves), all in [`crate::drive`].
//! - [`slow`]: what is too slow for the control period, an autotune fit or an airflow-map rebuild,
//!   handed over through the [`Bus`]. On the C6 it belongs on a lower-priority executor (`.4.24`).
//!
//! - [`probes`]: the ADC round robin, averaging and filtering ([`crate::probes`]), publishing the
//!   latest [`Snapshot`] on the [`Bus`] for [`control`] to read each period.
//!
//! The control task also arms the hardware watchdog (30 s, [`WATCHDOG_MS`]) and feeds it each period and after each
//! request, while the actuator task is still running: a hang resets the board into the saved cook.
//!
//! The servo calibration and fan curve are defaults until the parts are chosen (`.2.9`, `.2.2`).

use core::cell::{Cell, RefCell};

use embassy_futures::select::{Either, select};
use embassy_sync::blocking_mutex::Mutex;
use embassy_sync::blocking_mutex::raw::CriticalSectionRawMutex;
use embassy_sync::channel::Channel;
use embassy_sync::mutex::Mutex as AsyncMutex;
use embassy_sync::pubsub::PubSubChannel;
use embassy_sync::signal::Signal;
use embassy_sync::watch::Watch;
use embassy_time::{Duration, Instant, Ticker, Timer};
use embedded_hal::digital::{InputPin, OutputPin};
use embedded_hal::pwm::SetDutyCycle;
use log::warn;
use minimeater_core::control::autotune::{Due, Fit, Identifier};
use minimeater_core::food::Food;
use minimeater_core::model::Ambient;
use minimeater_core::model::actuator::{FanCycler, flap_angle_deg};
use minimeater_core::model::airflow::{Actuation, AirPath, AirflowMap};
use minimeater_core::units::{c_to_k, k_to_f};

use crate::alarms::{Alarms, Limit};
use crate::ambient::{PLAUSIBLE_C, compensate};
use crate::config::{ConfigStore, Cook, Mode, ProbeKind, SERVO_US, ServoPulses, Settings, Stop};
use crate::drive::{
    FanCurve, FanDrive, HomeFail, Homing, LoadWatch, MoveMa, ServoCal, ServoDrive, ServoWatch, SupplyWatch, TachWatch,
};
use crate::food::{Foods, StallResponder};
use crate::hal::{AmbientSensor, Board, PROBE_JACKS, Servo, ServoCurrent, Tach, UsbPower, Watchdog};
use crate::pit::{Command, Event, FaultCode, Output, PERIOD_S, Phase, Pit, Reject};
use crate::probes::{self, ProbeSt, Reading, Scanner, Sense, Snapshot};
use crate::proto::BootReason;
use crate::proto::request::{Error, ErrorCode, ProbeChange, Request};

pub(crate) type M = CriticalSectionRawMutex;

/// How many tasks can read the status, events and replies: the MQTT client, OTLP, and one more
/// (the twin's harness).
pub const READERS: usize = 3;

/// Board temperature (the ADC's die, or the ambient sensor on the underside) that raises `board_hot`, and the temperature it must fall to to clear, C.
const BOARD_HOT_C: (f64, f64) = (80.0, 75.0);
/// The scanner starts a pass at least this often, ms (ADR 0002: four jacks at 0.4 s each). A pass
/// on the real ADC takes longer, so it runs back to back there.
const PASS_MS: u64 = 1600;
/// The hardware watchdog's timeout, ms: three control periods. The control task feeds it once a period and after each
/// request, and only while the actuator task is still running; a flash write or one solve of a fit is well inside.
const WATCHDOG_MS: u32 = 30_000;

/// A request and the id its reply will carry.
#[derive(Clone, Debug)]
pub struct Inbound {
    pub id: u16,
    pub req: Request,
}

#[derive(Clone, Debug)]
pub struct Reply {
    pub id: u16,
    pub result: Result<(), Error>,
}

/// `autotune` in the state (docs/protocol.md).
#[derive(Clone, Copy, Debug, Default, PartialEq)]
pub struct AutotuneInfo {
    /// The setpoint dither is running.
    pub exciting: bool,
    /// Fits taken into the model since boot.
    pub accepted: u32,
    /// How full the data window is, 0..1.
    pub window: f64,
}

/// A set of [`FaultCode`]s.
#[derive(Clone, Copy, Debug, Default, PartialEq, Eq)]
pub struct Faults(u16);

impl Faults {
    fn bit(code: FaultCode) -> u16 {
        1 << FaultCode::ALL.iter().position(|c| *c == code).unwrap_or(0)
    }

    pub fn contains(self, code: FaultCode) -> bool {
        self.0 & Self::bit(code) != 0
    }

    /// Sets or clears `code`; true if that changed it.
    pub fn set(&mut self, code: FaultCode, on: bool) -> bool {
        let was = self.contains(code);
        if on {
            self.0 |= Self::bit(code);
        } else {
            self.0 &= !Self::bit(code);
        }
        was != on
    }

    pub fn iter(self) -> impl Iterator<Item = FaultCode> {
        FaultCode::ALL.into_iter().filter(move |c| self.contains(*c))
    }
}

/// The latest status, for `~/state` (`.5.2`) and the twin's display.
#[derive(Clone, Copy, Debug)]
pub struct Status {
    pub up_s: u64,
    pub cook: Cook,
    pub out: Output,
    /// Each jack, F with offset: `None` unless the probe is `ok` or `disagree`.
    pub temps: [Option<f64>; PROBE_JACKS],
    /// The pit reading the loop controls on: the pit probe, or while `pit_probe: auto` is still looking, the hottest probe.
    pub pit_f: Option<f64>,
    pub probe_st: [ProbeSt; PROBE_JACKS],
    /// Each probe's alarm (`probes[n].alarm`), latched.
    pub alarms: [Option<Limit>; PROBE_JACKS],
    /// An alarm is on that `alarm_ack` has not silenced: the LED shows it.
    pub alarm_led: bool,
    /// ADC die temperature, C.
    pub adc_die_c: Option<f64>,
    /// Fan tachometer, rpm.
    pub fan_rpm: Option<f64>,
    /// The servo's current over its last move (`out.servo_ma`); `None` until the first.
    pub servo_ma: Option<MoveMa>,
    /// Active faults (`faults`, docs/protocol.md): a bit per [`FaultCode`].
    pub faults: Faults,
    pub autotune: AutotuneInfo,
    pub foods: [Option<Food>; PROBE_JACKS],
    pub ambient_c: Option<f64>,
}

#[allow(clippy::large_enum_variant, reason = "one static slot on the bus, no alloc")]
/// The slow task's work: the window to fit and the map to rebuild sit on the [`Bench`], so a job and its
/// result are tags, not 3-7 KB values copied through both tasks' stacks.
enum Job {
    Fit(Due),
    Map(AirPath, Ambient),
}

enum Done {
    Fit(Due, Option<Fit>),
    Map,
}

/// What the slow task works on. The control task fills or swaps it only while no job is out, so its lock
/// is always free when control takes it.
struct Bench {
    /// A copy of the autotune window being fitted.
    id: Identifier,
    /// The next airflow map, swapped with the pit's when built.
    map: AirflowMap,
}

/// The damper servo as the bring-up leaves it: what the actuator task drives with, and the REPL's jog and marks.
#[derive(Clone, Copy, Debug, Default, PartialEq, Eq)]
pub struct ServoCtl {
    /// The saved calibration; the nominal one when none.
    pub cal: Option<ServoPulses>,
    /// A pulse width, us, being held by hand: the flap law is off while it is set.
    pub jog: Option<u16>,
    /// The pulses marked so far this bring-up.
    pub closed_mark: Option<u16>,
    pub open_mark: Option<u16>,
    /// Where the hard-stop homing is.
    pub home: Home,
    /// How the last homing run ended; cleared when one is asked for.
    pub last_home: Option<Result<ServoPulses, HomeFail>>,
}

/// The hard-stop homing run (`drive::Homing`), from the request to the actuator task finishing it.
#[derive(Clone, Copy, Debug, Default, PartialEq, Eq)]
pub enum Home {
    #[default]
    Idle,
    /// Asked for; the actuator task starts it when the supply is good.
    Wanted,
    Running,
}

impl ServoCtl {
    /// The bring-up state after a save, a clear or a let-go: the calibration given, no jog and no marks. The homing run is not
    /// part of it.
    fn reset(&mut self, cal: Option<ServoPulses>) {
        *self = ServoCtl {
            cal,
            home: self.home,
            last_home: self.last_home,
            ..ServoCtl::default()
        };
    }
}

/// Everything the tasks exchange. One static instance per board.
pub struct Bus {
    /// In: `~/set` and `~/cmd` once parsed ([`crate::proto::parse`]), or a twin scenario. Each is
    /// answered on `replies` with its id.
    pub commands: Channel<M, Inbound, 8>,
    /// The outcome of each request taken from `commands`. Every subscriber sees every reply and
    /// picks out the ids it sent; a subscriber that falls behind loses the oldest.
    pub replies: PubSubChannel<M, Reply, 8, READERS, 1>,
    /// Out: `~/event`. Control never waits on a subscriber: one that falls behind loses the oldest.
    pub events: PubSubChannel<M, Event, 16, READERS, 1>,
    /// The latest status, every control period: `~/state`, OTLP and the twin each take their own
    /// receiver (`bus.status.receiver()`).
    pub status: Watch<M, Status, READERS>,
    /// The scanner's latest pass, read (not consumed) by the control task.
    probes: Mutex<M, Cell<Snapshot>>,
    /// The settings as they are now, for `~/config`; `config_changed` fires when they move.
    config: Mutex<M, RefCell<Option<Settings>>>,
    /// A counter that moves whenever `~/config` should be published again.
    pub config_rev: Watch<M, u32, READERS>,
    /// `identify` and `reboot` requests, for the LED and the board.
    pub identify: Signal<M, ()>,
    pub reboot: Signal<M, ()>,
    /// The serial REPL's jobs for the task that owns the secure element, and its answers (`enrol`).
    pub enrol_job: Channel<M, crate::enrol::Job, 1>,
    /// The CA certificate as the REPL receives it (`mqtt ca add`), until `mqtt ca save` makes it the setting.
    pub ca_stage: Mutex<M, RefCell<crate::config::Ca>>,
    pub enrol_out: Channel<M, crate::enrol::Out, 4>,
    /// Why the device started, until the MQTT client has announced it (`boot` event). Set by the binary at start-up.
    pub boot: Mutex<M, Cell<Option<BootReason>>>,
    /// Hardware faults raised by any task, the fan's last tach reading and the servo's last move.
    faults: Mutex<M, Cell<Faults>>,
    fan_rpm: Mutex<M, Cell<Option<f64>>>,
    servo_ma: Mutex<M, Cell<Option<MoveMa>>>,
    servo: Mutex<M, Cell<ServoCtl>>,
    /// Counts the actuator task's passes, so the control task can tell it from a hung one.
    beat: Mutex<M, Cell<u32>>,
    act: Signal<M, Actuation>,
    job: Signal<M, Job>,
    done: Signal<M, Done>,
    bench: AsyncMutex<M, Bench>,
}

impl Default for Bus {
    fn default() -> Self {
        Self::new()
    }
}

impl Bus {
    pub const fn new() -> Self {
        Self {
            commands: Channel::new(),
            replies: PubSubChannel::new(),
            events: PubSubChannel::new(),
            status: Watch::new(),
            config: Mutex::new(RefCell::new(None)),
            config_rev: Watch::new(),
            identify: Signal::new(),
            reboot: Signal::new(),
            enrol_job: Channel::new(),
            ca_stage: Mutex::new(RefCell::new(crate::config::Ca::new())),
            enrol_out: Channel::new(),
            boot: Mutex::new(Cell::new(None)),
            probes: Mutex::new(Cell::new(Snapshot {
                passes: 0,
                sense: [Sense::Pending; PROBE_JACKS],
                die_c: None,
                offset: None,
            })),
            faults: Mutex::new(Cell::new(Faults(0))),
            fan_rpm: Mutex::new(Cell::new(None)),
            servo_ma: Mutex::new(Cell::new(None)),
            servo: Mutex::new(Cell::new(ServoCtl {
                cal: None,
                jog: None,
                closed_mark: None,
                open_mark: None,
                home: Home::Idle,
                last_home: None,
            })),
            beat: Mutex::new(Cell::new(0)),
            act: Signal::new(),
            job: Signal::new(),
            done: Signal::new(),
            bench: AsyncMutex::new(Bench {
                id: Identifier::DEFAULT,
                map: AirflowMap::EMPTY,
            }),
        }
    }

    /// Queues a request for the control task; false if the queue is full.
    pub fn send(&self, id: u16, req: Request) -> bool {
        self.commands.try_send(Inbound { id, req }).is_ok()
    }

    /// The current settings (`None` before the control task has started).
    pub fn config(&self) -> Option<Settings> {
        self.config.lock(|c| c.borrow().clone())
    }

    /// Publishes the settings for `~/config` and moves the revision readers wait on.
    pub fn publish_config(&self, settings: &Settings) {
        self.config.lock(|c| *c.borrow_mut() = Some(settings.clone()));
        let rev = self.config_rev.try_get().unwrap_or(0).wrapping_add(1);
        self.config_rev.sender().send(rev);
    }

    /// A cook has started: a jog is let go. A homing run, waiting or begun, goes on: it takes about 30 s, and a cook on an
    /// uncalibrated servo can push the flap against a post and trip the load switch (`minimeat-ixz`). The flap goes where
    /// the controller wants it once the run ends.
    fn end_bench(&self) {
        self.servo_with(|s| {
            s.jog = None;
        });
    }

    /// The servo calibration and jog as they are now.
    pub fn servo(&self) -> ServoCtl {
        self.servo.lock(Cell::get)
    }

    fn servo_with(&self, f: impl FnOnce(&mut ServoCtl)) {
        self.servo.lock(|c| {
            let mut s = c.get();
            f(&mut s);
            c.set(s);
        });
    }

    /// Raises or clears a fault; the `fault` and `fault_clear` events fire on the change only.
    fn fault(&self, code: FaultCode, on: bool) {
        let changed = self.faults.lock(|c| {
            let mut f = c.get();
            let changed = f.set(code, on);
            c.set(f);
            changed
        });
        if changed {
            self.emit(if on {
                Event::Fault(code)
            } else {
                Event::FaultClear(code)
            });
        }
    }

    fn snapshot(&self) -> Snapshot {
        self.probes.lock(Cell::get)
    }

    pub(crate) fn emit(&self, e: Event) {
        self.events.immediate_publisher().publish_immediate(e);
    }
}

/// Applies one request; true if it changed what `~/config` reports.
fn apply(req: Request, pit: &mut Pit, settings: &mut Settings, bus: &Bus) -> Result<bool, Error> {
    match req {
        Request::Pit(c) => {
            pit.command(c).map_err(|r| match r {
                Reject::OutOfRange => Error::new(ErrorCode::OutOfRange, "out of range"),
                Reject::NotAllowed => Error::new(ErrorCode::NotAllowed, "not allowed in this mode"),
            })?;
            if pit.cook().mode != Mode::Off {
                bus.end_bench();
            }
            Ok(!matches!(c, Command::Autotune | Command::AutotuneStop))
        }
        Request::Probe { n, change } => {
            let p = settings
                .probes
                .get_mut(n)
                .ok_or_else(|| Error::new(ErrorCode::Unknown, "no such probe"))?;
            match change {
                ProbeChange::Name(name) => p.name = name,
                ProbeChange::Kind(kind) => p.kind = kind,
                ProbeChange::KeepCustom => {
                    if !matches!(p.kind, ProbeKind::Custom(_)) {
                        return Err(Error::new(ErrorCode::NotAllowed, "send probe/<n>/coeffs first"));
                    }
                }
                ProbeChange::Offset(o) => p.offset_f = o,
                ProbeChange::Lo(l) => p.lo_f = l,
                ProbeChange::Hi(h) => p.hi_f = h,
                ProbeChange::Cut(c) => p.cut = c,
                ProbeChange::Stall(s) => p.stall = s,
                ProbeChange::Bump(b) => p.bump_f = b,
            }
            Ok(true)
        }
        Request::Wifi(w) => {
            let changed = settings.wifi != w;
            settings.wifi = w;
            Ok(changed)
        }
        Request::Mqtt(m) => {
            let changed = settings.mqtt != m;
            settings.mqtt = m;
            Ok(changed)
        }
        Request::MqttCaSave => {
            let ca = bus.ca_stage.lock(|c| c.borrow().clone());
            if !crate::drivers::cert::looks_like_certificate(&ca) {
                return Err(Error::new(ErrorCode::OutOfRange, "not a DER certificate"));
            }
            let changed = settings.mqtt_ca.as_ref() != Some(&ca);
            settings.mqtt_ca = Some(ca);
            Ok(changed)
        }
        Request::MqttCaClear => {
            let changed = settings.mqtt_ca.take().is_some();
            Ok(changed)
        }
        Request::Otlp(o) => {
            let changed = settings.otlp != o;
            settings.otlp = o;
            Ok(changed)
        }
        Request::ServoJog(us) => {
            if pit.cook().mode != Mode::Off {
                return Err(Error::new(ErrorCode::NotAllowed, "not while a cook is running"));
            }
            if !SERVO_US.contains(&us) {
                return Err(Error::new(ErrorCode::OutOfRange, "pulse out of range"));
            }
            bus.servo_with(|s| s.jog = Some(us));
            Ok(false)
        }
        Request::ServoMark(stop) => {
            let Some(us) = bus.servo().jog else {
                return Err(Error::new(ErrorCode::NotAllowed, "jog the servo there first"));
            };
            bus.servo_with(|s| match stop {
                Stop::Closed => s.closed_mark = Some(us),
                Stop::Open => s.open_mark = Some(us),
            });
            Ok(false)
        }
        Request::ServoSave => {
            let s = bus.servo();
            let (Some(closed_us), Some(open_us)) = (s.closed_mark, s.open_mark) else {
                return Err(Error::new(ErrorCode::NotAllowed, "mark both closed and open first"));
            };
            let pulses = ServoPulses { closed_us, open_us };
            if !pulses.valid() {
                return Err(Error::new(
                    ErrorCode::OutOfRange,
                    "closed and open are too close together",
                ));
            }
            let changed = settings.servo != Some(pulses);
            settings.servo = Some(pulses);
            bus.servo_with(|s| s.reset(Some(pulses)));
            Ok(changed)
        }
        Request::ServoClear => {
            let changed = settings.servo.take().is_some();
            bus.servo_with(|s| s.reset(None));
            Ok(changed)
        }
        Request::ServoDone => {
            bus.servo_with(|s| s.reset(s.cal));
            Ok(false)
        }
        Request::ServoHome => {
            if pit.cook().mode != Mode::Off {
                return Err(Error::new(ErrorCode::NotAllowed, "not while a cook is running"));
            }
            if bus.servo().home != Home::Idle {
                return Err(Error::new(ErrorCode::NotAllowed, "already homing"));
            }
            bus.servo_with(|s| {
                s.reset(s.cal);
                s.home = Home::Wanted;
                s.last_home = None;
            });
            Ok(false)
        }
        Request::ServoHomed(result) => {
            bus.servo_with(|s| {
                // a run the supply cut short goes again when it is back, unless a calibration was saved meanwhile
                s.home = if result == Err(HomeFail::Cancelled) && s.cal.is_none() {
                    Home::Wanted
                } else {
                    Home::Idle
                };
                s.last_home = Some(result);
            });
            bus.emit(Event::ServoHome(result));
            match result {
                Ok(p) => {
                    let changed = settings.servo != Some(p);
                    settings.servo = Some(p);
                    bus.servo_with(|s| s.cal = Some(p));
                    Ok(changed)
                }
                Err(_) => Ok(false),
            }
        }
        Request::Identify => {
            bus.identify.signal(());
            Ok(false)
        }
        Request::Reboot => {
            bus.reboot.signal(());
            Ok(false)
        }
        // `handle` does this one: it needs the store
        Request::Defaults => Ok(false),
    }
}

/// The probe scanner: passes back to back, at least [`PASS_MS`] apart.
pub async fn probes<B: Board>(adc: B::Probes, bus: &Bus) -> ! {
    let mut scanner = Scanner::new(adc);
    let mut tick = Ticker::every(Duration::from_millis(PASS_MS));
    loop {
        let snap = scanner.pass().await;
        bus.probes.lock(|c| c.set(snap));
        tick.next().await;
    }
}

/// The control loop. `pit` and `foods` are large: the caller gives them static storage.
pub async fn control<B: Board>(
    mut wdt: B::Watchdog,
    mut ambient: B::Ambient,
    mut store: ConfigStore<B::Config>,
    mut settings: Settings,
    pit: &mut Pit,
    foods: &mut Foods,
    bus: &Bus,
) -> ! {
    // armed here, after the boot's flash reads and the self-survey; a hang from now on resets the board into the saved cook
    wdt.start(WATCHDOG_MS);
    let mut beat = 0;
    // a unit with no calibration (new, or a record that failed its check) finds it against the hard stops, a resumed cook
    // too: about 30 s with the fan off beats a cook on pulses that may push the flap against a post (`minimeat-ixz`). A
    // calibrated unit never moves the flap to look.
    let home = settings.servo.is_none();
    bus.servo_with(|s| {
        s.cal = settings.servo;
        if home {
            s.home = Home::Wanted;
        }
    });
    // the first full scan before the first period
    while bus.snapshot().passes == 0 {
        Timer::after_millis(100).await;
    }
    let mut tick = Ticker::every(Duration::from_millis((PERIOD_S * 1000.0) as u64));
    let mut busy = false;
    // a cook in progress (power came back mid-cook) is not the time to question the probes
    let mut check = settings.cook.mode == Mode::Off;
    let mut disagree = [false; PROBE_JACKS];
    let mut alarms = Alarms::default();
    let mut responder = StallResponder::default();
    let mut last_pass = 0;
    // `~/config` goes out once at boot and again after every accepted change
    let mut republish = true;
    loop {
        // fed while the actuators (the fan and the flap) are still being driven; if they hang the board resets and
        // boots with both off
        let b = bus.beat.lock(Cell::get);
        if b != beat {
            beat = b;
            wdt.feed();
        } else {
            warn!("actuator task silent: watchdog not fed");
        }
        let raw_c = ambient.read_c().await.ok();
        // an implausible reading is no reading for the airflow plan; `board_hot` below still sees it
        let usable = raw_c.filter(|c| PLAUSIBLE_C.contains(c));
        bus.fault(FaultCode::Ambient, usable.is_none());
        // a scanner that has stopped is an ADC that is not answering
        let snap = bus.snapshot();
        // the sensor is on the board and reads some of its heat
        let ambient_c = usable.map(|c| compensate(c, snap.die_c));
        let ambient_f = ambient_c.map(|c| k_to_f(c_to_k(c)));
        let sense = if snap.passes == last_pass {
            [Sense::Fault; PROBE_JACKS]
        } else {
            snap.sense
        };
        last_pass = snap.passes;
        bus.fault(FaultCode::Adc, sense.iter().all(|s| matches!(s, Sense::Fault)));
        // the board's temperature is the hotter of the ADC's die and the ambient sensor on the underside
        if let Some(c) = snap.die_c.into_iter().chain(raw_c).reduce(f64::max) {
            let hot = bus.faults.lock(Cell::get).contains(FaultCode::BoardHot);
            bus.fault(FaultCode::BoardHot, c >= BOARD_HOT_C.0 || (hot && c > BOARD_HOT_C.1));
        }
        let read = |disagree: &[bool; PROBE_JACKS]| -> [Reading; PROBE_JACKS] {
            core::array::from_fn(|j| probes::reading(sense[j], &settings.probes[j], disagree[j]))
        };
        let mut readings = read(&disagree);
        if check {
            check = false;
            let results = probes::selfcheck(&readings, ambient_f);
            disagree = probes::disagreeing(&results);
            readings = read(&disagree);
            bus.emit(Event::SelfCheck { results });
        }
        for (d, s) in disagree.iter_mut().zip(sense) {
            // unplugged: the verdict goes with the probe
            *d &= matches!(s, Sense::Probe(_));
        }
        let temps = readings.map(|r| r.temp_f);
        for e in alarms.step(&temps, &settings.probes) {
            bus.emit(e);
        }
        let amb = Ambient {
            t_k: c_to_k(ambient_c.unwrap_or(20.0)),
            ..Ambient::default()
        };
        // a jog left on when a cook starts would hold the flap shut on it
        if pit.cook().mode != Mode::Off {
            bus.end_bench();
        }
        // running on the nominal pulses with no homing to come
        let servo = bus.servo();
        bus.fault(FaultCode::ServoCal, servo.cal.is_none() && servo.home == Home::Idle);
        let (out, events) = pit.step_jacks(&temps, amb, PERIOD_S);
        bus.act.signal(out.act);
        for e in events {
            // a learned model is part of `~/config`
            republish |= matches!(e, Event::AutotuneDone { .. });
            bus.emit(*e);
        }
        // the jack auto found, or the one chosen; none while auto is still looking, when no jack can be told from the pit
        let jack = pit.cook().pit_jack();
        let looking = pit.searching();
        if !looking {
            let pit_f = jack.and_then(|j| temps[j]);
            for e in foods.step(&temps, jack, pit_f, out.phase, &settings.probes, PERIOD_S) {
                bus.emit(*e);
            }
            if let Some(e) = responder.step(foods, &temps, jack, &settings.probes, pit, PERIOD_S) {
                bus.emit(e);
            }
        }

        // slow work, one job at a time
        if let Some(d) = bus.done.try_take() {
            match d {
                Done::Fit(due, fit) => {
                    pit.fitted(due, fit);
                }
                Done::Map => pit.swap_map(&mut bus.bench.lock().await.map),
            }
            busy = false;
        }
        if !busy {
            if let Some((due, id)) = pit.take_fit() {
                bus.bench.lock().await.id.copy_from(id);
                bus.job.signal(Job::Fit(due));
                busy = true;
            } else if let Some((path, amb)) = pit.map_wanted() {
                bus.job.signal(Job::Map(path, amb));
                busy = true;
            }
        }

        // best effort: control never depends on the flash
        pit.persist(&mut settings);
        if republish {
            republish = false;
            bus.publish_config(&settings);
        }
        let _ = store.save(&settings).await;

        bus.status.sender().send(Status {
            up_s: Instant::now().as_secs(),
            cook: *pit.cook(),
            out,
            temps,
            pit_f: pit.control_jack().and_then(|j| temps[j]),
            probe_st: readings.map(|r| r.st),
            alarms: alarms.active(),
            alarm_led: alarms.unacked(),
            adc_die_c: snap.die_c,
            fan_rpm: bus.fan_rpm.lock(Cell::get),
            servo_ma: bus.servo_ma.lock(Cell::get),
            autotune: AutotuneInfo {
                exciting: pit.autotune().status().exciting,
                accepted: pit.autotune().status().accepted,
                window: pit.autotune().window_fill(),
            },
            faults: {
                let mut f = bus.faults.lock(Cell::get);
                f.set(FaultCode::PitProbe, pit.probe_lost() && out.phase == Phase::Fault);
                f.set(FaultCode::PitMismatch, pit.mismatch().is_some());
                f
            },
            foods: core::array::from_fn(|j| foods.food(j, &temps, jack).filter(|_| !looking)),
            ambient_c,
        });
        // until the next period, requests are answered as they arrive
        loop {
            match select(tick.next(), bus.commands.receive()).await {
                Either::First(()) => break,
                Either::Second(r) => {
                    handle::<B>(r, pit, &mut settings, &mut store, &mut alarms, &mut check, bus).await;
                    // the flash write in a request can be slow; the period's feed is not enough after it
                    wdt.feed();
                }
            }
        }
    }
}

/// One request: applied now, answered, and if it changed a setting then saved and republished.
async fn handle<B: Board>(
    Inbound { id, req }: Inbound,
    pit: &mut Pit,
    settings: &mut Settings,
    store: &mut ConfigStore<B::Config>,
    alarms: &mut Alarms,
    check: &mut bool,
    bus: &Bus,
) {
    let result = match req {
        Request::Pit(Command::SelfCheck) => {
            *check = true;
            Ok(false)
        }
        Request::Pit(Command::AlarmAck) => {
            alarms.ack();
            Ok(false)
        }
        Request::Defaults => {
            *settings = Settings::default();
            pit.reset(settings);
            bus.servo_with(|s| s.reset(None));
            // saved here, not left to the next period: the reboot is half a second away
            let saved = store.save(settings).await;
            bus.publish_config(settings);
            // without the save a reboot would bring the old settings back: stay up on the defaults and say so
            if saved.is_ok() {
                bus.reboot.signal(());
            }
            saved
                .map(|()| false)
                .map_err(|_| Error::new(ErrorCode::NotAllowed, "could not save"))
        }
        req => apply(req, pit, settings, bus),
    };
    let result = match result {
        Ok(changed) => {
            if changed {
                // a setpoint set before a power cut must survive it: do not wait for the next period
                pit.persist(settings);
                let _ = store.save(settings).await;
                bus.publish_config(settings);
            }
            Ok(())
        }
        Err(e) => {
            warn!("request {id} rejected: {:?} {}", e.code, e.detail);
            Err(e)
        }
    };
    bus.replies
        .immediate_publisher()
        .publish_immediate(Reply { id, result });
}

/// The id the actuator task's own requests carry (`Request::ServoHomed`); Improv uses 0xFF10 and the REPL 0xFF11.
const HOME_ID: u16 = 0xFF12;

/// One homing run (`drive::Homing`, `minimeat-xdn`): the fan is held off so that the shared fault line is the servo's, the
/// servo is swept into each stop, and the stall is read on the line and in the servo's current. The load watch stays out
/// of it; the caller takes it back.
#[allow(clippy::too_many_arguments)]
async fn home<B: Board>(
    fan: &mut B::Fan,
    fan_power: &mut B::FanPower,
    servo: &mut B::Servo,
    power: &mut B::ServoPower,
    load_fault: &mut B::LoadFault,
    current: &mut B::ServoCurrent,
    usb: &mut B::Usb,
    bus: &Bus,
) -> Result<ServoPulses, HomeFail> {
    let _ = fan.set_duty_cycle(0);
    let _ = fan_power.set_low();
    bus.servo_with(|s| s.home = Home::Running);
    let mut homing = Homing::new();
    let sample = Duration::from_millis((Homing::DT * 1000.0) as u64 / u64::from(Homing::SAMPLES));
    let result = loop {
        // the control task's watchdog feed waits on this, and a run takes most of 30 s
        bus.beat.lock(|c| c.set(c.get().wrapping_add(1)));
        let source_ok = usb
            .source_current_ma()
            .is_some_and(|ma| ma >= crate::drive::SUPPLY_MIN_MA);
        if !source_ok {
            break Err(HomeFail::Cancelled);
        }
        // the line and the current are read all through the step, and show the pulse set the step before
        let (mut lows, mut ma) = (0, 0u32);
        for _ in 0..Homing::SAMPLES {
            lows += u8::from(load_fault.is_low().unwrap_or(false));
            ma += u32::from(current.ma());
            Timer::after(sample).await;
        }
        let (out, done) = homing.tick(lows, (ma / u32::from(Homing::SAMPLES)) as u16);
        servo.set_pulse_us(out.pulse_us);
        let _ = if out.power { power.set_high() } else { power.set_low() };
        if let Some(r) = done {
            break r;
        }
    };
    let _ = power.set_low();
    result
}

/// How often the actuator task reads the servo's current while it is powered.
const SERVO_SAMPLE: Duration = Duration::from_millis(100);

/// The actuators, every second: `s_min` is the fan's minimum continuous speed fraction and `rpm_max`
/// its speed at full duty.
#[allow(clippy::too_many_arguments)]
pub async fn actuators<B: Board>(
    mut fan: B::Fan,
    mut tach: B::Tach,
    mut servo: B::Servo,
    mut power: B::ServoPower,
    mut fan_power: B::FanPower,
    mut load_fault: B::LoadFault,
    mut servo_current: B::ServoCurrent,
    mut usb: B::Usb,
    s_min: f64,
    rpm_max: f64,
    bus: &Bus,
) -> ! {
    const DT: f64 = 1.0;
    let mut supply = SupplyWatch::default();
    let mut load = LoadWatch::default();
    let mut tick = Ticker::every(Duration::from_secs(1));
    let mut cycler = FanCycler::default();
    let mut fan_drive = FanDrive::new(FanCurve::LINEAR, None);
    let mut watch = TachWatch::default();
    let mut flap = ServoDrive::new(ServoCal::DEFAULT);
    let mut servo_watch = ServoWatch::default();
    // the servo's power and pulse as the step before left them, for the watch
    let (mut was_on, mut was_pulse) = (false, 0u16);
    let mut act = Actuation { damper: 0.0, fan: 0.0 };
    loop {
        bus.beat.lock(|c| c.set(c.get().wrapping_add(1)));
        if let Some(a) = bus.act.try_take() {
            act = a;
        }
        // the fan and the servo run on a 1.5 A source or not at all
        if let Some(raised) = supply.tick(usb.source_current_ma()) {
            bus.fault(FaultCode::Supply, raised);
        }
        let speed = cycler.tick(act.fan, s_min, DT);
        if load.tick(load_fault.is_low().unwrap_or(false)) {
            bus.fault(FaultCode::Load, true);
            // the line is shared: the servo's current says whether it was the servo
            if servo_watch.blame() {
                bus.fault(FaultCode::Servo, true);
            }
        }
        // both loads run only on a good source and until a load switch has tripped
        let live = supply.ok() && !load.tripped();
        if live && bus.servo().home == Home::Wanted {
            servo_watch.abandon();
            was_on = false;
            let result = home::<B>(
                &mut fan,
                &mut fan_power,
                &mut servo,
                &mut power,
                &mut load_fault,
                &mut servo_current,
                &mut usb,
                bus,
            )
            .await;
            // the control task saves what it found
            bus.commands
                .send(Inbound {
                    id: HOME_ID,
                    req: Request::ServoHomed(result),
                })
                .await;
            // the second-long steps resume from now, and the flap is driven to where the controller wants it
            tick = Ticker::every(Duration::from_secs(1));
            flap.forget();
            continue;
        }
        let duty = if live { fan_drive.duty(speed) } else { 0.0 };
        // the duty first, then the power; power off first when the duty is zero: 0 % really stops the fan
        let _ = if duty > 0.0 {
            fan_power.set_high()
        } else {
            fan_power.set_low()
        };
        let max = f64::from(fan.max_duty_cycle());
        let _ = fan.set_duty_cycle((duty * max) as u16);

        // pulse first, then power: a servo waking up goes straight to the new position
        let ctl = bus.servo();
        let cal = ctl.cal.map_or(ServoCal::DEFAULT, ServoCal::from);
        if flap.cal != cal {
            // a new calibration moves the pulse for the angle the flap is at: drive it there
            flap.cal = cal;
            flap.forget();
        }
        let (pulse_us, powered) = match ctl.jog {
            // held by hand (bring-up): the flap law is off, and where the flap is when it ends is not known
            Some(us) => {
                flap.forget();
                (us, true)
            }
            None => {
                // the flap is not where it was told while `servo` is raised: drive it there again now and then
                if !was_on && servo_watch.retry_due(DT) {
                    flap.forget();
                }
                let s = flap.tick(flap_angle_deg(act.damper), DT);
                (s.pulse_us, s.power)
            }
        };
        servo.set_pulse_us(pulse_us);
        let on = powered && live;
        let _ = if on { power.set_high() } else { power.set_low() };

        // a move is the servo powered by the flap law, until it is switched off; a jog is not one
        if ctl.jog.is_some() {
            servo_watch.abandon();
        } else if was_on && !on {
            if let Some(raised) = servo_watch.end() {
                bus.fault(FaultCode::Servo, raised);
            }
            bus.servo_ma.lock(|c| c.set(servo_watch.last()));
        }
        let watched = on && ctl.jog.is_none();
        let holding = was_on && pulse_us == was_pulse;
        (was_on, was_pulse) = (watched, pulse_us);
        if watched {
            // the current all through the second, while the servo moves and settles
            loop {
                match select(tick.next(), Timer::after(SERVO_SAMPLE)).await {
                    Either::First(()) => break,
                    Either::Second(()) => servo_watch.sample(servo_current.ma(), pulse_us, holding),
                }
            }
        } else {
            tick.next().await;
        }
        // the tach's mean over the second just run
        let rpm = tach.rpm();
        bus.fan_rpm.lock(|c| c.set(rpm));
        if let Some(stalled) = watch.tick(duty, rpm, rpm_max, DT) {
            bus.fault(FaultCode::FanStall, stalled);
        }
    }
}

/// Runs the slow jobs the control task hands over. They are stepwise (`fit_async`, `rebuild` yield after every
/// solve), so on the one cooperative executor they delay the other tasks by one solve at most.
pub async fn slow(bus: &Bus) -> ! {
    loop {
        // the bench's lock is let go before the result is signalled
        let done = match bus.job.wait().await {
            Job::Fit(due) => Done::Fit(due, bus.bench.lock().await.id.fit_async().await),
            Job::Map(path, amb) => {
                bus.bench.lock().await.map.rebuild(&path, amb).await;
                Done::Map
            }
        };
        bus.done.signal(done);
    }
}

#[cfg(test)]
mod tests {
    use minimeater_core::model::Ambient;
    use minimeater_core::model::airflow::AirPath;

    use super::*;

    #[test]
    fn the_staged_ca_becomes_the_setting_only_if_it_is_a_certificate() {
        let bus = Bus::new();
        let mut settings = Settings::default();
        let mut pit = Pit::new(&settings, AirPath::default(), Ambient::default());
        let mut go = |req| apply(req, &mut pit, &mut settings, &bus);

        // nothing staged
        assert_eq!(go(Request::MqttCaSave).unwrap_err().code, ErrorCode::OutOfRange);
        // not a certificate
        bus.ca_stage
            .lock(|c| c.borrow_mut().extend_from_slice(b"-----BEGIN").unwrap());
        assert!(go(Request::MqttCaSave).is_err());
        // a SEQUENCE of the length it says
        bus.ca_stage.lock(|c| {
            let mut c = c.borrow_mut();
            c.clear();
            c.extend_from_slice(&[0x30, 0x03, 1, 2, 3]).unwrap();
        });
        assert_eq!(go(Request::MqttCaSave), Ok(true));
        assert_eq!(go(Request::MqttCaSave), Ok(false), "the same again changes nothing");
        assert_eq!(go(Request::MqttCaClear), Ok(true));
        assert_eq!(go(Request::MqttCaClear), Ok(false));
        assert_eq!(settings.mqtt_ca, None);
    }
}

#[cfg(test)]
mod servo_tests {
    use minimeater_core::model::Ambient;
    use minimeater_core::model::airflow::AirPath;

    use super::*;

    #[test]
    fn bring_up_marks_both_stops_then_saves_a_valid_calibration() {
        let bus = Bus::new();
        let mut settings = Settings::default();
        let mut pit = Pit::new(&settings, AirPath::default(), Ambient::default());
        let mut go = |req| apply(req, &mut pit, &mut settings, &bus);

        // nothing is held, so there is nothing to mark
        assert_eq!(
            go(Request::ServoMark(Stop::Closed)).unwrap_err().code,
            ErrorCode::NotAllowed
        );
        assert_eq!(go(Request::ServoJog(499)).unwrap_err().code, ErrorCode::OutOfRange);
        assert_eq!(go(Request::ServoJog(2501)).unwrap_err().code, ErrorCode::OutOfRange);
        assert_eq!(go(Request::ServoJog(1100)), Ok(false));
        assert_eq!(bus.servo().jog, Some(1100));
        // one mark is not enough
        assert_eq!(go(Request::ServoMark(Stop::Closed)), Ok(false));
        assert_eq!(go(Request::ServoSave).unwrap_err().code, ErrorCode::NotAllowed);
        // two marks on the same pulse are a mistake, not a damper
        assert_eq!(go(Request::ServoMark(Stop::Open)), Ok(false));
        assert_eq!(go(Request::ServoSave).unwrap_err().code, ErrorCode::OutOfRange);
        assert_eq!(bus.servo().cal, None, "nothing was saved");
        assert_eq!(go(Request::ServoJog(1900)), Ok(false));
        assert_eq!(go(Request::ServoMark(Stop::Open)), Ok(false));
        assert_eq!(go(Request::ServoSave), Ok(true));
        let want = ServoPulses {
            closed_us: 1100,
            open_us: 1900,
        };
        assert_eq!(
            bus.servo(),
            ServoCtl {
                cal: Some(want),
                ..ServoCtl::default()
            }
        );
        // the same again changes nothing stored
        assert_eq!(go(Request::ServoJog(1100)), Ok(false));
        assert_eq!(go(Request::ServoMark(Stop::Closed)), Ok(false));
        assert_eq!(go(Request::ServoJog(1900)), Ok(false));
        assert_eq!(go(Request::ServoMark(Stop::Open)), Ok(false));
        assert_eq!(go(Request::ServoSave), Ok(false));
        // letting go keeps the calibration and drops the jog and the marks
        assert_eq!(go(Request::ServoJog(1500)), Ok(false));
        assert_eq!(go(Request::ServoDone), Ok(false));
        assert_eq!(
            bus.servo(),
            ServoCtl {
                cal: Some(want),
                ..ServoCtl::default()
            }
        );
        assert_eq!(go(Request::ServoClear), Ok(true));
        assert_eq!(go(Request::ServoClear), Ok(false));
        assert_eq!(bus.servo(), ServoCtl::default());
        assert_eq!(settings.servo, None);
    }

    #[test]
    fn a_servo_mounted_the_other_way_round_is_a_valid_calibration() {
        let bus = Bus::new();
        let mut settings = Settings::default();
        let mut pit = Pit::new(&settings, AirPath::default(), Ambient::default());
        let mut go = |req| apply(req, &mut pit, &mut settings, &bus);
        go(Request::ServoJog(1900)).unwrap();
        go(Request::ServoMark(Stop::Closed)).unwrap();
        go(Request::ServoJog(1100)).unwrap();
        go(Request::ServoMark(Stop::Open)).unwrap();
        assert_eq!(go(Request::ServoSave), Ok(true));
        assert_eq!(
            settings.servo,
            Some(ServoPulses {
                closed_us: 1900,
                open_us: 1100
            })
        );
    }

    #[test]
    fn no_jog_while_a_cook_is_running() {
        let bus = Bus::new();
        let mut settings = Settings::default();
        settings.cook.mode = Mode::Run;
        let mut pit = Pit::new(&settings, AirPath::default(), Ambient::default());
        let e = apply(Request::ServoJog(1500), &mut pit, &mut settings, &bus).unwrap_err();
        assert_eq!(e.code, ErrorCode::NotAllowed);
        assert_eq!(bus.servo().jog, None);
    }
}
