NathanHowell/minimeater/fw/minimeater-app/src/pit.rs

//! The control loop (`.4.14`): one call per control period turns the pit reading into an actuation,
//! with the mode/phase state machine, the supervisors (lid `.4.6`, fire `.4.19`), the learner
//! (`.4.4`) and the probe fail-safe around the pit controller.
//!
//! Plain synchronous code over plain values, so the host tests drive it against the plant model
//! exactly as the firmware does. The embassy task around it reads the probe pipeline (`.4.7`), calls
//! [`Pit::step`] every [`PERIOD_S`], hands the actuation to the drivers (`.4.8`), publishes the
//! status and [`Event`]s, and saves [`Pit::persist`] through the config store. Two jobs are too slow
//! for the control period and go to a low-priority task: the autotune fit ([`Pit::take_fit`] ->
//! [`Identifier::fit`] -> [`Pit::fitted`], ~1-3 s on the C6) and the airflow-map rebuild when the
//! ambient moves ([`Pit::map_wanted`] -> [`AirflowMap::rebuild`] -> [`Pit::swap_map`]).
//!
//! **Never lose the cook.** Everything that defines the cook (mode, setpoint, controller, autotune
//! dither, the learned schedule, the lid settings) is in [`Settings`], saved as it changes, and a
//! board that boots mid-cook carries on from it: the controller starts fresh on a hot egg the way it
//! approaches any setpoint (reference shaping from where the pit is now, so no overshoot), seeded
//! with the airflow that holds the pit where it is. A missing pit reading is ridden through for
//! [`PROBE_GRACE_S`] on the last command; after that the flap closes and the fan stops (a fire with
//! no air cannot run away), and control resumes the same way when the probe comes back.

use heapless::Vec;
use minimeater_core::control::autotune::{Autotune, Due, Fit, Identifier, scheduling_point};
use minimeater_core::control::{
    Feedforward, FfPi, Fire, FireObs, FireWatch, Fopdt, LidDetector, MismatchPolicy, MismatchWatch, Mpc, Obs,
    PitController, PitFinder, Schedule, Trip,
};
use minimeater_core::model::Ambient;
use minimeater_core::model::actuator::{flap_angle_deg, open_frac};
use minimeater_core::model::airflow::{Actuation, AirPath, AirflowMap, ModelFeedforward};
use minimeater_core::units::k_to_f;

use crate::alarms::Limit;
use crate::config::ServoPulses;
use crate::config::{ControllerKind, Cook, Lid, Mode, PitSel, Settings};
use crate::drive::HomeFail;
use crate::hal::PROBE_JACKS;
use crate::probes::Check;
use crate::proto::BootReason;

/// Control period, s.
pub const PERIOD_S: f64 = 10.0;
/// A pit reading missing for this long (counted in whole control periods) fails safe, s.
pub const PROBE_GRACE_S: f64 = 20.0;
/// Airflow at hold is averaged over this long (s) before it is trusted and saved as [`Cook::hold`];
/// the saved value moves only when the average drifts by more than `HOLD_MOVE` (relative, or
/// `HOLD_MOVE_CFM`), to spare the flash.
const HOLD_S: f64 = 600.0;
const HOLD_MOVE: f64 = 0.05;
const HOLD_MOVE_CFM: f64 = 0.03;
/// Setpoint limits (docs/protocol.md).
pub const SP_MIN_F: f64 = 150.0;
pub const SP_MAX_F: f64 = 325.0;

/// `phase` in the status (docs/protocol.md).
#[derive(Clone, Copy, Debug, PartialEq, Eq)]
pub enum Phase {
    Idle,
    Startup,
    Hold,
    Lid,
    Recover,
    Manual,
    Fault,
}

/// `fault`/`fault_clear` codes this loop raises.
#[derive(Clone, Copy, Debug, PartialEq, Eq)]
pub enum FaultCode {
    /// The selected pit probe isn't `ok` (raised by the pit loop).
    PitProbe,
    /// ADC die above 80C: the device keeps running and warns.
    BoardHot,
    /// Fan driven but the tach shows it not turning.
    FanStall,
    /// The probe ADC is not answering.
    Adc,
    /// The ambient sensor is not answering: feedforward falls back to 20C.
    Ambient,
    /// The USB-C source does not advertise 1.5 A: the fan and the servo stay off (ADR 0004).
    Supply,
    /// A load switch is limiting its current (a stalled servo, a jammed fan, a short): both loads are cut until reboot.
    Load,
    /// The damper servo's current is wrong on two moves running: high while it holds (jammed) or nothing on a move
    /// (unplugged). It only warns.
    Servo,
    /// The damper servo has no calibration and none is being found: homing failed (`servo_home` says why), so it
    /// runs on the nominal pulses, which may push the flap against a post. It only warns.
    ServoCal,
    /// The selected pit probe does not behave like one (`pit_mismatch`, ADR 0008): the fault says which way, and with
    /// the `stop` policy the flap closes and the fan stops until the cook ends.
    PitMismatch,
}

impl FaultCode {
    /// Wire name (`faults` and the `fault` event's `code`, docs/protocol.md).
    pub fn name(self) -> &'static str {
        match self {
            FaultCode::PitProbe => "pit_probe",
            FaultCode::BoardHot => "board_hot",
            FaultCode::FanStall => "fan_stall",
            FaultCode::Adc => "adc",
            FaultCode::Ambient => "ambient",
            FaultCode::Supply => "supply",
            FaultCode::Load => "load",
            FaultCode::Servo => "servo",
            FaultCode::ServoCal => "servo_cal",
            FaultCode::PitMismatch => "pit_mismatch",
        }
    }

    pub const ALL: [FaultCode; 10] = [
        FaultCode::PitProbe,
        FaultCode::BoardHot,
        FaultCode::FanStall,
        FaultCode::Adc,
        FaultCode::Ambient,
        FaultCode::Supply,
        FaultCode::Load,
        FaultCode::Servo,
        FaultCode::ServoCal,
        FaultCode::PitMismatch,
    ];
}

/// `~/event` (docs/protocol.md), the ones the control loop raises.
#[derive(Clone, Copy, Debug, PartialEq)]
pub enum Event {
    LidOpen {
        pit_f: f64,
    },
    LidClosed {
        pit_f: f64,
    },
    FireLow {
        pit_f: f64,
        q: f64,
    },
    FireOut {
        pit_f: f64,
        q: f64,
    },
    SetpointReached {
        sp_f: f64,
    },
    /// A food probe's stall began or ended (`.4.22`; raised by [`crate::food::Foods`]).
    StallStart {
        probe: u8,
        t_f: f64,
    },
    StallEnd {
        probe: u8,
        t_f: f64,
    },
    /// A probe whose policy is `wrap` has stalled: time to wrap the meat (`.4.23`).
    WrapReminder {
        probe: u8,
        t_f: f64,
    },
    /// The setpoint was raised for a stall (`probe`'s policy is `bump`), to `sp_f`; and put back.
    StallBump {
        probe: u8,
        sp_f: f64,
    },
    StallRestore {
        sp_f: f64,
    },
    /// The dither ended: the model at that setpoint now, and the fits taken during it.
    AutotuneDone {
        model: Fopdt,
        accepted: u32,
    },
    /// A probe crossed its limit, or came back inside it (`.4.12`).
    Alarm {
        probe: u8,
        which: Limit,
        t_f: f64,
    },
    AlarmClear {
        probe: u8,
        which: Limit,
        t_f: f64,
    },
    /// Every probe against ambient (power-up, or the `selfcheck` command).
    SelfCheck {
        results: [Check; PROBE_JACKS],
    },
    Fault(FaultCode),
    FaultClear(FaultCode),
    /// `pit_probe: auto` named the pit probe (ADR 0008).
    PitFound {
        probe: u8,
    },
    /// A homing run ended (`minimeat-xdn`): the pulses it found and saved, or why it found none.
    ServoHome(Result<ServoPulses, HomeFail>),
    /// The device started, and why: raised once per boot, when the MQTT session first comes up.
    Boot(BootReason),
}

impl Event {
    /// The `event_type` on the wire (docs/protocol.md).
    pub fn name(&self) -> &'static str {
        match self {
            Event::LidOpen { .. } => "lid_open",
            Event::LidClosed { .. } => "lid_closed",
            Event::FireLow { .. } => "fire_low",
            Event::FireOut { .. } => "fire_out",
            Event::SetpointReached { .. } => "setpoint_reached",
            Event::StallStart { .. } => "stall_start",
            Event::StallEnd { .. } => "stall_end",
            Event::WrapReminder { .. } => "wrap_reminder",
            Event::StallBump { .. } => "stall_bump",
            Event::StallRestore { .. } => "stall_restore",
            Event::AutotuneDone { .. } => "autotune_done",
            Event::Alarm { .. } => "alarm",
            Event::AlarmClear { .. } => "alarm_clear",
            Event::SelfCheck { .. } => "selfcheck",
            Event::Fault(_) => "fault",
            Event::FaultClear(_) => "fault_clear",
            Event::PitFound { .. } => "pit_found",
            Event::ServoHome(_) => "servo_home",
            Event::Boot(_) => "boot",
        }
    }
}

/// `~/set/...` and `~/cmd/...` that reach the control loop.
#[derive(Clone, Copy, Debug, PartialEq)]
pub enum Command {
    Mode(Mode),
    Sp(f64),
    Controller(ControllerKind),
    LidDetect(bool),
    LidBoost(f64),
    /// Manual outputs, %.
    ManualFlap(f64),
    ManualFan(f64),
    Autotune,
    AutotuneStop,
    ModelReset,
    /// Compare the probes against ambient; the control task handles it, since it owns the probes.
    SelfCheck,
    /// Silence the LED for the alarms active now (the control task owns the alarms).
    AlarmAck,
    /// The jack that holds the pit probe, or auto.
    PitProbe(PitSel),
    /// What a pit probe that does not behave like one brings about.
    PitMismatch(MismatchPolicy),
}

/// Why a command was rejected (`rejected` event `error`).
#[derive(Clone, Copy, Debug, PartialEq, Eq)]
pub enum Reject {
    OutOfRange,
    NotAllowed,
}

/// One period's result.
#[derive(Clone, Copy, Debug, PartialEq)]
pub struct Output {
    pub phase: Phase,
    /// Commanded airflow, CFM (`out.q`).
    pub q: f64,
    /// Flap open-area fraction and fan speed fraction, for the drivers (`.4.8`).
    pub act: Actuation,
    /// Flap position, % of travel (`out.flap`).
    pub flap_pct: f64,
    /// The reference the controller tracks (`ref`): the shaped approach, plus the autotune dither.
    pub ref_f: f64,
    pub lid: bool,
    pub fire: Fire,
}

pub type Events = Vec<Event, 8>;

const CLOSED: Actuation = Actuation { damper: 0.0, fan: 0.0 };

pub struct Pit {
    cook: Cook,
    lid: Lid,
    ctrl: PitController,
    learn: Autotune,
    watch: FireWatch,
    path: AirPath,
    map: AirflowMap,
    ambient: Ambient,
    /// The controller needs a fresh start (and a seed) before it next steps.
    fresh: bool,
    out: Output,
    lost_s: f64,
    faulted: bool,
    /// Finds the pit probe among the jacks (`pit_probe: auto`) and watches the one in use.
    finder: PitFinder<PROBE_JACKS>,
    mismatch: MismatchWatch,
    /// The `pit_mismatch` fault has been raised.
    mismatch_raised: bool,
    /// The jack auto just named, for the event.
    found: Option<u8>,
    /// The hottest jack the loop last controlled on while auto was still looking.
    provisional: Option<u8>,
    /// Seconds since boot, for the finder and the watch.
    clock_s: f64,
    was_open: bool,
    was_starting: bool,
    was_exciting: bool,
    accepted_at_start: u32,
    /// Time at hold, s, and the airflow averaged over it, CFM.
    hold_s: f64,
    hold_q: f64,
    due: Option<Due>,
    fitting: bool,
    events: Events,
}

impl Pit {
    /// Boot, from what the store loaded. Builds the airflow map (~1700 root solves): call it before
    /// the control loop starts. On the board the pit is [`Self::BLANK`] in a static, [`Self::load`]ed and
    /// [`Self::boot`]ed there, so its 16 KB never pass through the stack.
    pub fn new(s: &Settings, path: AirPath, ambient: Ambient) -> Self {
        let mut p = Self::BLANK;
        p.load(s, path, ambient);
        p.boot(s);
        p
    }

    /// A pit before [`Self::load`] and [`Self::boot`], built at compile time.
    pub const BLANK: Self = Self {
        cook: Cook::DEFAULT,
        lid: Lid::DEFAULT,
        ctrl: controller(Cook::DEFAULT.controller, Schedule::PLACEHOLDER, Lid::DEFAULT),
        learn: Autotune::DEFAULT,
        watch: FireWatch::DEFAULT,
        path: AirPath::DEFAULT,
        map: AirflowMap::EMPTY,
        ambient: Ambient::DEFAULT,
        fresh: true,
        out: Output {
            phase: Phase::Idle,
            q: 0.0,
            act: CLOSED,
            flap_pct: 0.0,
            ref_f: 0.0,
            lid: false,
            fire: Fire::Unknown,
        },
        lost_s: 0.0,
        faulted: false,
        finder: PitFinder::DEFAULT,
        mismatch: MismatchWatch::DEFAULT,
        mismatch_raised: false,
        found: None,
        provisional: None,
        clock_s: 0.0,
        was_open: false,
        was_starting: false,
        was_exciting: false,
        accepted_at_start: 0,
        hold_s: 0.0,
        hold_q: 0.0,
        due: None,
        fitting: false,
        events: Vec::new(),
    };

    /// Takes on what the store loaded: the cook, the lid settings and the controller with its schedule.
    pub fn load(&mut self, s: &Settings, path: AirPath, ambient: Ambient) {
        self.cook = s.cook;
        self.lid = s.lid;
        self.ctrl = controller(s.cook.controller, s.schedule.clone(), s.lid);
        self.path = path;
        self.ambient = ambient;
        self.out.ref_f = s.cook.sp_f;
        self.finder.reset();
        self.mismatch.reset();
    }

    /// Back to the defaults in `s` mid-run (the factory reset): the cook is off, the learned schedule gone, and the
    /// controller starts from scratch whenever a cook next begins.
    pub fn reset(&mut self, s: &Settings) {
        let (path, ambient) = (self.path, self.ambient);
        self.load(s, path, ambient);
        self.learn.stop();
        self.fresh = true;
    }

    /// Finishes [`Self::load`] in place: starts the learner if the cook asks for it and builds the airflow map.
    pub fn boot(&mut self, s: &Settings) {
        if s.cook.autotune && s.cook.mode == Mode::Run {
            self.learn.start();
        }
        self.was_exciting = self.learn.status().exciting;
        let (path, ambient) = (self.path, self.ambient);
        minimeater_core::numeric::finish(self.map.rebuild(&path, ambient));
    }

    pub fn cook(&self) -> &Cook {
        &self.cook
    }

    pub fn schedule(&mut self) -> &Schedule {
        self.ctrl.schedule_mut()
    }

    pub fn autotune(&self) -> &Autotune {
        &self.learn
    }

    pub fn output(&self) -> &Output {
        &self.out
    }

    /// Copies what must survive a power cut into `s`, for the config store to save (it writes only
    /// what changed).
    pub fn persist(&mut self, s: &mut Settings) {
        s.cook = self.cook;
        s.lid = self.lid;
        if s.schedule != *self.ctrl.schedule_mut() {
            s.schedule = self.ctrl.schedule_mut().clone();
        }
    }

    pub fn command(&mut self, c: Command) -> Result<(), Reject> {
        match c {
            Command::Mode(m) => {
                if m != Mode::Run {
                    self.learn.stop();
                }
                if self.cook.mode == Mode::Off && m != Mode::Off {
                    // a cook starts from scratch; manual -> run is bumpless (the controller tracked)
                    self.fresh = true;
                    self.cook.hold = None;
                    // auto looks again: the pit probe may have moved since the last cook
                    self.restart_selection();
                }
                if m == Mode::Off {
                    self.clear_mismatch();
                }
                self.cook.mode = m;
            }
            Command::Sp(v) => {
                if !(SP_MIN_F..=SP_MAX_F).contains(&v) {
                    return Err(Reject::OutOfRange);
                }
                self.cook.sp_f = v;
                // the user's setpoint stands: a stall bump has nothing to go back to
                self.cook.base_sp = None;
            }
            Command::Controller(k) => {
                if k != self.cook.controller {
                    self.cook.controller = k;
                    let schedule = self.ctrl.schedule_mut().clone();
                    self.ctrl = controller(k, schedule, self.lid);
                    self.fresh = true;
                }
            }
            Command::LidDetect(on) => {
                self.lid.detect = on;
                apply_lid(&mut self.ctrl, self.lid);
            }
            Command::LidBoost(b) => {
                if !(1.0..=3.0).contains(&b) {
                    return Err(Reject::OutOfRange);
                }
                self.lid.boost = b;
                apply_lid(&mut self.ctrl, self.lid);
            }
            Command::ManualFlap(v) | Command::ManualFan(v) if !(0.0..=100.0).contains(&v) => {
                return Err(Reject::OutOfRange);
            }
            Command::ManualFlap(v) => self.cook.manual_flap = v,
            Command::ManualFan(v) => self.cook.manual_fan = v,
            Command::Autotune => {
                if self.cook.mode != Mode::Run {
                    return Err(Reject::NotAllowed);
                }
                self.learn.start();
            }
            Command::AutotuneStop => self.learn.stop(),
            Command::ModelReset => {
                *self.ctrl.schedule_mut() = Schedule::default();
            }
            // the control task owns the probes and alarms and answers these
            Command::SelfCheck | Command::AlarmAck => {}
            Command::PitProbe(sel) => {
                if matches!(sel, PitSel::Jack(j) if usize::from(j) >= PROBE_JACKS) {
                    return Err(Reject::OutOfRange);
                }
                self.cook.pit_probe = sel;
                self.restart_selection();
                self.fresh = true;
            }
            Command::PitMismatch(p) => {
                self.cook.pit_mismatch = p;
                if p == MismatchPolicy::Off {
                    self.clear_mismatch();
                }
            }
        }
        Ok(())
    }

    /// A stall bump (`.4.23`): raises the setpoint by `by_f`, capped at [`SP_MAX_F`], remembering
    /// where it was. A normal setpoint change, so the approach is shaped from where the pit is. The
    /// new setpoint, or `None` when it is already bumped or no higher can be had.
    pub fn bump(&mut self, by_f: f64) -> Option<f64> {
        if self.cook.base_sp.is_some() || self.cook.mode != Mode::Run {
            return None;
        }
        let to = (self.cook.sp_f + by_f).min(SP_MAX_F);
        if to <= self.cook.sp_f {
            return None;
        }
        self.cook.base_sp = Some(self.cook.sp_f);
        self.cook.sp_f = to;
        Some(to)
    }

    /// Undoes [`Pit::bump`]: the setpoint it was raised from, or `None` if it is not bumped.
    pub fn unbump(&mut self) -> Option<f64> {
        let base = self.cook.base_sp.take()?;
        self.cook.sp_f = base;
        Some(base)
    }

    /// The ambient has moved enough that the airflow map should be rebuilt (off the control path).
    pub fn map_wanted(&self) -> Option<(AirPath, Ambient)> {
        self.map.stale(&self.ambient).then_some((self.path, self.ambient))
    }

    /// Takes the freshly built `map` and leaves the old one in its place, for the next rebuild: the slow task's
    /// spare and this one trade places without a copy.
    pub fn swap_map(&mut self, map: &mut AirflowMap) {
        core::mem::swap(&mut self.map, map);
    }

    /// A window due for an autotune fit: copy the [`Identifier`] now (it moves on next period), fit
    /// it off the control path, and hand the result to [`Self::fitted`]. One fit at a time; a window
    /// that comes due while one is out is skipped (the next one is 5 min later).
    pub fn take_fit(&mut self) -> Option<(Due, &Identifier)> {
        let due = self.due.take()?;
        self.fitting = true;
        Some((due, self.learn.window()))
    }

    /// The result of a [`Self::take_fit`] job. Returns the schedule entry it changed, if any; the
    /// next [`Self::persist`] picks it up.
    pub fn fitted(&mut self, due: Due, fit: Option<Fit>) -> Option<Fopdt> {
        self.fitting = false;
        self.learn.apply(due, fit, self.ctrl.schedule_mut())
    }

    /// Forgets a locked pit probe and starts looking again (a new cook, or the selection changed).
    fn restart_selection(&mut self) {
        self.cook.pit_locked = None;
        self.provisional = None;
        self.finder.reset();
        self.mismatch.reset();
    }

    fn clear_mismatch(&mut self) {
        self.mismatch.reset();
    }

    /// What the mismatch watch has tripped on, until the cook ends or the selection changes.
    pub fn mismatch(&self) -> Option<Trip> {
        self.mismatch.tripped()
    }

    /// The jack whose reading the loop controls on: the pit probe, or while `auto` is still looking, the hottest probe.
    pub fn control_jack(&self) -> Option<usize> {
        self.cook
            .pit_jack()
            .or_else(|| self.searching().then_some(self.provisional).flatten().map(usize::from))
    }

    /// `pit_probe: auto` is running a cook and has not found the pit probe yet.
    pub fn searching(&self) -> bool {
        self.cook.mode == Mode::Run && self.cook.pit_probe == PitSel::Auto && self.cook.pit_locked.is_none()
    }

    /// The pit reading has been missing long enough to fail safe (`pit_probe` fault).
    pub fn probe_lost(&self) -> bool {
        self.faulted
    }

    /// The jack the loop controls on: the selected one, or the one auto has locked.
    fn select(&mut self, temps: &[Option<f64>; PROBE_JACKS], ambient: &Ambient) -> Option<usize> {
        if self.cook.mode == Mode::Run && self.cook.pit_probe == PitSel::Auto && self.cook.pit_locked.is_none() {
            let amb_f = k_to_f(ambient.t_k);
            if let Some(j) = self.finder.step(self.clock_s, amb_f, self.cook.sp_f, temps) {
                self.cook.pit_locked = Some(j as u8);
                self.found = Some(j as u8);
                if self.provisional != Some(j as u8) {
                    // the loop has been controlling on another jack: a fresh start on this one
                    self.mismatch.reset();
                    self.fresh = true;
                }
            }
        }
        self.cook.pit_jack()
    }

    /// One control period from every jack's reading (`None` unless `ok`): [`Self::step`] on the cook's pit probe, which
    /// `pit_probe: auto` finds first. Until it has, a running cook is controlled on the hottest probe, which is the pit
    /// probe once the fire is lit; with no probe reading at all it gets the model's airflow for the setpoint with no
    /// feedback (ADR 0008). Shutting the flap would starve the fire, and open loop alone lights it too slowly to be seen.
    pub fn step_jacks(&mut self, temps: &[Option<f64>; PROBE_JACKS], ambient: Ambient, dt: f64) -> (Output, &Events) {
        match self.select(temps, &ambient) {
            Some(j) => self.step_with(temps[j], false, ambient, dt),
            None if self.cook.mode == Mode::Run && self.cook.pit_probe == PitSel::Auto => {
                let hottest = (0..PROBE_JACKS)
                    .filter_map(|j| temps[j].map(|t| (t, j)))
                    .reduce(|a, b| if b.0 > a.0 { b } else { a });
                self.provisional = hottest.map(|(_, j)| j as u8);
                self.step_with(hottest.map(|(t, _)| t), hottest.is_none(), ambient, dt)
            }
            None => self.step_with(None, false, ambient, dt),
        }
    }

    /// One control period. `pit_f`: the selected pit probe, `None` unless its status is `ok`;
    /// `ambient`: the outside-air reading (or the 20C fallback). Returns this period's output and
    /// the events it raised.
    pub fn step(&mut self, pit_f: Option<f64>, ambient: Ambient, dt: f64) -> (Output, &Events) {
        self.step_with(pit_f, false, ambient, dt)
    }

    /// `open`: no pit probe is known yet, and `pit_f` is the hottest probe, if any.
    fn step_with(&mut self, pit_f: Option<f64>, open: bool, ambient: Ambient, dt: f64) -> (Output, &Events) {
        self.events.clear();
        if let Some(probe) = self.found.take() {
            self.emit(Event::PitFound { probe });
        }
        self.clock_s += dt;
        self.ambient = ambient;
        let pit = pit_f.filter(|y| y.is_finite());
        self.lost_s = if pit.is_some() || open { 0.0 } else { self.lost_s + dt };
        let faulted = self.lost_s >= PROBE_GRACE_S;
        if faulted != self.faulted {
            self.faulted = faulted;
            self.emit(if faulted {
                Event::Fault(FaultCode::PitProbe)
            } else {
                Event::FaultClear(FaultCode::PitProbe)
            });
        }

        let sp = self.cook.sp_f;
        // Ran: closed loop; Held: riding through a missing reading; otherwise not controlling
        let (mut ran, mut held) = (false, false);
        match (self.cook.mode, pit) {
            (Mode::Off, _) => {
                self.fresh = true;
                self.set(Phase::Idle, 0.0, CLOSED, sp);
            }
            (Mode::Manual, _) => {
                let act = Actuation {
                    damper: open_frac(self.cook.manual_flap / 100.0 * 90.0),
                    fan: self.cook.manual_fan / 100.0,
                };
                let y = pit.unwrap_or(sp);
                let q = self.map.airflow(y, act);
                match pit {
                    // keep the controller's estimate current, so the return to run is bumpless
                    Some(y) if !self.fresh => {
                        let (q_min, q_max) = self.map.limits(y);
                        let obs = Obs {
                            pit_f: y,
                            sp_f: sp,
                            lid: false,
                            q_min,
                            q_max,
                        };
                        let ff = ModelFeedforward {
                            path: &self.path,
                            ambient: self.ambient,
                        };
                        self.ctrl.track(&obs, &ff, q, dt);
                    }
                    Some(y) => self.start_controller(y, Some(q)),
                    None => self.fresh = true,
                }
                self.set(Phase::Manual, q, act, sp);
            }
            (Mode::Run, _) if open => {
                self.fresh = true;
                self.open_loop();
            }
            (Mode::Run, None) if faulted => {
                // fail safe: no air, no runaway
                self.fresh = true;
                self.set(Phase::Fault, 0.0, CLOSED, sp);
            }
            // a reading or two missing: ride through on the last command
            (Mode::Run, None) => held = true,
            (Mode::Run, Some(y)) => {
                // a fire the fire watch has called out is dead, not a probe in the wrong place
                let fan = self.out.act.fan > 0.0 && self.out.fire != Fire::Out;
                self.mismatch.step(self.cook.pit_mismatch, self.clock_s, y, sp, fan);
                if self.cook.pit_mismatch == MismatchPolicy::Stop && self.mismatch.tripped().is_some() {
                    // as a lost pit probe: no air, no runaway, until the cook ends
                    self.fresh = true;
                    self.set(Phase::Fault, 0.0, CLOSED, sp);
                } else {
                    if self.fresh {
                        self.start_controller(y, None);
                    }
                    self.run(y, dt);
                    ran = true;
                }
            }
        }

        if !ran {
            // not closed-loop plant data: restart the learning window, keep the fire watch's clock
            let obs = Obs {
                pit_f: f64::NAN,
                sp_f: sp,
                lid: false,
                q_min: 0.0,
                q_max: 0.0,
            };
            self.learn.sample(&obs, sp, self.out.q, false, dt);
            self.watch.update(
                &FireObs {
                    pit_f: f64::NAN,
                    sp_f: sp,
                    q: 0.0,
                    q_ff: 0.0,
                    q_max: 0.0,
                    expected_low: true,
                },
                dt,
            );
        }
        if !ran && !held {
            if self.out.lid {
                self.emit(Event::LidClosed {
                    pit_f: pit.unwrap_or(f64::NAN),
                });
            }
            self.out.lid = false;
            self.out.fire = Fire::Unknown;
            self.was_open = false;
            self.was_starting = false;
        }

        let exciting = self.learn.status().exciting;
        if exciting && !self.was_exciting {
            self.accepted_at_start = self.learn.status().accepted;
        }
        if self.was_exciting && !exciting {
            let at = scheduling_point(sp);
            let model = self.ctrl.schedule_mut().at(at);
            let accepted = self.learn.status().accepted - self.accepted_at_start;
            self.emit(Event::AutotuneDone { model, accepted });
        }
        self.was_exciting = exciting;
        self.cook.autotune = exciting;
        let tripped = self.mismatch.tripped().is_some();
        if tripped != self.mismatch_raised {
            self.mismatch_raised = tripped;
            self.emit(if tripped {
                Event::Fault(FaultCode::PitMismatch)
            } else {
                Event::FaultClear(FaultCode::PitMismatch)
            });
        }
        (self.out, &self.events)
    }

    /// The airflow the model says the setpoint needs, plus what [`Cook::hold`] says this egg needs over the model, with
    /// no feedback: no probe reads, so there is nothing to control on.
    fn open_loop(&mut self) {
        let sp = self.cook.sp_f;
        let y = k_to_f(self.ambient.t_k);
        let ff = self.ff();
        let trim = self.cook.hold.map_or(0.0, |(hsp, hq)| hq - ff.q_cfm(hsp));
        let q = (ff.q_cfm(sp) + trim).max(0.0);
        let act = self.map.actuate(y, q);
        self.set(Phase::Startup, q, act, sp);
    }

    fn ff(&self) -> ModelFeedforward<'_> {
        ModelFeedforward {
            path: &self.path,
            ambient: self.ambient,
        }
    }

    /// A fresh controller for a cook that may already be under way (boot, a probe back, a new
    /// controller): it approaches the setpoint from the pit's current temperature, starting from
    /// airflow `q` if given (manual mode), else from what [`Cook::hold`] says this egg needs.
    fn start_controller(&mut self, y: f64, q: Option<f64>) {
        let schedule = self.ctrl.schedule_mut().clone();
        self.ctrl = controller(self.cook.controller, schedule, self.lid);
        let ff = self.ff();
        let trim = match (q, self.cook.hold) {
            (Some(q), _) => q - ff.q_cfm(y.min(self.cook.sp_f)),
            (None, Some((sp, q))) => q - ff.q_cfm(sp),
            (None, None) => 0.0,
        };
        self.ctrl.resume(trim);
        self.fresh = false;
        self.hold_s = 0.0;
    }

    /// Averages the airflow while holding, and updates [`Cook::hold`] when it has moved.
    fn track_hold(&mut self, phase: Phase, q: f64, dt: f64) {
        if phase != Phase::Hold {
            self.hold_s = 0.0;
            return;
        }
        self.hold_q = if self.hold_s == 0.0 {
            q
        } else {
            self.hold_q + (q - self.hold_q) * (dt / HOLD_S).min(1.0)
        };
        self.hold_s += dt;
        if self.hold_s < HOLD_S {
            return;
        }
        let sp = self.cook.sp_f;
        let moved = match self.cook.hold {
            Some((at, q0)) => at != sp || (self.hold_q - q0).abs() > (HOLD_MOVE * q0).max(HOLD_MOVE_CFM),
            None => true,
        };
        if moved {
            self.cook.hold = Some((sp, self.hold_q));
        }
    }

    fn run(&mut self, y: f64, dt: f64) {
        let sp = self.cook.sp_f;
        let ref_sp = self.learn.reference(sp, dt);
        let (q_min, q_max) = self.map.limits(y);
        let obs = Obs {
            pit_f: y,
            sp_f: ref_sp,
            lid: false,
            q_min,
            q_max,
        };
        let ff = ModelFeedforward {
            path: &self.path,
            ambient: self.ambient,
        };
        let q = self.ctrl.step(&obs, &ff, dt);
        let q_ff = ff.q_cfm(sp);
        let act = self.map.actuate(y, q);

        let lid = self.ctrl.lid();
        let (open, recovering, starting) = (lid.open(), lid.active(), self.ctrl.starting());
        let phase = if open {
            Phase::Lid
        } else if recovering {
            Phase::Recover
        } else if starting {
            Phase::Startup
        } else {
            Phase::Hold
        };
        let fire = self.watch.update(
            &FireObs {
                pit_f: y,
                sp_f: sp,
                q,
                q_ff,
                q_max,
                expected_low: starting || recovering,
            },
            dt,
        );
        if let Some(due) = self.learn.sample(&obs, sp, q, !recovering, dt)
            && !self.fitting
        {
            self.due = Some(due);
        }

        if open != self.was_open {
            self.emit(if open {
                Event::LidOpen { pit_f: y }
            } else {
                Event::LidClosed { pit_f: y }
            });
        }
        if self.was_starting && !starting && !recovering {
            self.emit(Event::SetpointReached { sp_f: sp });
        }
        if fire != self.out.fire {
            match fire {
                Fire::Low => self.emit(Event::FireLow { pit_f: y, q }),
                Fire::Out => self.emit(Event::FireOut { pit_f: y, q }),
                _ => {}
            }
        }
        self.was_open = open;
        self.was_starting = starting;
        self.track_hold(phase, q, dt);
        self.set(phase, q, act, ref_sp);
        self.out.lid = open;
        self.out.fire = fire;
    }

    fn set(&mut self, phase: Phase, q: f64, act: Actuation, ref_f: f64) {
        self.out.phase = phase;
        self.out.q = q;
        self.out.act = act;
        self.out.flap_pct = flap_angle_deg(act.damper) / 90.0 * 100.0;
        self.out.ref_f = ref_f;
    }

    fn emit(&mut self, e: Event) {
        // eight per period is more than any period raises; a full queue drops the newest
        let _ = self.events.push(e);
    }
}

const fn controller(kind: ControllerKind, schedule: Schedule, lid: Lid) -> PitController {
    let mut c = match kind {
        ControllerKind::Mpc => PitController::Mpc(Mpc::new(schedule)),
        ControllerKind::FfPi => PitController::FfPi(FfPi::new(schedule)),
    };
    apply_lid(&mut c, lid);
    c
}

const fn apply_lid(c: &mut PitController, lid: Lid) {
    let r = c.lid_mut();
    r.boost = lid.boost;
    match (lid.detect, r.detector.is_some()) {
        (true, false) => r.detector = Some(LidDetector::DEFAULT),
        (false, true) => r.detector = None,
        _ => {}
    }
}
