NathanHowell/minimeater/(commit log)

2026-10-11 Add BGE Large airflow/thermal model and controller bake-off
    Python model of a Big Green Egg Large fed through a 1.375" stainless
    intake tube: steady-state heat balance, 1D pressure-drop path with
    stack draft, candidate fan curves, and a closed-loop plant simulation.
    Controller comparison (HeaterMeter-style PI vs feedforward+PI vs
    airflow-commanded MPC with system-ID autotune) across 150-325F
    scenarios and an egg parameter band. Generated reports live in
    docs/modeling/ (uv run minimeat-model / minimeat-control).
2026-10-11 Add probe front-end and MCU ADRs with error-budget model
    - ADR 0001: ESP32-C6-WROOM-1-N8 (native USB-Serial-JTAG, stable RISC-V Rust, Thread)
    - ADR 0002: ratiometric ADS1220, 47k 0.1% bias, TMP117 ambient, MAX31856 DNP
    - probes.py error budget + minimeat-probes report (docs/modeling/probes.md)
    - scripts/jlc_stock.py: JLCPCB stock lookup; all chosen parts in stock
2026-10-11 MQTT schema v1: topics, payloads, commands and HA device discovery
2026-10-11 Firmware workspace: minimeat-core (thermistor, units) and ESP32-C6 embassy binary
2026-10-11 Actuator inversion in minimeat-core: airflow/thermal model port, AirflowMap, model feedforward, flap angle, fan cycler
2026-10-11 minimeat-sim: BGE plant model (Python parity) with fuel burnout, fire die-back and brisket stall
    [food.rs, lib.rs, plant_parity.rs, plausibility.rs, rng.rs]
2026-10-11 Document dimensions of the existing HeaterMeter tube adapter (from STL)
2026-10-11 Peripheral boundary: minimeat-app over HAL traits, esp-hal board bindings, plant-backed sim board
    minimeat-app holds the application generic over hal::Board (probe ADC, ambient,
    fan PWM, tach, servo, servo power gate, LED, button, config NorFlash, USB-C
    source) plus ADS1220/TMP117/USB-CC drivers on embedded-hal-async, host-tested
    with scripted buses. minimeat-fw/board.rs binds them to esp-hal on a
    provisional DevKitC-1 pin map; minimeat-sim::hal implements them on the plant
    (World). selftest::survey runs on both.
    [ads1220.rs, board.rs, hal.rs, lib.rs, main.rs, mock.rs, mod.rs, selftest.rs]
2026-10-11 Light-off overshoot test across the egg uncertainty band (Rust plant + core controllers)
    MPC with the nominal (pre-autotune) schedule: worst 7.6F at 225F, 4.0F at
    150F, 11.7F at 325F on the high-loss egg. Adds uncertainty_band() to
    minimeat-sim, mirroring params.uncertainty_band.
    [lib.rs, light_off.rs]
2026-10-11 Autotune that never fails: closed-loop output-error identification with setpoint dither
    The MPC stays in charge throughout. Autotune fits an FOPDT (plus drift) by
    variable projection on a sliding 60 min window of applied airflow and pit,
    accepts only settled, well-excited, low-residual windows, and blends accepted
    fits into the schedule (running mean, bounded ratio per update). The autotune
    command only adds a +/-3F setpoint dither and stops by itself; lid, recovery
    and probe faults restart the window. No abort or failure outcome.
    MPC: gain changes from schedule updates re-anchor the disturbance estimate
    (bumpless); track() keeps the estimator consistent under external commands.
    Schedule ga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
    [autotune.rs, mod.rs]
2026-10-11 Persistent configuration: power-fail-safe settings store that never fails to load
    minimeat-app::config keeps the cook in progress (mode, setpoint, controller,
    pit jack, autotune excitation), the learned schedule, lid settings, probe
    setup and network credentials in the config flash region via
    sequential-storage's map. Each record is versioned by key, validated on
    load and falls back to its default on its own; an unreadable store is erased
    and the device boots from defaults. Unchanged records are not rewritten.
    Sim tests: survive reboot, invalid record isolation, garbage flash, and a
    power cut at 386 points of a save (157 during garbage collection) leaving
    every record at its old or new valu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
    [config.rs, lib.rs, main.rs, mod.rs]
2026-10-11 Lid-open detection from the pit probe, with rollback to the pre-drop controller state
    The detector opens on a 10F fall at 0.3F/s or faster, and closes when the pit
    reheats (gap-normalised rate), turns back up within 90 s of detection, relapses
    after a starved rise, or after 15 min. The controller output stays off while
    open, as before. On detection the MPC disturbance estimate / PI integral and the
    replayed airflow roll back to the last sample before the drop.
    Simulation (3 setpoints x uncertainty band x 20-300 s lids x MPC/FF+PI): caught
    within 30 s, released within 120 s, never released with the lid up, overshoot
    within 1F of an oracle lid flag, and no false detections across light-off,
    s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
    [lid.rs, mod.rs]
2026-10-11 Control loop: mode/phase state machine, probe fail-safe and power-cut resume around the pit controller
    minimeat-app::pit::Pit runs one control period from the pit reading: lid and fire supervisors,
    autotune with the fit taken off the control path (Autotune::sample/apply), events, and the
    settings to persist. A power cut resumes the cook from flash; the airflow that held the pit is
    saved (Cook::hold) and seeds the fresh controller, so it does not relearn the egg. A pit probe
    missing for 20 s closes the flap and stops the fan. Tested on the plant across the band: resume
    peaks at 3.2F (MPC) for cuts of 10 s to 1 h, probe pulls fail safe in 20 s, manual -> run is
    bumpless, and autotune survives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
    [autotune.rs, config.rs, lib.rs, main.rs, mod.rs]
2026-10-11 Food estimator: heating rate, stall detection and ETA per food probe
    The core's rise per degree of gap to the pit is a constant of a dry cut, sinks through the ramp
    as the surface evaporates, and recovers over ~3 h once the bark seals. The estimator learns the
    dry ratio on the ramp, calls the stall when the core rises under 5F/h while well short of that
    ratio, and forecasts the finish with the ratio recovering. Lid openings are masked out of the
    rate. Cut presets set priors and the default target; probes get a food status, a cut setting and
    stall_start/stall_end events. On the plant model: stalls detected within 27 min, ETA within 0.5 h
    of the finish from the end of the stall, no false stall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
    [config.rs, food.rs, lib.rs, mod.rs, pit.rs]
2026-10-11 Host digital twin: the app's tasks on a virtual clock against the simulated board
    minimeat-app::tasks holds the application's tasks, generic over the board: control (probes,
    pit loop, food estimators, settings to flash), actuators (fan cycling, servo powered only while
    moving) and slow work (autotune fits, airflow-map rebuilds), talking over a Bus of commands,
    events and status. minimeat-twin runs them unchanged on an embassy executor whose time driver is
    a virtual clock: the main loop steps the plant to the next timer wake and jumps the clock, so an
    18 h brisket cook runs in about a second, or paced (just twin --speed 60x).
    The first run found a stall that set in slowly ending after 17 min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
    [clock.rs, food.rs, kamado_brisket.rs, lib.rs, main.rs, scenario.rs, tasks.rs]
2026-10-11 Probe pipeline: round-robin scanner with trimmed-mean averaging and IIR, probe status, ambient self-check
2026-10-11 Actuator drivers: servo calibration, slew and power gating, fan curve and tach stall fault; hardware faults on the status
    [actuators.rs, drive.rs, hal.rs, lib.rs, pit.rs, scenario.rs, tasks.rs]
2026-10-11 Fault injection in the sim peripherals, with twin scenarios for ADC loss, noise and spikes, ambient NACK, stuck servo and flash failure; spike-proof probe scanner
    [actuators.rs, fault_adc.rs, fault_flash.rs, fault_noise.rs, fault_servo.rs, hal.rs, probes.rs, scenario.rs]
2026-10-11 Probe alarms: latched lo/hi limits with hysteresis, events and acknowledge
2026-10-12 Home Assistant discovery: device message with every entity, tested against the codec and the published state and config
2026-10-12 MQTT 5 client: packet codec and session (Last Will, retained/QoS1 publishing, command intake with response topics, reconnect), tested on the twin's in-process broker
    [events.rs, lib.rs, mod.rs, mqtt.rs, net.rs, scenario.rs]
2026-10-12 MQTT session republishes discovery when a probe is renamed
2026-10-12 OTLP metrics export: protobuf encoder, HTTP exporter, stored setting, tested against a real collector
2026-10-12 Stall response policy per food probe: notify, wrap reminder, or setpoint bump that is put back when the stall breaks
    [config.rs, discovery.rs, events.rs, food.rs, pit.rs, proto.rs, request.rs]
2026-10-12 Enclosure v0 in build123d: duct, flap, tube coupling, electronics tray and lid, with fit, leak and overhang checks
    [analysis.py, envelope.py, geom.py, params.py]
2026-10-12 Exterior shell: tapered hood and pan around the enclosure, Hitec HS-5065MG servo, rear connector panel and grille
2026-10-12 ADR 0004: USB-C power architecture, 5V only with CC source detection and gated servo and fan
2026-10-12 CI recipes (just ci) and a GitHub Actions workflow; fan and servo headers as hand-soldered Molex KK
2026-10-12 Probe ADC on I2C: ADS122C04 driver replaces the ADS1220 SPI driver; one shared bus, five pins freed, pin budget justified
    [ads122c04.rs, board.rs, hal.rs, mock.rs, mod.rs]
2026-10-12 Low pebble enclosure: horizontal board in the pan, servo beside the duct with a parallelogram linkage, smooth two-tone hood and pan, side port bay, rain details
2026-10-12 ADR 0005: ATECC608B secure element for device identity; part list and ICD
2026-10-12 ATECC608B driver: wake, Info, serial and lock state, Random, GenKey, Nonce+Sign, tested against a chip model; I2C bus at 100 kHz for the wake pulse
2026-10-12 KiCad project scaffold: 4-layer board, JLCPCB rules, 44x54 outline and mounting holes from the enclosure envelope
    [minimeat.kicad_pcb, minimeat.kicad_sch]
2026-10-12 Schematic: USB-C input, ESD, PTC and TVS, 3.3 V buck, analog LDO, servo and fan load switches (ERC 0 errors)
    [minimeat.kicad_sch]
2026-10-12 Enclosure: status LED light pipe and button plunger on the board's +y edge through the pan flank; side-view LED and side-actuated button replace the top-facing parts
    [envelope.py, params.py, shell.py]
2026-10-12 Schematic: ESP32-C6-WROOM-1 block (Espressif symbol and footprint vendored), pin assignment from the schematic, board.rs pin map follows
    [minimeat.kicad_sch]
2026-10-12 Schematic: ADS122C04 probe front-end, four PJ-242 jacks (footprint from the maker's drawing), TMP117, ATECC608B; PJ-242 pinout resolved in ADR 0002
    [minimeat.kicad_sch]
2026-10-12 Schematic: fan (4-pin KK) and servo (3-pin KK) outputs with series resistors, servo reservoir; ERC clean
    [minimeat.kicad_sch]
2026-10-12 hw: single-sided assembly noted
2026-10-12 Footprints and STEP models for the LED, button, inductor, TMP117 (no exposed pad), ESD array and PJ-242; button stays inside the case, only the LED light pipe goes through the flank
    [minimeat.kicad_sch]
2026-10-12 PCB: schematic synced to the board, 46x54 outline, first-pass placement of all 100 parts, fiducials; enclosure follows (board 46 mm, three standoffs, ambient louvre above the board)
    [minimeat.kicad_pcb]
2026-10-12 PCB routed: Freerouting 2.4.1 plus ground vias and top pour; 4 layers, DRC clean except 5 open connections and the USB-C library's hole-clearance warning; flow scripts
    [minimeat.kicad_pcb]
2026-10-12 PCB: TIP2/TIP3 joined at the ESD array, ground vias in every top-pour fragment; DRC has no open connections, only the USB-C library's hole clearance (0.194 mm against 0.25)
    [minimeat.kicad_pcb]
2026-10-12 ngspice probe front-end check (minimeat-sim): finds the 1k series resistor sitting inside the bias node, which reads 11 F low at 225 F; schematic moves the 47k bias to the tip side; PCB rework to fol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
    [minimeat.kicad_sch]
2026-10-12 PCB: probe bias resistors R23-R26 moved to the tip side of the 1k, matching the schematic fix; rerouted, DRC clean apart from the USB-C library holes, no open connections
    [minimeat.kicad_pcb]
2026-10-12 ADR 0002: amendment for the bias-resistor order found by simulation
2026-10-12 PCB: TMP117 sits in a no-pour area on all layers, ground pins joined by traces to one via; DRC unchanged
    [minimeat.kicad_pcb]
2026-10-12 PCB: stub tracks removed; fab outputs (gerbers, JLC BOM and placement) with the script that makes them
    [minimeat-bom.csv, minimeat.kicad_pcb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]
2026-10-12 BOM: R12 680R moves to Yageo RC0402FR-07680RL (C137948); the old part was out of stock at JLC
    [minimeat-bom.csv, minimeat.kicad_sch]
2026-10-12 ngspice: USB hot-plug ringing and load-switch inrush (docs/sim/power.md); the 5 V input stays inside 6 V with a normal cable, inrush spike and servo turn-on exceed a Default-class port
2026-10-12 Power sim notes: TLV62569 checked against its datasheet (6 V abs max, Table 4 LC and feed-forward match, UVLO 2.3-2.45 V)
2026-10-12 Power sim: absolute maxima confirmed for the TLV75533P (6 V) and TPS2553 (7 V)
2026-10-12 Supply rule: the fan and servo run only on a source advertising 1.5 A or more, else a supply fault and both off (SupplyWatch, twin test); ADR 0004, ICD and protocol updated
2026-10-12 Servo: HS-5065MG dimensions from Hitec's drawing (mounting holes 27.0 mm apart, case 20.0 high, gear housing 6.0, flange 2.0 thick); servo part note; mech docs follow
2026-10-12 Firmware: fan power enable (GPIO11) and the load-switch fault line (GPIO3): 0% really stops the fan, a steady fault latches both loads off until reboot; sim fan power and fault injection, twin test f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
    [board.rs, drive.rs, fault_load.rs, hal.rs, lib.rs, pit.rs, sim_hal.rs, tasks.rs]
2026-10-12 Servo: Hitec's STEP model in the assembly (spline 5.0 mm, top 29.0 from the model); mech tests pass
2026-10-12 Mech export: the real board (KiCad's STEP with component models, hw/tools/models.py puts the models on the placed footprints, ESP32 module included) in assembly.step; the plug stand-ins leave the ass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
2026-10-12 Mech export: Noctua's public NF-A6x25 model for the fan in the exported assembly; fan part note
2026-10-12 Fan dimensions from Noctua's model (bore 58, hub 26.5, corner radius 4); the cone is 1 mm longer to stay at 26 degrees; envelope and mech doc follow
2026-10-12 Linkage in RC metal: Secraft aluminium arm (12 mm holes), E-Z connectors and a Ø2 stainless wire replace the printed coupler; the crank is machined aluminium with a set screw on the rod's flat; ball 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
    [geom.py, params.py]
2026-10-12 Linkage: machined crank and flat coupler bar on M2 shoulder screws, the Secraft arm stays bought; E-Z connectors and wire dropped; crank and coupler STEP for the CNC quote
2026-10-12 Firmware binary runs the application's tasks (probes, control, actuators, slow) on the board in place of the demo loop; the actuator task gets the CC sense, fan power enable and load-switch fault line
2026-10-12 hw: KiCad re-save (file format upgrade and formatting; no design change)
    [minimeat.kicad_sch]
2026-10-12 Pre-fab review: power rework script (D1 polarity, wider power copper), hot-plug sim with the 2 A-hold PTC (overshoot corner documented)
    [power.py]
2026-10-12 Fix D1 polarity (TVS cathode to VBUS_RAW, footprint turned, schematic symbol turned); F1 to a 2 A-hold PTC (C89656); power copper widened to 0.3-0.8 mm; fab outputs regenerated
    [minimeat-bom.csv, minimeat.kicad_pcb, minimeat.kicad_sch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]
2026-10-12 Power copper rerouted wide: the stretches that could not be widened in place (VBUS_F, VSERVO, VFAN on In2) are routed again at 0.5 mm; all power tracks 0.4-0.8 mm except five pad necks; DRC unchanged
    [minimeat.kicad_pcb]
2026-10-12 Net labels for the seven auto-named nets (LED_A, 3V3A_FILT, BUCK_SW, VBUS_LDO, SERVO_ILIM, FAN_ILIM, ADC_RESET) in the schematic and on the board
    [minimeat.kicad_pcb, minimeat.kicad_sch]
2026-10-12 DRC: hole clearance 0.19 mm for J1 only (the USB-C connector's own land pattern); the four errors are gone
2026-10-12 WiFi provisioning, host side: Improv serial frame parser and conversation (generic over the port and the radio), Request::Wifi through the control task, forgotten credentials persisted as a tombstone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
2026-10-12 Firmware: console logs and Improv provisioning share the one USB Serial/JTAG port (whole log lines and whole frames under one lock, writes dropped with no host); main spawns the console writer and th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
2026-10-12 WiFi on the target: esp-radio station with DHCP, backoff and re-join, the Improv link, SNTP, an mDNS responder and the TCP connector for MQTT and OTLP; Connector halves may borrow the connector; sntp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
2026-10-12 Firmware: probes, actuators and control on an interrupt-mode executor above the thread-mode one that carries slow, the network and the console, so a fit is preempted and cannot delay the control peri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
2026-10-12 Revert "Firmware: probes, actuators and control on an interrupt-mode executor above the thread-mode one that carries slow, the network and the console, so a fit is preempted and cannot delay the cont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
    This reverts commit 3a3376c9a854f5b9b66ab6188a95fec604fb23f0.
    [board.rs, main.rs]
2026-10-12 Footprint models: the ESP32-C6-WROOM-1 gets its STEP (corner origin, offset -9/-9.75), the PJ-242's is lifted 1.6 mm (its origin is the bore axis, so the housing sat half inside the board); antenna_k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
2026-10-12 Board after Update PCB from Schematic: I2C_SDA via out of U1's antenna keepout, U1 and PJ-242 3D models (jacks lifted 1.6 mm), GND pad zone connections restored, F1 value 2A, pours refilled; fab gerb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
    [minimeat.kicad_pcb]
2026-10-12 Connectors reach into the port wall: board connector edge trimmed back 1.75 mm (square corners, 0.5 mm to copper) so the jack noses and the USB-C mouth hang past it; PJ-242 pads 1.8 x 1.5 per the dat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
    [minimeat.kicad_pcb]
2026-10-12 Mech: the USB-C shell's front is 0.6 mm inside the frame's edge (the housing is at 0.95): it hangs 1.15 mm past the trimmed edge; tests pass
2026-10-12 Mech export: assembly.step with a labelled product per part and the board as one flat piece (an exploded view no longer scatters its components); minimeat-3dprint.zip and minimeat-cnc.zip built with 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
    [board3d.py]
2026-10-12 docs/jlc3dp.md: every SLS, FDM, MJF and SLA material from the catalogs with its heat figure and load (PEEK 144 C at 1.8 MPa, 1172 Pro 179 C, PA12S-HP, ...); the M4-for-everything question answered: no
2026-10-12 The flap is a CNC part: 2.0 mm disc on a 4 x 5 mm rib, D-bore +0.03, retaining compound, no thread (a printed one cannot hold the 0.05 fit or the 0.15 mm gap); the duct's bore at the flap station is 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
    [analysis.py, drawings.py, params.py]
2026-10-12 mech-export: order folders build/mech/3dprint (duct, hood, pan: STEP and STL) and build/mech/cnc (flap, crank, coupler STEP, drawings.pdf), each with a README and a zip of the same files; assembly, s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
2026-10-12 Thin walls under JLC3DP's 1.2 mm check: the USB-C and first jack openings joined (a 0.2 mm web), louvre blades 0.81 to 1.26 mm (slots 3.2 at 6.2 pitch, field 4 mm taller), shell wall 2.8 mm with 1.3 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
    [params.py, shell.py]
2026-10-12 Rear screw columns moved out to |y| 33.3 (the pan's head channel left a 0.08 mm sheet to the cavity wall; now 1.2 mm); mech-export writes assembly.glb for Blender (one object per part, the board in f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
2026-10-12 Coupler rides 1 mm above the arms on bosses so the rod's end can stand 0.5 mm above the crank and clear the bar by 0.6 mm (rod 42.9 mm, 3 mm shoulder screws, test); the pan's bay is closed over the p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
2026-10-12 docs/ordering.md: everything to order besides the printed and CNC parts (board at JLCPCB, hardware, headers, cable and charger, probes) with quantities for five units and the open items; mech.md: 3 b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
2026-10-12 Standard bore: the duct's straight bore is Ø32.0 (H7 reamer, flap disc Ø31.6, same 0.15 gap) so a stock reamer does the flap station; coupler pivots are Ø3 shoulder, M2 thread (Ø3.1 coupler holes, 0.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
2026-10-12 Servo shelf: a solid block under each tab with an M2 pilot under all six of the STEP's screw holes (2, 4 or 6 screws in the field); the front block's face toward the body is a short vertical bridge (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
    [geom.py, params.py]
2026-10-12 Flap: disc centred on the rib by default (JLCCNC quote $21.90 vs $21.34 one-sided; balanced torque, closed leak 0.18 cm2); servo shelf: the outer corners of the shelf and both blocks are rounded R3 s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
    [params.py]
2026-10-13 Hard stops for homing: the crank has a 3 mm lug under the arm and the duct two 3 mm posts on its crown; the lug rests on them at exactly 0 and 90 deg, clear between and blocked 2 deg past either end 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
2026-10-13 Serial REPL on the USB-C port (minimeat-s7v): wifi, mqtt and otlp set/clear, config (passwords hidden), status, setpoint, identify, reboot, help; Tab completion of commands, words and typical values 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
    [config.rs, improv.rs, lib.rs, repl.rs, request.rs, tasks.rs]
2026-10-13 REPL editor skips an Improv frame by its length byte, not at the first newline (a length, data or checksum byte can be 0x0A); tests
    [improv.rs, repl.rs]
2026-10-13 Improv frame parser ported to winnow (a Partial<&[u8]> parser: marker, version, type, early-checked length, length_take, checksum; resyncs by dropping a byte on a miss): +192 bytes of flash, same tes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
2026-10-13 One winnow front end for the serial port: serial::Demux turns the bytes into Improv frames (improv::frame/rpc as winnow grammars, length and checksum, newline swallowed) or Keys; the REPL Editor is a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
2026-10-13 Servo shelf: only the corners away from the duct are rounded; the duct side stays square
2026-10-13 Pan: no tether holes and no drain scallop in the port bay's end walls (caps are untethered)
2026-10-13 PCB: net names on the test points' silkscreen (VBUS_F, 3V3, 3V3A, GND, EN, GND, UART_TX, UART_RX), placed clear of pads, other silk and the edge; DRC unchanged (132 warnings, none new)
    [minimeat.kicad_pcb]
2026-10-13 PCB silkscreen tidy: jack and module silk clipped to the board edge, references moved off pads and other silk (or to F.Fab where crowded), Antenna Area note inside the edge, L1 pin-1 dot beside its p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
    [minimeat.kicad_pcb]
2026-10-13 gitignore: KiCad project backups
2026-10-13 USB-C moved 1.5 mm out of the first jack's web: board +1.5 mm at its end, J1 and its fan-out rerouted (hw/tools/usb_shift.py; DRC: no new violations, no unconnected), enclosure params (x_len, usb_end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
    [minimeat.kicad_pcb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]
2026-10-13 J6/J7 to right-angle Molex KK 254 (22-05-3041 fan, 22-05-3031 servo): footprints and Molex STEP models, swap script, schematic footprints, docs; the vertical parts were 11.8 mm tall. Pads unchanged, 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
    [minimeat.kicad_pcb, minimeat.kicad_sch]
2026-10-13 Board turned over in the mech: SMT face down on the standoffs, parts hanging under it, tails up (the earlier model was mirrored); connector axes unchanged at z = -28.6, floor unchanged; reset-button 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
2026-10-13 Rod: JLCCNC quote recorded (SUS304, $30.80 at one), with the tolerance the general ISO 2768 medium does not give
2026-10-13 Rod as a machined part: rod.step and a drawing (Ø3 h7, flat 2.5 +-0.05, 42.7 +-0.1, quantity 6) in the CNC package, with a test that it matches the assembly's rod
2026-10-13 PCB cleanup: 52 duplicate/stub track fragments removed (KiCad cleanup), GND pours on F.Cu/In1/B.Cu squared to one rectangle 3 mm past the edge, J6/J7 right-angle KK footprints restored (an editor sav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
    [minimeat.kicad_pcb]
2026-10-13 Rename the project minimeat -> minimeater: Python package, commands, firmware crates, MQTT/HA/mDNS names, docs, KiCad project (Konnect rename_project) and part library (symbols swapped with replace_c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
    [minimeat.kicad_pcb, minimeat.kicad_sch, minimeater-bom.csv, minimeater.kicad_pcb, minimeater.kicad_sch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]
2026-10-13 Octilinear router for the PCB polish (minimeat-cwn.1): octo.py clearance rasters and 45-degree pull-tight; ar.py whole-net routing over F.Cu/In2/B.Cu with negotiated congestion (overlap price grows e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
2026-10-13 PCB placement and full reroute (minimeat-cwn.2, cwn.3): the VBUS/ESD/buck column moves 1.2 mm left into the strip the USB-C shift opened (shift_group.py); TP5/TP8/TP6/TP7 (EN, GND, TX, RX) in one 2.5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
    [minimeater.kicad_pcb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]
2026-10-13 PCB edits in the editor: tracks tidied (1287 -> 1040 segments, 201 -> 189 vias), footprints unchanged. DRC: 0 errors, 0 unconnected
    [minimeater.kicad_pcb]
2026-10-13 PCB stripped for re-layout: all tracks and vias deleted, connectors/headers/module/TMP117/LED locked in place, GND pour outlines combined (3 zones). Zone defaults: clearance 0.2, min width 0.2. The p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
    [minimeater.kicad_pcb]
2026-10-13 Re-layout setup (minimeat-e4a): netclasses PowerHigh 0.8, Power 0.5, GND 0.4, USB 0.27/0.15 (90 ohm pair), Analog 0.2/0.25 clearance, Default 0.2/0.15; net-coloured layout renderer (pcbdump.py + rend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
    [minimeater.kicad_sch]
2026-10-13 U4 TLV62569 buck block (minimeat-km4), off-board at (20, 75), per SLVSDG1C fig. 20: U4 turned 180 so VIN/SW/GND/FB/EN fall as in the figure; L1 straight above SW with the SW fill only between pin 3 a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
    [minimeater.kicad_pcb]
2026-10-13 U5 TLV75533P analog LDO block (minimeat-g72), off-board at (40, 75), per SBVS320D fig. 7-7 (DBV): IN/OUT fills with C8 1u at IN and C9 1u + C15 100n at OUT; C8's ground pad beside GND pin 2, joined o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
    [minimeater.kicad_pcb]
2026-10-13 U6/U7 TPS2553 load-switch blocks (minimeat-3fa), off-board at (75, 75) servo and (60, 75) fan, identical, per SLVS841F fig. 30: 100n IN bypass at pin 1 with its ground beside GND pin 2 on top; R_ILIM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
    [minimeater.kicad_pcb]
2026-10-13 Schematic for the re-layout (minimeat-bk4, 1ru): U2/U3 USBLC6 flow-through swapped (J1 side on pins 6/4, MCU side on 1/3; pins 1/6 and 3/4 are the same I/O inside) so the USB pair goes J1 -> U2 -> MC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
    [minimeater.kicad_sch]
2026-10-13 Project skill pcb-relayout: the re-layout workflow (blocks per datasheet off-board, render, Fable placement review, hand routing), per-block procedure, Konnect rules and gotchas, staging area, netcla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
2026-10-13 U2/U3 USBLC6 ESD block and VBUS entry (minimeat-bk4), off-board at (100, 75) and (110-121, 75): per ST DS4260 fig. 17, J1 side up; VBUS pins escape under the package bodies to C38 (C_BUS) between the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
    [minimeater.kicad_pcb]
2026-10-13 U9 TPD4E05U06 probe ESD block (minimeat-1ru), off-board at (20, 95), per SLVSBO7O fig. 7-11: straight-through over each I/O pad and the NC pad opposite, GND pads joined down the middle to a via each 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
    [minimeater.kicad_pcb]
2026-10-13 U11 ATECC608B block (minimeat-r7z), off-board at (40, 95): C34 100n beside VCC pin 8 with its ground via, GND pin 4 to a via. No layout section in the summary datasheet; standard decoupling. Block DR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
    [minimeater.kicad_pcb]
2026-10-13 U8 ADS122C04 probe ADC block (minimeat-yr1), off-board at (80, 102), per SBAS751B fig. 83: analog top / digital bottom; 1k + 100n per input with 45 degree runs into the pins (0.46 mm between runs kee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
    [minimeater.kicad_pcb]
2026-10-13 pcb-relayout skill: block positions in staging, parts left for placement, geometry lessons from the U9/U8 blocks
2026-10-13 U8 block compacted (19.8 x 15.3 -> ~15 x 14 mm): R23/R26 bias resistors lie across the TIP2/TIP3 lines (0603 body as the crossing, 0.325 mm each side) so the In2 VREF hop and its 3 vias are gone and 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
    [minimeater.kicad_pcb]
2026-10-14 Netclasses restored (they never reached the project file: KiCad rewrote it from memory) and DRC limits set to JLCPCB 4-layer capabilities: 0.09 mm track/gap, 0.1 mm clearance in every class (pad to t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
2026-10-14 U8 block: channels mirrored from the user's right-side rework. Each TIP line runs straight to its 1k (R19-R22 level, 1 mm apart); outer bias resistors (R23/R26) across the inner TIP lines with the in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
    [minimeater.kicad_pcb]
2026-10-14 U8 block: VREF filter nested between the bias resistors. C27 sideways in the R24/R25 gap (VREF pad on the C28 feed, via in its ground pad), FB2 and R18 in a row between R23 and R26 above the trunk, t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
    [minimeater.kicad_pcb]
2026-10-14 U1 ESP32-C6-WROOM-1 block, off-board at (108, 100), antenna down as on the board (unlocked): C22 100n at 3V3 pin 2 with its ground on the pin 1 trace, C21 10u further out with a via in its ground pad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
    [minimeater.kicad_pcb]
2026-10-14 pcb-relayout skill: U1 block in the staging list
2026-10-14 Small groups in staging (J6/J7 connector parts on the connector pitch, boot button, pull-ups, B.Cu test points, C33, R12) and the placement-review montage: hw/tools/montage.py renders every block and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
    [minimeater.kicad_pcb]
2026-10-14 Test points last (bead axk.5): out of the montage and the placement review; board mounted upside down noted (SW1 on F.Cu faces the pan-floor hole)
2026-10-14 Montage: port arrows on every net leaving a block (net > destinations, coloured by destination) and on the fixed parts' pins, tiles clipped to their own parts, staggered labels on tight pitches; enou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
    [render.py]
2026-10-14 Placement (axk.2, first pass): every block moved from staging onto the board per the placement review - U9/U8 under the jacks, U1 at (23.5, 41.5) antenna down (3.55 mm overhang, enclosure has ~4.6 mm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
    [minimeater.kicad_pcb]
2026-10-14 Placement relax pass (axk.2): U5 down 4 mm clear of the jacks, U4 down 2 mm / left 0.3 mm (C4 off J5, L1 off the edge), boot button group right 2 mm; pull-ups R14/R15/R7/R11 moved onto the U1 pins th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
    [minimeater.kicad_pcb]
2026-10-14 Zone fills refreshed by pcbnew after reopening (fill polygons only)
    [minimeater.kicad_pcb]
2026-10-14 J7 servo parts (R29, R30, C37, C36) 1 mm further from the header: every pad 1.1 mm or more from J7's through-hole pads (R30 was 0.1 mm), stubs and ground vias redrawn
    [minimeater.kicad_pcb]
2026-10-14 pcb-relayout skill: staging exit stubs are disposable when routing
2026-10-14 Route TIP1-4 (axk.3): jack -> U9 flow-through -> 1k inputs, mirror-symmetric about x 25.35, 45-degree corners, 0.5 mm pitch into U9; staging stubs replaced. U9's top GND via moved to y 13.4 for room 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
    [minimeater.kicad_pcb]
2026-10-14 Route USB pair and J1 fan-out (axk.3): USB_DP/DN on F.Cu only, 0.27/0.23 (90 ohm), 45-degree corners, U2 -> under U2 -> x 17.6/18.1 column -> under U8 -> U1 pins 14/13 (0.2 mm skew). J1: D+ pads join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
    [minimeater.kicad_pcb]
2026-10-14 Drop R11 (ADC_DRDY pull-up): the ESP32's internal pull-up on GPIO2 is enough for the ADS122C04's open-drain DRDY (board.rs already enables it), and R11 had no clean spot once the fan/servo blocks mov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
    [minimeater.kicad_pcb, minimeater.kicad_sch]
2026-10-14 Fan/servo switch placement (axk.3): U7 block moved 5.4 mm down into U6's old spot (same layout; U6's input/ground pours and ground vias reused, renamed U7_*, output pour re-netted to VFAN). U6 block 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
    [minimeater.kicad_pcb]
2026-10-14 Route the west side on F.Cu (axk.3): U1 pins 16-19 straight out to R28, R27/R16, R29 and U6 EN; U6 block output column into C37/C36/J7, ILIM, grounds and vias; VBUS_F to U6 along the board edge under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
    [minimeater.kicad_pcb]
2026-10-14 Swap I2C SDA/SCL on U1 pins 20/21 (SCL on GPIO22, SDA on GPIO23; board.rs and its pin table follow). U8's pins leave SCL west of SDA, so the swap lets both I2C lines cross under the USB pair on B.Cu 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
    [minimeater.kicad_pcb, minimeater.kicad_sch]
2026-10-14 Power plane and crossings (axk.3): In2 is now a 3V3 plane (priority over the In2 ground pour; TMP117 corner left out) carrying the VBUS_F trunk VIN_F -> FB1/U4 (1 mm), the 3V3A spur U5 -> U8/FB2, BTN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
    [minimeater.kicad_pcb]
2026-10-14 DRC rule: U1's exposed-pad squares connect solid to zones (they sit in the solid U1_EPAD pour; the board-wide pour could only reach each with one spoke). DRC now has no errors; 8 unconnected are the 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
2026-10-14 Board finishing (axk.4): staging outline removed; mounting holes H1-H3 placed at the enclosure's standoffs (10.6,28.7), (43,29.8), (43,49.6) (unchanged in Pcb.holes); fiducials FID1-3 on the board in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
    [minimeater-bom.csv, minimeater.kicad_pcb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]
2026-10-14 Test points on B.Cu (axk.5): TP1 VBUS_F, TP2 3V3, TP4 GND at U4; TP3 3V3A at U5; TP6/TP7 UART TX/RX and TP8 GND west of U1's pins (UART through under-module vias); TP5 EN beside R10. DRC: no errors, 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
    [minimeater.kicad_pcb]
2026-10-14 Ordering: order the one-up panel (JLC tooling holes and fiducials on its rails); single-board files kept as the fallback
2026-10-14 Silk (axk.1): remove the old board's free labels (VBUS_F/3V3/3V3A/GND, EN/GND/TX/RX) left at the old test-point spots, now over U8 and U11
    [minimeater.kicad_pcb]
2026-10-14 Silk pass (axk.1) and staging cleanup (axk.4): references at JLC's minimum (1.0 mm, 0.15 stroke), 62 placed beside their parts where they fit clear of pads, holes, bodies and other silk, 38 small pas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
    [minimeater.kicad_pcb]
2026-10-14 Back silk (cwn.6): flame mark and wordmark under the jacks, probe numbers P0-P3 between the jack pegs (probes[0..3]), rev A 2026-10, JLC order-number marker, QR code to the repository (KiCad 10 barco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
    [minimeater.kicad_pcb]
2026-10-14 License: hardware (hw/, the enclosure) under CERN-OHL-S-2.0, software and docs under GPL-3.0-or-later with a section 7 permission to link vendor binary-only radio libraries (esp-radio's Espressif blo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
2026-10-14 Back silk: open-source-hardware mark (KiCad's OSHW symbol, 4.4 mm) on the wordmark's other side from the flame; the hardware is CERN-OHL-S-2.0. DRC: no errors, nothing unconnected, the same 4 footpri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
    [minimeater.kicad_pcb]
2026-10-14 Edge GND stitching (cwn.4): 23 GND vias (0.6/0.3) about 3 mm apart, 0.9 mm in from the outline on all four sides, clear of the antenna keepout, standoff rings, courtyards and the back artwork; added 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
    [minimeater.kicad_pcb]
2026-10-14 Firmware: push work to compile time (ys6). Literal defaults (Ambient, Egg, Intake, AirPath, FanCycler, RefShaper, FireWatch, AutotuneConfig, Identifier, LidDetector, LidRecovery, Past, Cook, Lid) are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
2026-10-14 Firmware stack frames (e9e): the slow task works on a bench (Bus::bench, an async mutex holding the fit's Identifier copy and the spare AirflowMap), so Job/Done are tags and the 3-7 KB values never c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
    [autotune.rs, main.rs, mod.rs, pit.rs, tasks.rs]
2026-10-14 Firmware: transcendental constants at build time (35h). minimeater-core/build.rs runs the same libm (a build-dependency, pure Rust) and writes OUT_DIR/consts.rs as exact bit patterns: ln(TAU_MIN), ln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
2026-10-14 Enclosure fixes before printing (4lg, z7v, p4k; wu1 was done in cb44cdc). Pan: the port bay's front end moves from x -19 to -24, clear of the front screw column (0.66 mm; the front plug clears the en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
    [drawings.py, params.py, shell.py]
2026-10-14 Fix the stale bay test (edx): the drain scallop was removed on purpose in 3c64291 (the bay's floor is the belly's round, open all along), but test_bay_is_under_the_eave_and_drains still asserted it w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
2026-10-14 Printed materials and the M4 insert (dx8): all three printed parts in MJF PA12S-HP black (the duct's 175 C material; the shells too, for one process, MJF's 1.0 mm minimum wall that the flagged 1.0-1.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
    [params.py]
2026-10-14 Duct: 20 mm socket extension with an 8-lobe gripping bore; the M4 thumbscrew goes (e5g). The socket runs on past the old mouth (Coupling.ext_len, a placeholder). Over it the bore goes from round to e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
2026-10-14 SPICE: probe error budget and fan lines (seq.3.12, seq.3.13). Probe: every board-side source at its datasheet limit (bias 0.1 % and 25 ppm/K to 85 C, TPD4E05U06 10 nA, ADS122C04 input current, gain, 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
    [budget.py, fan.py]
2026-10-14 Board: rework pads on FAN_TACH, not fitted (C39, R31). From the fan sim (seq.3.13): C39 0402 FAN_TACH to GND for a 1 nF glitch filter if the tach count misbehaves despite the PCNT filter, and R31 040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
    [minimeater.kicad_pcb, minimeater.kicad_sch]
2026-10-14 Board: VBUS_F snubber footprints (R32, C40, not fitted) and C39 fitted. R32 0.47R 0805 + C40 100uF 10V 1210 (C1's part) in series VBUS_F -> VBUS_SNUB -> GND beside F1, for minimeat-kqt: the hot-plug 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
    [minimeater-bom.csv, minimeater.kicad_pcb, minimeater.kicad_sch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]
2026-10-14 Board: fields synced from the schematic (KiCad Update PCB from Schematic): C39's value 1nF and LCSC C1523, the LCSC notes on R31/R32/C40, sheet metadata. Schematic parity now clean; DRC unchanged (no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
    [minimeater.kicad_pcb]
2026-10-14 Input eFuse U12 replaces the F1 PTC (8s2; supersedes kqt and brt). TI TPS259531DSGR (C2155674) between VBUS_RAW and VBUS_F: C42 10 nF dVdt soft start (4.2 V/ms), R35 1k current limit (2.04 A, the PTC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
    [minimeater-bom.csv, minimeater.kicad_pcb, minimeater.kicad_sch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]
2026-10-14 BOM: JLC stock check and MPNs (jjv). Every assembled line checked live for 5 boards, all in stock at 3x or more (tightest ATECC608B 986, ESP32-C6 module 3,696, ADS122C04 4,378). MPN filled on the 76 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
    [minimeater-bom.csv, minimeater.kicad_sch]
2026-10-14 Board: fields synced from the schematic (F8): the MPN and LCSC fields on the footprints, R18's 10R 5%, pin metadata. Fields only, no placement or copper change; schematic parity clean, DRC no errors,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
    [minimeater.kicad_pcb]
2026-10-14 Board: C36 and C37 off J7's through-holes. C36 (100 uF servo reservoir) moves right to x 7.5: its pads were 0.17 mm from J7's pin 1/2 pads, now 0.84, still sitting on the VSERVO run and 0.15 mm clear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
    [minimeater.kicad_pcb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]
2026-10-14 Board: stackup set to JLCPCB JLC04161H-7628 with ENIG (Board Setup; read back over IPC): 1 oz outer, 7628 prepreg 0.2104 mm er 4.4, 0.5 oz inner, 1.065 mm core er 4.6, 1.606 mm with mask. Recorded in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
    [minimeater.kicad_pcb]
2026-10-14 Fab: JLC rotation offsets in the CPL. JLC's assembly preview put pin 1 diagonally opposite ours on every SOT-23-5/6 (U2-U7; on the USBLC6s that would swap VBUS and GND) and 90 deg off on the TSSOP-16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
    [minimeater-cpl.csv, minimeater-panel-cpl.csv]
2026-10-14 Fab: per-part JLC offsets. The preview still had U2/U3 (USBLC6, C7519) 90 deg off: JLC's footprint for that part has pin 1 bottom left with the pins in rows, like ours, so its offset is 270, not the 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
    [minimeater-cpl.csv, minimeater-panel-cpl.csv]
2026-10-14 Back silk: JLC order-number placeholder removed (order with Mark on PCB: Remove Mark; noted in hw/README.md). silk_back.py rerun with KiCad closed; DRC unchanged (the 4 known silk warnings, nothing u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
    [minimeater.kicad_pcb]
2026-10-14 Silk: connector references beside their parts. J2-J5 centred under each jack (J2 and J3 sat near U7 and U9, J4 and J5 were hidden: the jacks have no courtyard for silk.py to place against); J1 stands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
    [minimeater.kicad_pcb]
2026-10-14 D2 turned 180 deg so its lens faces the board edge and the light pipe. The LTST-S220KGKT's tape drawing (cathode up, lens right, seen from above) and JLC's footprint both put the lens on the -y side 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
    [minimeater.kicad_pcb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]
2026-10-14 D2's reference back on the board: turning D2 swung its label round the part to y 55.1, past the bottom edge, and JLC's upload then flagged the files as offset on every try. Back at (37.76, 50.7) wher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
    [minimeater.kicad_pcb]
2026-10-14 Fab: every output measured from the board's bottom-left corner. JLC's assembly upload kept drawing the parts away from the board and asking to auto-align them: the gerbers, drill and CPL were in KiCa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
    [minimeater-cpl.csv, minimeater-panel-cpl.csv]
2026-10-14 CFD pipeline: just cfd <case> builds the duct's air volume from the build123d parts (fan annulus, cone, bore with the flap and rod at any angle, 12 D of tube), meshes it with snappyHexMesh and solves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
2026-10-14 CFD: 60 deg and swirl cases, the flap's loss law corrected through the CFD at 30/45/60 deg, and minimeater-operating: the firmware's damper-first airflow map walked for pit 225-450 F at ambient 40-95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
2026-10-14 LES prep for the flap (.2.18): just les builds and runs an incompressible LES case (pimpleFoam, WALE, adjustable step to Courant 0.8, flap region refined; coarse/medium/fine resolutions 0.84 M / 1.35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
2026-10-15 Power tree dissipation (.3.2): docs/sim/dissipation.md from minimeater-sim, a closed-form model of what D1, U12, U4, U5, U6 and U7 burn at ADR 0004's cook, worst-normal and 1.5 A-budget points, their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
    [dissipation.py, power.py]
2026-10-15 Rail transients in ngspice (.3.14): docs/sim/rails.md from minimeater-sim, the whole power path (USB source with cable R/L or a current limit, D1, U12 with its UVLO, VBUS_F, U4 3V3, U5 3V3A, the serv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
    [rails.py]
2026-10-15 TI's TLV62569 transient model in ngspice (.3.19): TI publishes it unencrypted (SLVMBW3), so no Windows PSpice is needed. ti_models.py fetches, converts (VSWITCH to SW, one .IC dropped) and caches it 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
2026-10-15 Hardware watchdog fed by the control task (.4.24): hal::Watchdog, armed at 30 s once the boot's flash reads are done and fed each control period and after each request, only while the actuator task i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
    [board.rs, fault_probe.rs, hal.rs, lib.rs, main.rs, power_cut.rs, scenario.rs, tasks.rs]
2026-10-15 Reboot request acts on the target (.4.27): a task waits on bus.reboot, lets the reply and last status go out for 500 ms, then software-resets; settings are saved as they change, so the board comes ba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
    [main.rs]
2026-10-15 Status LED and user button (.4.30): minimeater-app::ui drives the LED (identify 5 Hz for 10 s, unacknowledged alarms 2 Hz, a fault 1 Hz, a cook in progress a brief flash every 3 s) and reads the butt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
    [hal.rs, lib.rs, main.rs, scenario.rs, ui.rs]
2026-10-15 Boot event with its reason (.4.31): Event::Boot, raised by the first MQTT session of a boot once the old news is dropped, in the same JSON as proto::boot. The C6 reads the reset reason register and a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
    [events.rs, lib.rs, main.rs, mqtt.rs, pit.rs, reset.rs, tasks.rs]
2026-10-15 A panic resets at once (.4.33): esp-backtrace's custom-halt hook drives the fan and servo power enables low and software-resets with no mark, so the next boot reads panic instead of waiting 30 s for 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
    [reset.rs]
2026-10-15 Real board against the enclosure (.2.6): tests/test_board_fit.py exports KiCad's STEP of the board with every part and intersects each of its 277 solids with the shells and the chassis (bounding boxe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
    [board3d.py]
2026-10-15 JLC stock check runs without a KiCad install: scripts/jlc_stock.py --bom falls back to the kicad container under podman. All assembled lines for 5 boards are in stock at 3x or more, none missing, all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
2026-10-15 ATECC608B driver: read the whole configuration zone, write it a word at a time (refusing the fixed bytes and the lock word before touching the bus), lock the configuration and data zones with the CRC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
    [atecc608.rs]
2026-10-15 board3d: the container export works for an output directory outside the repository (exported inside build/mech, then copied); found by just ci-py, whose 120 tests now pass
2026-10-15 Ambient (.4.15): the TMP117 reading is compensated for the board's heat (air = (raw - k*board)/(1-k), k = 0.1 est, bounded to 5C, board from the ADC die) and board_hot also trips on the sensor itself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
    [ambient.rs, atecc608.rs, hal.rs, lib.rs, probes.rs, scenario.rs, sim_hal.rs, suite.rs]
2026-10-15 Pit probe loss fails safe within 30 s (.4.28): the grace is met at two whole control periods without the probe (>= 20 s, was > 20 s, which took three), so the flap is closed and the fan stopped 10-20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
    [fault_probe.rs, pit.rs]
2026-10-15 Button held for 30 s resets every setting (.4.32): Request::Defaults restores Settings::default (cook, probes, learned schedule, WiFi, MQTT, OTLP), resets the pit loop, saves, publishes ~/config and 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
    [pit.rs, request.rs, tasks.rs, ui.rs]
2026-10-15 board_hot from the ambient sensor on the twin (zkd): a fault injects an offset on the TMP117; board_hot raises at 80C, holds through the 75-80C band without flapping and clears below it. The test sho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
2026-10-15 Serial REPL factory-reset (eir): 'factory-reset erase' sends Request::Defaults, the button's 30 s reset; without the word erase it only says what it would do, and Tab never offers the word. Parser te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
    [repl.rs]
2026-10-15 Serial REPL (s7v): a log line arriving while a command is half typed no longer splits it; the log writer erases the prompt line, writes the log line and redraws the prompt and typed text (repl::Live,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
    [console.rs, improv.rs, repl.rs]
2026-10-15 Read-only HTTP status endpoint (g7r): GET /health and GET /status (the ~/state object) on port 80, nothing that writes; anything but GET is 405, other paths 404, a client that stalls 5 s or sends ove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
    [http.rs, lib.rs, main.rs, net.rs, scenario.rs]
2026-10-15 ATECC608B provisioning (.4.34): the configuration for ADR 0005 (slot 0 a sign-only P-256 key made by GenKey, slot 8 the certificate), written as only the words that differ, read back and compared bef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
    [atecc608.rs, board.rs, csr.rs, enrol.rs, identity.rs, lib.rs, main.rs, mod.rs]
2026-10-15 Device certificate in ATECC slot 8 (84q): identity cert [start | add <base64> | save] loads the CA's DER certificate as base64 words of 64 characters, save checks it is a DER SEQUENCE of the length i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
2026-10-15 TLS client pieces (5.5): embedded-tls 0.19 as the stack (ADR 0006): tls::Provider (pinned-CA server verification, device certificate), tls::DeviceKey (the ATECC608B signs the handshake through a Dige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
    [csr.rs, lib.rs, tls.rs]
2026-10-15 Board TLS signer (b5w): the secure element sits behind one lock (enrol::Shared) that the REPL's enrolment task holds for a whole job and tls::ChipSigner takes without waiting for a signature; embedde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
    [board.rs, enrol.rs, main.rs, tls.rs]
2026-10-15 Pinned CA setting for MQTT TLS (oi7): mqtt ca [start | add <base64> | save | clear] collects the CA's DER certificate (at most 480 bytes) as base64 words of 64 characters, like identity cert; save ch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
2026-10-15 MQTT over TLS (a4l, n1q): the session opens TLS 1.3 over its connection exactly when a pinned CA is stored, proves the broker is one the CA signed (name checked) and presents the device certificate, 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
    [board.rs, broker.rs, lib.rs, main.rs, tls.rs]
2026-10-15 Mosquitto TLS interop (v1p): just mosquitto-tls runs the app's MQTT session against Mosquitto 2.1 in a container that requires a client certificate from the private CA, takes the certificate's name a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
2026-10-15 Twin serial port (8h6): the twin runs the app's Improv/REPL loop on an in-memory USB port; Action::Serial types text at it and Report::serial holds what the app wrote. Test types setpoint (accepted a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
    [lib.rs, net.rs, scenario.rs, serial.rs]
2026-10-15 identity rekey (5ix): 'identity rekey replace' erases the certificate in slot 8 first, then has the chip make a new key in slot 0; without the word it only says what it would do. Only a chip provisio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
    [enrol.rs, identity.rs, repl.rs]
2026-10-15 tls test prints the host handshake time (2 ms), noted on the bench bead
2026-10-15 Servo calibration (bkz): closed/open pulse widths are stored in flash (Settings.servo) and the actuators use them; the serial console's 'servo' command holds a pulse (jog <us>, +n, -n; 500 to 2500 us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
2026-10-15 Servo homing (xdn): with no calibration saved and no cook to resume, the actuator task sweeps the servo slowly into each hard stop at power-on (or on 'servo home'), reads the stall on the load switch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
    [drive.rs, hal.rs, repl.rs, request.rs, scenario.rs, servo.rs, servo_home.rs, servo_home_cancel.rs]
2026-10-15 Homing stall detector tolerates a chattering fault line (73s): the line is read ten times per step and a stall is two steps with it seen low among the last five, not two in a row; sim chatter model a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
    [drive.rs, hal.rs, servo_home_chatter.rs, tasks.rs]
2026-10-15 Schematic: servo current sense (vpg). R36 0.1 ohm 0402 shunt (ERJ-2BWFR100X, C2088598) splits the servo supply: VSERVO_SW is U6 OUT with its 10 uF + 100 nF, VSERVO is the servo side (C36 100 uF reser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
    [minimeater.kicad_sch]
2026-10-15 Schematic POWER TREE note brought up to date (bo6): the input is VBUS_RAW through D1 and the U12 TPS259531 eFuse (2.04 A, 4.2 V/ms soft start, 5.7 V clamp) to VBUS_F, not the PTC F1 the eFuse replace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
    [minimeater.kicad_sch]
2026-10-15 Layout block: U13 INA181A1 servo current sense with R36 shunt (sp4), staged left of the board at (-25, 40) on a small temporary outline (x -31..-20, y 35..44.5) with its own STAGING_In1_GND zone. TI 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
    [minimeater.kicad_pcb]
2026-10-15 Schematic: name the U13 OUT -> R37 net SERVO_IAMP (was the auto name Net-(R37-Pad1)); a local label on a stub below OUT, so the board net is /SERVO_IAMP. ERC 0; netlist changes only that net's name
    [minimeater.kicad_sch]
2026-10-15 Pin swap (9jn): SERVO_ISENSE to GPIO2 (U1 pin 27, ADC1_CH2), ADC_DRDY to GPIO6 (pin 6, MTCK). GPIO6 sits on the module's right column, about 30 mm from the servo corner where the current-sense block 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
    [minimeater.kicad_sch]
2026-10-15 Board: servo current-sense block placed and routed (55j). Room beside U6: J6 and J7 raised 4.0 mm along the rear edge with R30, R29, C37, C36 (Pcb.kk follows); R28/R27 stay and J6 reaches them by 45 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
    [minimeater-bom.csv, minimeater.kicad_pcb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]
2026-10-15 Firmware reads the servo current and homes on it (sul). New hal trait ServoCurrent (mA, averaged), a Board type and Io field; board.rs reads the INA181 on GPIO2 (ADC1, 11 dB, calibrated, eight conver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
    [board.rs, drive.rs, hal.rs, lib.rs, main.rs, mod.rs, servo_home_chatter.rs, servo_sense.rs]
2026-10-15 Servo current in the status and OTLP, and a servo fault from it (y8a). protocol.md (normative): out.servo_ma {peak, mean} in mA over the last move (powered until switched off; null before the first; 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
    [drive.rs, fault_servo.rs, fault_servo_current.rs, fault_servo_jam.rs, fault_servo_unplugged.rs, hal.rs, mod.rs, otlp.rs]
2026-10-15 Board: via-in-pad on the module, rerouted, TPs moved, GND test points square (minimeat-7xk). Your pass: eleven signal vias into the centres of U1's pads (BTN, UART_RX/TX, I2C_SCL/SDA, LOAD_FAULT, SER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
    [minimeater.kicad_pcb, minimeater.kicad_sch]
2026-10-15 Board tidy (minimeat-b1z): the LED via out of U1 pad 11 to (33.45, 37.06), where it was before the via-in-pad pass. It sat 0.5 mm off the pad's centre and overhung its end, and a centred one does not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
    [minimeater.kicad_pcb]
2026-10-15 Board: U9 fan-out reworked, F.Cu GND fill left of FB2 (minimeat-491). The pocket left of FB2 was an island: the 3V3A via above FB2 pad 1 left about 0.3 mm to the TIP2 line, short of the fill's 0.2 mm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
    [minimeater.kicad_pcb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]
2026-10-15 Board: via-in-pad pass (minimeat-ev1). 29 vias move into the pads they serve: FB1 pad 1 (VBUS_F, 0.6/0.3; its In2 stub slides along the main run to drop straight into the pad) and D2 pad 1 (GND, 0.6/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
    [minimeater.kicad_pcb]
2026-10-15 Board: teardrops rebuilt after the via-in-pad pass and the U9 fan-out (319 in all). DRC: no errors, nothing unconnected. Fab gerbers regenerated. Correction to da2759f's message: C17, C30, C32 and C3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
    [minimeater.kicad_pcb]
2026-10-15 Board: via-in-pad, the rest (minimeat-ypv). Reroutes so the last 18 stub vias sit in their pads (74 of 143 now in pads; the only stub left is the LED's at U1 pad 11, which needs the CC1/CC2/ADC_DRDY 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
    [minimeater.kicad_pcb]
2026-10-15 Board: teardrops rebuilt after the last via-in-pad reroutes. DRC: no errors, nothing unconnected. Fab gerbers regenerated
    [minimeater.kicad_pcb]
2026-10-15 Board: LED via into U1 pad 11, the right-column bundle redone (minimeat-j0m). The trunk keeps its 45 degree diagonals; at the column FAN_EN runs on to x 32.25 and drops straight into its via (its jog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
    [minimeater.kicad_pcb]
2026-10-15 Board: route cleanup by hand, teardrops rebuilt. FAN_EN leaves R9 pad 1 east and climbs a 45 degree to its trunk at x 9.46, between C17 and VFAN (VFAN's corner moved to x 8.8 to suit); the LED drops 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
    [minimeater.kicad_pcb]
2026-10-15 Board: micro-segments straightened. ADC_DRDY's last bend is one 45 degree in place of a 6 um flat; the GND via at (5.6, 19.95) moves up 10 um to (5.6, 19.94), so CC2 runs straight at y 20.444 and CC1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
    [minimeater.kicad_pcb]
2026-10-15 Board: KiCad's cleanup pass. No copper, footprint, via or zone change: the teardrop zones are reordered and their priorities renumbered, and SERVO_PWM's teardrop at U1 pin 18 is rebuilt for the merge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
    [minimeater.kicad_pcb]
2026-10-15 Mech: the measured tube (OD 34.89, ID 30.83, free length 31.94) in params.py (minimeat-z52). The lobed extension is 10 mm (was 20): the 20 deep socket plus it seats the tube on its shoulder with its 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
    [geom.py, params.py]
2026-10-15 Mech: three water and flow fixes seen on the renders (minimeat-0by). (1) The top louvres, climbing inward, broke out through the rear face's 45 degree chamfer, an upward face rain runs into: the gril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
    [params.py, shell.py]
2026-10-15 Mech: mock.fan_step's docstring had the fan's label on the intake; Noctua's model has it on the motor plate at the exhaust face
2026-10-15 Mech: a tail cone behind the fan's motor plate, printed with the duct on three airfoil struts (minimeat-seq.2.22). Noctua's STEP shows the outlet face's motor plate is part of the frame (stationary),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
2026-10-16 Mech: the socket's extension is a smooth Ø46 outside (minimeat-seq.2.23), and the box's mass budget. The lobed extension's wall followed its wave, so its outside was wavy against the enclosure: a 1.2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
    [analysis.py, params.py]
2026-10-16 Mech: the O-ring groove moves to x -15 (was -10) and the socket's lobes start 1 mm in front of it (minimeat-seq.2.24). The seal line is about 5 mm in from the tube's end, clear of its cut end's chamf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
2026-10-16 Mech: six stator vanes hold the tail cone, taking out the fan's swirl (minimeat-seq.2.25). The rotor leaves the air turning with it (clockwise looking downstream, read off Noctua's blades), and Euler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
2026-10-16 Mech: renders through VTK (PyVista) and a disk cache for the slow parts (minimeat-c1l). render.py drew with matplotlib's painter's sort, splitting triangles to keep the order right; it now renders of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
2026-10-16 Mech: the stator vanes' chord follows the pitch (minimeat-seq.2.25). Each section's trailing edge is found so that its camber length over the pitch is HubCone.vane_solidity = 1.2: the pitch grows wit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
2026-10-16 CFD: the NF-A6x25 in a rotating frame, its exit profile as the duct's inlet, and the intake grille case (minimeat-seq.2.25, .2.26). cfd/fan.py runs Noctua's frame and rotor with the rotor's cells tur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
    [fan.py]
2026-10-16 Mech: the stator vanes turn the fan's measured inflow (minimeat-seq.2.25). The fan in a rotating frame (cfd/fan.py) leaves the air at about twice Euler's floor near stall, 66-79 deg off the axis at t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
    [params.py]
2026-10-16 Mech: a 14.5 mm plenum in front of the fan (minimeat-seq.2.28). The grille CFD (cfd/grille.py) left the fan 2.9 Pa of its free-air 12.0 static at 4.2 CFM with the louvres 4.5 mm off it; 5/10/20/30 mm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
2026-10-16 Mech: the inlet as a designed pair of curves, and the stator vanes as one fitted surface with a root fillet (minimeat-seq.2.29, .2.30). The straight 26 deg cone had a corner at the fan's face and at 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
2026-10-16 Mech: the duct's outside follows the airway, filleted off the flange and stepped to the socket by a smootherstep (minimeat-seq.2.31). It was a straight cone from the flange's back face to the straigh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
    [params.py]
2026-10-17 Mech: the rear seam climbs with the gills, eight full-length gills at 6.12 pitch, and plenum shaping in the grille CFD (minimeat-seq.2.32, .2.33). The level V seam sat off-centre in a thin blade with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
2026-10-17 PCB: H1-H3 are M2 mounting holes (MountingHole_2.2mm_M2, NPTH 2.2) at the same positions (minimeat-unc). One screw size, M2, for the board, the servo tabs and the shell, M3 only for the fan. Excluded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
    [minimeater.kicad_pcb]
2026-10-17 Mech: two thread sizes, M2 and M3 (minimeat-unc). M2.5 is gone: the board's holes are M2 (Pcb.hole_d 2.2, matching KiCad's MountingHole_2.2mm_M2) on standoffs with M2 pilots, and the front shell pair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
    [params.py, shell.py]
2026-10-17 Mech: twelve anti-swirl ribs in the plenum, on the shells, clear of the fan's M3 heads (minimeat-wly). The grille CFD's tip ribs kept 11.1 Pa of the fan's 12.0 static against 6.8 without, but ended 2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
    [params.py, shell.py]
2026-10-17 Scene toolchain: Blender bpy 5.2.2 + Cycles in a uv 'scene' group (minimeat-cp2.1). bpy has cp313 wheels for macOS arm64 and Linux x86_64, the project's Python pin, and resolves beside build123d and 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
2026-10-17 Mech: scene-ready assembly export for the raytraced animation (minimeat-cp2.3). scene.py builds the assembly at any flap angle (mech-export --flap DEG), with a PBR material per part (nylon, brushed s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
    [glb.py, scene.py]
2026-10-17 Mech: one assembly.glb, the fan's rotor its own node, the cutaway left to the Blender scene (minimeat-cp2.3, cp2.5). assembly_cut.glb and the OCC cut code are gone (40 s off mech-export): a Boolean m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
    [glb.py, scene.py]
2026-10-17 Pathlines through the whole airway, and the first pass of the molecule scene (minimeat-cp2.2, cp2.4-2.6, 2.9, 2.10 in part). cfd/pathlines.py joins the grille case and a duct case at the fan's exit a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
2026-10-17 Film: the smoke shot, camera names, a poster frame (minimeat-cp2.4-2.11). smoke.py: a scrolling-noise plume grows along the rise path with the CO2, 28 amber flavour particles spiral beside it (kept a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
    [film.py, smoke.py]
2026-10-17 Film: the gas as a moving flow, the molecule and flavour particles individuals in it (minimeat-cp2.13). swarm.py: about 1800 parcels ride the CFD's own pathlines as comets (head and a 0.5 s tail, col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
2026-10-17 Film: gas parcels meet the blades where the CFD had them (minimeat-cp2.14). In the rotor's zone screen time is real time over a fixed ratio (the molecule's clock law meets it at 8 m/s; the zone takes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
    [film.py, swarm.py]
2026-10-17 Film polish: ember sparks, heat shimmer, bloom, a beacon on the molecule in the egg shots, per-shot exposure, captions (minimeat-cp2.12). swarm.sparks throws embers off the hero lump through the flar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
    [film.py, swarm.py]
2026-10-18 TLS: the chip's client skips signature schemes and groups it has no name for (minimeat-3hd). OpenSSL 4's CertificateRequest lists the scheme 0x0708 and its EncryptedExtensions the groups 0x11ee and 0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
    [tls.rs]
2026-10-18 Board: each probe jack's ring to a GPIO for smart probes (minimeat-098). The ring (PJ-242 pad 4) leaves AGND for a 4.7k pull-up, a 1k series resistor and one more TPD4E05U06 (U14, C138714; the resist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
    [minimeater-bom.csv, minimeater.kicad_pcb, minimeater.kicad_sch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]
2026-10-18 CFD: the duct cases re-run on the current geometry (minimeat-1rm). The open duct at 6 CFM is k_static 2.23 / k_total 1.15 (was 1.26 / 0.16 before the neck, cone and vanes); flaps 30/45/60 are 4.43 / 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
2026-10-18 Grille CFD: inner-side variants and a flow-field view (minimeat-seq.2.34). grille.py takes '+'-joined --plenum shapings: notched rib sets that replace the shells' ribs, turning lips under each gill (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
2026-10-18 docs/cfd.md: the plenum, exterior unchanged (minimeat-seq.2.34). Steady MRF near stall wanders ~1 Pa, so cases report a windowed mean; the baseline's field (rising jets, starved top rows, the tips' b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
2026-10-18 The natural draft with the fan stopped (minimeat-seq.2.35). The grille case takes --stopped (no rotating frame, the rotor a still wall) and both cases --laminar; at 1.0 and 0.5 CFM the stopped path l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
2026-10-18 Poster: frame 290 of the finished film (minimeat-cp2). The molecule at the fan's inlet among the gas parcels, with the film's captions; replaces the pathline-only still
2026-10-18 Servo: always calibrate before a cook drives the flap, and say when it could not (minimeat-ixz, minimeat-bhp). A cook that starts during homing no longer stops it: the run (about 30 s, fan off) finis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
    [discovery.rs, drive.rs, events.rs, pit.rs, proto.rs, repl.rs, servo_home_cancel.rs, servo_home_fail.rs]
2026-10-18 fw: cargo fmt the ADS122C04 driver's tests (cargo fmt --check failed on them)
    [ads122c04.rs]
2026-10-18 Whistle verdict tooling (minimeat-seq.2.19). les.py --force-hz/--force-amp: the inlet oscillates at a duct mode, which the compact flap sees as the mode's acoustic velocity. whistle.py: from a forced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
2026-10-19 Whistle verdict: the round edge stays, no runner-up flap (minimeat-seq.2.19). Forced LES at the first two duct modes at every point the damper-first map visits: the flap's acoustic resistance is posi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
2026-10-19 Whistle verdict without swirl (minimeat-seq.2.19). Forced LES at the first two duct modes at every point the damper-first map visits: the flap's acoustic resistance is positive everywhere (+950 to +6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
2026-10-19 LES inlet swirl (minimeat-seq.2.20): the flap still does not whistle; the round edge stays (minimeat-seq.2.19). les.py --rpm: solid-body swirl in the rotor's sense through swirlFlowRateInletVelocity,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
2026-10-19 USB and probe ESD consolidation (minimeat-0qm, minimeat-plr). U2+U3 USBLC6-2SC6 and C38 replaced by one TPD4E05U06DQAR (U2), channels in J1's pad order CC2, D+, GND, D-, CC1, centred under J1 at (4.2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
    [minimeater.kicad_pcb, minimeater.kicad_sch]
2026-10-19 GND stitching (minimeat-182). The F.Cu and B.Cu pours were 8-10 mm from a via in the jack strip, where probe ESD returns, and under U1. 17 GND vias (0.6/0.3): one beside each jack's GND pad 7 at (jac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
    [minimeater.kicad_pcb]
2026-10-19 Tracks optimized and teardrops regenerated in the editor: collinear TIP4/RING4 runs into U14 merged, the escape stubs that lay wholly inside the jack pads (RING1, TIP2, TIP3, TIP4) dropped, 320 teard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
    [minimeater.kicad_pcb]
2026-10-19 U12 (TPS259531DSGR) 3D model: KiCad's generic WSON-8-1EP 2x2 STEP copied into hw/lib/3d and referenced from the project; the stock Texas_DSG0008A model file does not exist and TI has none
    [minimeater.kicad_pcb]
2026-10-19 Fab outputs regenerated for the current board: gerbers (board and panel), BOM and CPL now carry the TPD4E05U06DQAR ESD consolidation (U2 U9 U14; USBLC6 U2/U3 and C38 gone), the GND stitching vias and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
    [minimeater-bom.csv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]
2026-10-19 U12 (TPS259531DSGR) footprint moved to the project library: minimeater.pretty carries KiCad's stock DSG0008A footprint with its model pointed at lib/3d/WSON-8-1EP_2x2mm_P0.5mm_EP0.9x1.6mm.step, so an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
    [minimeater.kicad_pcb, minimeater.kicad_sch]
2026-10-19 Gerbers regenerated after the footprint update and teardrop reapply; BOM and CPL unchanged. DRC: 0 unconnected, 0 footprint errors
2026-10-20 docs/mech.md: the rod is a made part (cnc/rod.step, 6 off) alongside the flap, crank and coupler
2026-10-20 Board saved from the editor (a track segment re-routed, zone and teardrop refills) and fab outputs regenerated: gerbers for the board and the panel; BOM and CPL unchanged. DRC: 0 unconnected, 0 footp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
    [minimeater.kicad_pcb]
2026-10-20 Layout changes from the editor
    [minimeater.kicad_pcb]
2026-10-20 Silk overlaps cleared: J4 and R28 reference texts moved, L1 and U13 outline edges dropped where they touched U4 and R37. Fab outputs regenerated; BOM unchanged. DRC: 0 unconnected, 0 footprint errors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
    [minimeater.kicad_pcb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]
2026-10-20 Board saved from the editor (zone refills) and fab outputs regenerated. DRC: 0 unconnected, 0 footprint errors
    [minimeater.kicad_pcb]
2026-10-21 Components renumbered and silks changed; schematic and board saved, fab outputs regenerated (BOM and CPL carry the new references). DRC: 0 unconnected, 0 footprint errors, 1 silk_overlap (R18/C18)
    [minimeater-bom.csv, minimeater.kicad_pcb, minimeater.kicad_sch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]
2026-10-21 CPL: U11 (INA181A1, SOT-363) rotated 270 for JLC's footprint, which draws its pins in rows against our columns like the SOIC; fab.py JLC_ROTATION gains the SOT-363 entry. Gerbers and BOM unchanged
    [minimeater-cpl.csv, minimeater-panel-cpl.csv]
2026-10-21 Print STLs tessellated finer: at 0.02 mm / 0.1 rad the shells' lofts strayed 0.16 mm with ~7 deg between facets, which JLC3DP flagged as surface lines. Shells now 0.005 / 0.03 (max 0.02 mm, 2.8 deg p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
2026-10-21 CNC fits as 0.1 bands, JLCCNC holding +-0.05 at best: the rod's Ø3 and flat 0/-0.10, the flap's and crank's D-bores +0.10/0 (crank Ø3.05, flat 2.55), so the rod never comes out over its bores; drawin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
2026-10-22 Pit probe auto-detect (minimeat-seq.4.36, ADR 0008): pit_probe auto is the default, the finder names the pit probe among the jacks and locks it for the cook; until then the loop runs on the hottest p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
2026-10-22 Pan rear screw columns: the head channel left 0.75 mm to the fan shim block's face (JLC3DP's third review, B 0.75); the rear column is now Ø7 and bulges 0.45 mm into the plenum, a 1.35 mm sleeve. doc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
2026-10-22 mech-thinwall: every sub-1.0 mm spot on the print STLs, knife edges told from walls (0.25 mm samples, inward rays, acute CAD edges). Fixes what it found: the hood's front pilots open at the seam (a 0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
    [geom.py, params.py, shell.py, thinwall.py]
2026-10-23 I2C test pads (minimeat-72p): TP9 SDA and TP10 SCL on B.Cu west of the module's pins 20/21, outside the back-silk QR, labelled SDA/SCL in back silk; silk.py's TP label map brought up to the current r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
    [minimeater.kicad_pcb, minimeater.kicad_sch]
2026-10-23 SDA/SCL back-silk labels nudged 0.25 mm west (minimeat-72p)
    [minimeater.kicad_pcb]
2026-10-23 Fab outputs regenerated for the I2C test pads (minimeat-72p): B.Cu, B.Mask and B.Silkscreen carry TP9/TP10 and their SDA/SCL labels; BOM and CPL unchanged (test pads not assembled). Other layers diff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
2026-11-12 Vendor 3D models fetched, not committed (minimeat-0pe.1); repo URL minimeat -> minimeater in LICENSE, Cargo.toml and silk_back.py's QR (minimeat-0pe.2, board not yet regenerated)
    scripts/fetch_models.py (uv run --group models ...) installs the five EasyEDA board models by C-number through easyeda2kicad (a new `models` dependency group; each fetch is byte-identical to the file it replaces) and Noctua's and Hitec's models from a hand download (--from FILE or the vendor zip), each only if its SHA-256 matches. The files are gitignored at the same paths. Without them: mock.servo() is servo_box(), the scene and film have no fan rotor, fan_step() says how to fetch, and the tab-hole, scene-GLB and b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
    [film.py, scene.py]
2026-11-12 README exploded-view loop (minimeat-0pe.10): mech-explode renders docs/mech/explode.webp; glb colours sRGB -> linear
    The assembly turns once about z while it comes apart and goes back together, the enclosure 20% opaque when assembled and solid when exploded; transparent background. Cycles (film.py's settings) from scene.write's glb with the real board. Each frame is two opaque renders, without and with the shell, mixed at its opacity: a translucent material on a transparent film speckles (Cycles' alpha is stochastic and its denoiser leaves the alpha alone). A mid-tone palette of its own so every part reads on GitHub's light and dark pages; AgX Punchy. 480x360, 72 frames at 60 ms, lossy WebP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
2026-11-12 Board: QR on the back silk now reads HTTPS://GITHUB.COM/NATHANHOWELL/MINIMEATER (minimeat-0pe.2; still version 2, ECC L, 10 mm), with the in-progress board edits; hw/tools/art.py and its hw/art/ logo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
    [minimeater.kicad_pcb]
2026-11-12 Fab outputs regenerated (minimeat-0pe.2): B.Silkscreen carries the minimeater QR; F.Cu, B.Cu and In2.Cu the board edits committed with it; BOM and CPL unchanged. DRC errors: the same 8 starved_therma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
2026-11-12 README rewritten for the public repo (minimeat-0pe.6): what it does, a not-yet-built status warning, safety, how it is built, building and testing, contributing; KiCad 10 and the v1 enclosure; the co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
2026-11-12 Every routine command is a just recipe, nested by area (minimeat-0pe.12): py::, model::, mech:: (and mech::cfd::), hw::, fw:: (and fw::twin::, fw::interop::), stack::, vendor::; root test and ci aggr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
    Module files are <dir>/mod.just or <name>.just, never justfile, so running just inside a directory still finds the root. The fw modules run in fw/, the rest at the repository root. fw::test passes its args to cargo test when given (-p CRATE --test NAME). New: model::thermistor-table prints thermistor.rs's REFERENCE table from probes.py (it reproduces the committed one exactly), hw:: wraps the layout tools (KiCad's python ones via KICAD_PY). Docs, docstrings, generated-doc banners, runt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
2026-11-12 hw/tools/parts.py: no hardcoded home path (hw/ from the script's location, KiCad's stock footprints from KICAD10_FOOTPRINT_DIR or the Mac bundle); just hw::parts runs it (minimeat-0pe.7)
2026-11-12 DRC rules follow the a52ef73 renumbering (minimeat-0pe.5): the solid exposed-pad rule names the ESP32 module as U10 (it named U1, now an ESD part), and the one-spoke GND pads are U1 U2 U3 C23 U5 U7 R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
2026-11-12 Board: zones refilled and saved with the corrected rules (U10's exposed pad solid to GND)
    [minimeater.kicad_pcb]
2026-11-12 README: raytraced renders of the board's parts and silk sides (docs/hw, 90 + 60 KB); just hw::renders makes them (kicad-cli pcb render on a transparent background with the 3D models attached, downsca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
